pipidandan-superman/FPGA_2026_competition/report/figures/verified_fig_3_4.png

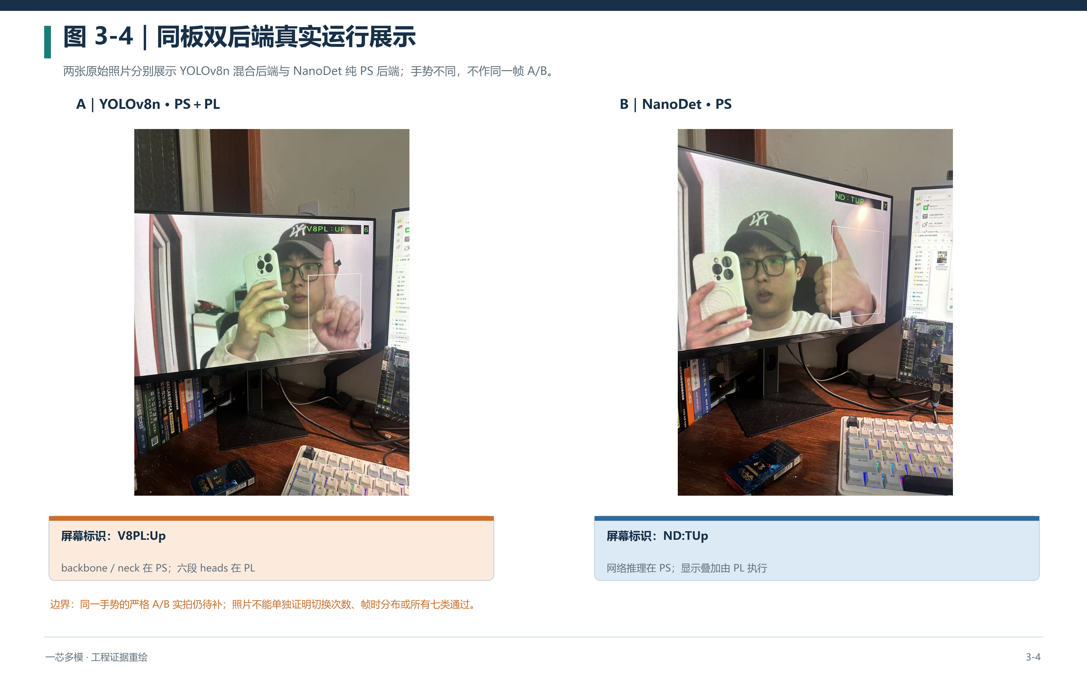
report/figures/verified_fig_3_4.png
