pipidandan-superman/FPGA_2026_competition/report/photos/photo_3_4a_dual_backend_1.jpg

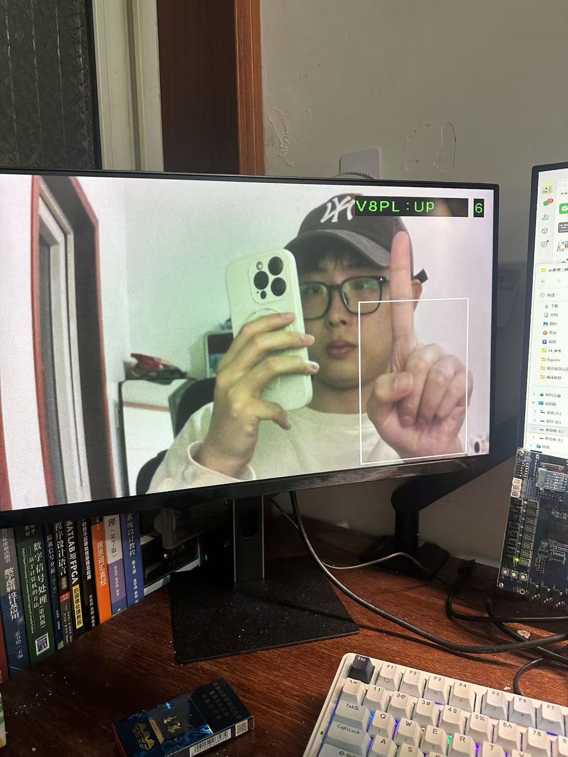
report/photos/photo_3_4a_dual_backend_1.jpg
