pipidandan-superman/FPGA_2026_competition/build/accelerator_ac1/reports/netlist_ff_fingerprint.txt

# routed-netlist fingerprint BID=INTEGRATION_AC1 PPU_ISLAND=1 IMPL_RUN=impl_ac2 (counts are design-dependent; ON baseline vs OFF comparison lives in the run README)
csr_awready_ff=2
csr_wready_ff=2
tick_cnt_ff=41
u_trace_cells=0
ring_ctx=0
ring_token=0
u_hbuf_cells=5784
u_hbuf_bram=8
wlay_dout_max=168
wlay_net_max=168
edge_node_ff=73
edge_win_ff=137
nedge_ff=6
slot_state_ff=125
slot_base_ff=296
slot_wm_ff=296
chain_rel_ff=2
s2l_ff=1
join_tab_ff=665
ppp_wp_ff=0
ppp_total_ff=0
frame_token_nets=33
ovf_ring_ff=480
ovf_tot_ff=43
knifeB_s1err_ff=65
knifeB_s1seen_ff=14
knifeB_s1node_ff=37
u_segd_cells=12
segd_commit_nets=1
commit_gate_nets=0
seg_done_pl_nets=4
cur_gen_q_ff=8
pl_mode_q_ff=2
desc_count_ff=18
u_ppu_cells=18926
u_ppu_dsp=10
u_ppu_bram=10
u_repack_cells=760
u_repack_bram=4
