pipidandan-superman/FPGA_2026_competition/skill/zynq-pynq-overlay-workflow/references/ees331.md

# EES-331 reference profile — verified scope, not universal defaults

Source workspace: E:/competition. Its workspace policy and daily-log override apply: raw evidence under 4_metrics/logs/<new-run>, engineering records under 7_logs/YYYY-MM-DD. Frozen project changes require explicit authorization.

## Board/runtime

- Zynq xc7z020clg484-1; Vivado 2025.2; PYNQ 3.0.1 / Linux 5.15.19, ARMv7.
- Existing design reference: 33.333333 MHz crystal, IO PLL multiplier 30, DDR 32-bit MT41K256M16 RE-15E. Check live values and generated configuration; do not blindly reinitialize running PS DDR/PLLs.
- Existing network: board 192.168.240.10/24, PC 192.168.240.2/24. These are configuration candidates, not discovery results. Since the 2026-10-02 lab-switch re-cable the board sits on DHCP behind the switch (observed address 192.168.240.10; the old direct-attach static path is gone) and the PC peer is REACHABLE — discover the board live (arp/SSH) instead of assuming. No credentials belong in this skill.
- Board swap 2026-09-23: a same-model replacement board runs the same SD card (static IP and /home assets migrate with it); its ARP MAC is 4a:ea:a7:ad:89:b1 (previous unit 46:2e:60:16:ac:3f). Treat the MAC as a liveness/identity probe read live from ARP, never as a fixed assumption. MAC-randomization update (2026-10-08, T12 run01): after a cold boot the replacement unit came up with a DIFFERENT, locally-administered MAC (36:10:06:56:3f:d3), so the ARP MAC is NOT a stable per-board identity across cold boots — verify the host instead by its console (FTDI COM port, getty prompt xilinx@pynq) and SSH banner (OpenSSH_8.9p1 Ubuntu-3), and treat an unexpected MAC on the expected IP as a re-randomization candidate, not proof of a foreign device. Evidence: 4_metrics/logs/2026-10-08_yolo_t12_wr_calib_run01 (reachability_diagnosis.md). P0-B baseline and B3-S1 window totals reproduced bit-identically on the replacement (4_metrics/logs/2026-09-23_yolo_p0b_newboard_run01).
- PYNQ Python: /usr/local/share/pynq-venv/bin/python3; application environment XILINX_XRT=/usr. Confirm on target.
- Original service ees331-camera runs /home/xilinx/ees331_camera/run_camera.sh and camera.py; it loads its own validated overlay and manages VDMA/CMA. Never overwrite its BIT/HWH/app for an independent test. **Regime change (2026-10-02 lab-switch re-cable, proven 2026-10-03): the camera's UDP peer 192.168.240.2 (the PC) is now REACHABLE, so the service streams PERSISTENTLY and no longer self-exits — the 2026-09-19 profile "streams then failed-terminal at ~70 s" is OBSOLETE under the new cabling (it only held while UDP was broken and camera.py timed out).** The zocl lock still auto-releases early (boot+~54 s, dmesg `unlocked, ref=0`) but the fabric VDMA keeps DMA-ing on the HP ports with no owning process (MM2S_DMACR 0x1008b, RS=1). Downloading any overlay under that live VDMA reconfigures fabric mid-AXI = the M13-proven whole-PS silent death (0-byte console, no sentinel, ARP silence; killed two S3d rounds on 2026-10-02 — the identical bitstream+driver passed once the camera was quiesced, exonerating the fabric). Quiescing canon when the service is live: `systemctl stop ees331-camera` (stop only, never disable; camera.py has a clean SIGTERM path request_stop → finally → VDMA_HALTED + BUFFER_FREED), then verify the halt at REGISTER level — resolve the axi_vdma_0 base via `Overlay(bit, download=False).ip_dict['axi_vdma_0']['phys_addr']` and read MM2S_DMACR/S2MM_DMACR (offsets 0x00/0x30, RS = bit0) through /dev/mem; require both RS bits clear AND both DMASR Halted bits (offsets 0x04/0x34, bit 0) set. Journal markers can be absent even after a clean stop — process exit and journal lines are not proof, registers are. Restore with `systemctl start ees331-camera` or the next cold boot (autostart untouched). Evidence: 4_metrics/logs/2026-10-02_yolo_p2_2_s3d_design_run01 (stop/verify/launch scripts + RUN_LOG).
- Original service restart reloads the original PL. Await streaming progress and physical HDMI, not merely active. Stop failures or DMA-not-halted reports block reconfiguration.
- Known PS console COM6 and PL USB-UART COM4 are historical assignments: enumerate current ports and verify their identity before access.

## PL clock (FCLK) register facts — probed on board 2026-09-19

- FPGA0_CLK_CTRL (SLCR 0xF8000170; FCLK1-3 at 0x180/0x190/0x1A0) layout, proven by an on-board refused-write experiment: **DIVISOR0 [13:8], DIVISOR1 [25:20], SRCSEL [5:4]** (0=IO PLL) — pynq 3.0.1 `ps.py ZYNQ_CLK_FIELDS` is the hardware truth; **bits [3:0] are reserved and write-ignored** (a write of 0x…05 read back 0x…00, and div1 was left 0 = undefined fabric clock until restored). `Overlay.download()` programs FCLK divisors from the HWH clock_dict and the write lands correctly — never "repair" it with a hand-rolled layout from memory.
- Probe-proven PLL constants (PLL_CTRL 0x100/0x104/0x108, FBDIV [18:12], ref = 33.3333 MHz crystal): IO FBDIV=30 → 1000.00 MHz, ARM 40 → 1333.33, DDR 32 → 1066.67; CPU = ARM/2 = 666.67. True FCLK = PLL / (div0 × div1).
- **pynq 3.0.1 reports every MHz 1.5× high on this board** (`_ClocksZynq.DEFAULT_SRC_CLK_MHZ = 50.0` vs the actual 33.3333 crystal): reported 150 = true 100, reported 75 = true 50. `Clocks.fclk0_mhz` can also raise ZeroDivisionError when the divisor product is 0. Gate frequency on the raw register + PLL-derived true MHz; log pynq's report as informational only. Raw /dev/mem + sudo is the standalone probe path (pynq MMIO raises "No Devices Found" with no zocl device open; bare xilinx user gets PermissionError on /dev/mem). On some boots the kernel blocks /dev/mem access to the SLCR range even as root (PermissionError on the 2026-10-03 S3d boot) while plain MMIO-region reads still work — on such a boot fall back to the HWH/PCW parameters for clock facts instead of forcing the register read.
- Reference states seen on this board: boot FPGA0 = 0x00101400 (IO÷20 = true 50 MHz); FPGA1-3 boot residual 0x00100F00 (IO÷15 = 66.67 MHz); after downloading an HWH with (div0=5, div1=4) the register is 0x00400500 = true 50 MHz; with (5, 2) it is 0x00200500 = true 100 MHz. Evidence: `4_metrics/logs/2026-09-19_yolo_gemm_freq_run25_fclk100/` (three-attempt CK_F narrative incl. the self-correction).

## Camera overlay hot-reload: proven load sequence

A camera/VDMA overlay loaded while Linux runs needs more than a successful bitstream download. v1.3 proved that BIT download plus fpga_manager `operating` can still fail first-frame recovery (`FIRST_FRAME_TIMEOUT`, both slots static, seen=[false,false]) and be misread as "cannot load online". The proven sequence (PL Reloader v1.4, 2/2 board acceptance) is:

1. Stop the original ees331-camera service safely: require an active camera.py owner, then journal evidence of VDMA_HALTED followed by BUFFER_FREED — and, as the hard gate, register-level RS=0 in both DMACRs (see the camera bullet under Board/runtime for the /dev/mem read); otherwise abort; restore only after ownership release and register halt are proved.
2. Build `Overlay(bit, download=False)`, validate the HWH hardware contract and VDMA parameters (C_NUM_FSTORES 3, C_INCLUDE_SG 0, 24-bit MM2S/S2MM, genlock 3/2) from ip_dict before downloading.
3. `download()`, then require `/sys/class/fpga_manager/fpga0/state` == `operating`.
4. Wait an explicit ~10 s sensor settle before touching VDMA: hot reload loses the bare-metal implicit SCCB/sensor settling. This is a timed diagnostic gate, not proof that SCCB/PCLK/VSYNC are healthy.
5. Configure VDMA/CMA, then gate READY on a ~30 s first-frame window with ~1 s progress reports of both buffer slots; success requires real frame transitions, never service `active`, download completion, or file-sync markers.
6. On FIRST_FRAME_TIMEOUT/FAIL/DEGRADED: stop VDMA and prove both channels Halted before freeing buffers or restoring the original service. If halt cannot be proved, retain the process and buffer, block restoration, and diagnose. Require stream progress and physical HDMI confirmation after a valid restoration; UDP reception is a separate test.

For the fixed action payload use 8_tools/EES331_PL_Reloader_v1.4 (source 3_host/pynq/pl_reloader) rather than re-deriving this sequence. Constants in payload camera.py: SENSOR_SETTLE_SECONDS 10.0, FIRST_FRAME_TIMEOUT_SECONDS 30.0, FIRST_FRAME_PROGRESS_SECONDS 1.0.

Evidence in 4_metrics/logs: 2026-09-13_pl_reloader_v13_board_failure_audit_run01 (download PASS + first frame FAIL), 2026-09-13_pl_reloader_v14_board_acceptance_run01 and run02 (A→C success, run02 after confirmed power cycle).

## PS-only overlay baseline and proven stable reload flow (7x verified 2026-09-18)

A minimal PS7-only overlay (project `2_fpga/3_yolo_zynq/proj/yolo_zynq_test`, BD `display_test`) is the verified clean PL baseline. It was hot-reloaded **seven consecutive times without power cycling** — 5 cycles via `overlay_reload_gate.py` (run02) plus 2 full skill-literal rounds with fresh artifact directories per round (run03) — every reload gated on download return + `operating` + fresh dmesg lock, followed by ping/TCP/UDP/UART function probes, all PASS. User independently confirmed UART and Ethernet host-tool loopback on the final state. Evidence: `4_metrics/logs/2026-09-18_yolo_zynq_test_ps_overlay_run01` (first load + helpers), `..._run02_reload5x`, `..._run03_skillflow`.

Proven per-reload procedure (this IS the stable flow; scripts live on the board under `~/overlay_test/` and `~/overlay_skill_round_*/`):

1. Historical preflight recorded a failed-terminal service in that September run. Discover current boot ID, service state, FPGA state and owners anew.
2. Fresh independent directory per round; upload bit + same-basename HWH pair; sha256 both sides must match byte-for-byte.
3. Ownership: the historical no-client inference was insufficient. Always inspect DMA registers for the currently loaded design; absence of process clients does not establish a halted DMA.
4. Load as **root** via `/usr/local/share/pynq-venv/bin/python3` with `XILINX_XRT=/usr`: `Overlay(bit, download=False)` → verify HWH contract (`ip_dict == ['processing_system7_0']` for the minimal design) → `.download()`.
5. Gate the reload on all three: `download()` returned, `fpga0/state == operating`, **dmesg `zocl … 'locked, ref=1'` count incremented by exactly 1** (each download logs a fresh UUID, so the count is a per-reload download proof; `operating` alone never proves a load).
6. Function probes per the design contract (PS-only: ping, TCP+UDP echo :7777, `/dev/console` marker).
7. Repeat back-to-back without power cycling; no cross-cycle degradation observed in 7 consecutive reloads.

Load mechanics proven on this image (PYNQ 3.0.1): `Overlay.download()` configures PL clocks **before** downloading the bitstream, so a failure at `Clocks.set_pl_clk` (`OSError: Root permissions required` when not root) means **nothing was loaded**. Run the load as root (sudo takes its password on stdin); `/dev/console` milestone writes also require root. PS-only HWH parses fine. A BIT load does not replay the complete PS7 initialization or safely reinitialize DDR/MIO. PYNQ applies selected HWH clock metadata separately; compare the running PS configuration and candidate HWH before loading. The historical PS configuration was: UART1 MIO 48/49, ENET0 MIO 16-27 + MDIO 52-53 + reset MIO 47, IO PLL x30 (1000 MHz, boot-matching), FCLK0 disabled is the verified-safe PS-only set; effective clocks must match the running system before loading any new PS7 config.

Loopback helpers for host-side UART/Ethernet verification live on the board at `~/overlay_test/` (`net_echo.py` TCP+UDP echo on :7777; `uart_echo.py` raw 1:1 echo on `/dev/ttyPS0`, which requires stopping `serial-getty@ttyPS0` first — that silences the COM6 console until restarted). Stop `uart_echo.py` by PID: a SIGTERM kill skips its `finally` termios restore, so prefer Ctrl-C at its console or a signal handler that restores the port; never use `pkill -f <script>.py` from a remote shell — it matches the shell's own command line and kills it mid-chain. A nohup launch chain can hang the ssh client while the service actually started; verify with a separate `pgrep`/port check instead of trusting the launch command's exit.

## Independent AXLT ABI

Project: E:/competition/2_fpga/2_axi_lite_test; BD AXI_LITE_test; CSR 0x43C00000/4KiB, read from HWH rather than hard-code in reusable drivers. IP_ID 0x41584C54, ABI 0x00010000, CAPS 1 (register-only). Command produces bitwise complement; nonzero increasing sequence, DONE held until ACK. BRAM is not implemented.

Compile mmio_ordered.c on ARM with `cc -std=c11 -O2 -Wall -Wextra -Werror -fPIC -shared mmio_ordered.c -o libmmio_ordered.so`. It uses device-MMIO volatile accesses and DSB barriers while PYNQ owns the mapping. Use the delivered hardware_contract.py before downloading.

## PC-side (Windows) automation pitfalls — all verified 2026-09-18

Driving the board from Windows PowerShell over ssh has three quoting
traps that each cost a failed round before being identified:

1. **PowerShell double-quoted remote commands evaluate `$(...)`
   locally.** `'... $(systemctl ...) ...'` must be single-quoted as a
   whole so the subexpression reaches remote bash.
2. **PowerShell -> ssh native argument passing strips embedded double
   quotes.** `sudo -S sh -c "VAR=x cmd"`, `python3 -c "..."`, and any
   remote command containing `"` break with baffling bash syntax
   errors (`unexpected EOF while looking for matching '"'`). Rules:
   single-quote the entire remote command; keep it free of ALL inner
   quotes (use `env VAR=x cmd` instead of `sh -c "VAR=x cmd"`); upload
   anything nontrivial as a FILE and execute it — never inline
   `python3 -c` one-liners through ssh from Windows.
3. **PowerShell piping a string to ssh stdin appends `\r`, so
   `'<pw>' | ssh host 'sudo -S cmd'` fails sudo authentication.** Use a subprocess byte stream with an explicit LF to supply sudo -S on stdin;
   never interpolate a password into shell command text. The SSH login uses the askpass env
   pattern (SSH_ASKPASS + SSH_ASKPASS_REQUIRE=force + DISPLAY set,
   password only in the per-call subprocess environment).
4. **Windows OpenSSH cannot exec a `.py` askpass directly (CreateProcessW
   error 193).** Point SSH_ASKPASS at a `.cmd` wrapper that invokes the
   python askpass script (`3_host\pynq\pl_reloader\ssh_askpass.cmd`).

## PYNQ 3.0.1 HWH contract keys

For a module-reference IP in `Overlay.ip_dict`:
- base address key is **`phys_addr`** (int), NOT `phys` — a `.get('phys')`
  returns None and falsely fails the contract gate (cost one round).
- aperture size key is `addr_range`; `parameters` carries
  `C_BASEADDR`/`C_HIGHADDR` (hex strings) and `PROTOCOL: AXI4LITE`.
- The interface's `FREQ_HZ` parameter reflects the actual PS7 FCLK the
  BD propagated (this project's preset: 50 MHz even with
  PCW_FCLK0_PERIPHERAL_FREQMHZ absent/dynamic in the BD Tcl) — the
  bitstream's timing closed at that frequency; do not assume 100 MHz.

## Concrete failure and proven correction

2026-09-13 run01 lost communication during the first full test. The recovered event file had a valid PREFLIGHT record plus NUL/truncated data, no result.json; the host's buffered logging lost partial stdout. Do not infer an exact failure instruction from that incomplete record.

Inspection found proc_sys_reset `C_AUX_RESET_HIGH=0` with aux_reset_in tied 0. Download-only subsequently succeeded with network alive. An official generated IP simulation simultaneously proved the faulty wiring holds reset and the corrected tie 1 releases reset and permits two CSR identity reads. Corrected BIT/HWH passed 1000 register commands and 3 reloads; after service restoration UDP yielded 60 complete changing frames with zero CRC/loss/header errors. Physical HDMI is separately recorded in the run's acceptance report.

The corrected release uses const_one for auxiliary reset and dcm_locked, const_zero for debug reset. Both external and auxiliary resets are active-low. Beware Vivado HWH constants may be hexadecimal (`0x1`); compare numeric values, not literal spelling.

Evidence in E:/competition/4_metrics/logs:

- 2026-09-13_axilt_reg_board_run01: initial failure retained.
- 2026-09-13_axilt_recovery_run01: original event fragment, download-only markers, live PS state.
- 2026-09-13_axilt_reset_sim_run01: official-IP defect reproduction and corrected CSR simulation.
- 2026-09-13_axilt_reset_fix_build_run01: corrected BD, timing, hashes, prior release backup.
- 2026-09-13_axilt_reg_board_run02: 1000 commands/3 reloads, event audit, 15 Python tests, video restoration.

These local evidence links are provenance. If unavailable in another workspace, obtain that project's own evidence rather than claiming these runs validate a different board or design.
