pipidandan-superman/FPGA_2026_competition/report/README.md

# report/：设计报告与大模型协作记录

本目录对应 AMD §3.3.5.3 和 §3.3.5.4 的设计报告与协作记录要求。文件名使用英文小写，正文保留中文。

## 文件

| 文件/目录 | 内容 |
|---|---|
| `technical_report_v8.docx` / `.pdf` | 当前正式报告：OPU 组织思想及引用、同 BIT 在线切换、五类工程、优化对比、锁布局消融、AI 协作、Skill 提炼和复现入口；41 页、18 图、16 表、14 项独立著录参考文献 |
| `technical_report_v4.docx` | 历史技术报告，保留用于版本追溯 |
| `ai_collaboration_records_summary.md` / `.docx` | 多平台大模型协作归纳，含提示词、回答、失败观察、自我纠错和证据边界 |
| `amd_ross_reflections.md` | AMD ROSS 使用心得 |
| `figures/` | 报告架构、微架构、调度、训练、性能、资源和协作机制图件 |
| `photos/` | 板卡与演示实拍；历史版本照片在正文中明确标注，不冒充当前位流验收 |

## 当前验证

- V8 正式报告含 **18 张嵌入图**，图内不重复标号，图下保留编号；开发板实物位于 2.2.1，工程二注明与图 2-6 同架构；2.6.5 含锁布局消融分组表和结果对比图。
- DOCX 完整结构验证通过；41 页 PDF 全部检查，无空白页、内容丢失、裁切或重叠；九项模板限字全部通过。
- 最终 MinerU 结果为 `MINERU_PARSE_PASS`，输入 SHA-256、Markdown 和 content JSON 在 `2026-11-04_report_v8_reference_layout_run02` 留档。
- 报告区分历史板测、本次 Vivado 工程验证、完整 BIT 重建和未执行项目；纯 PL 连续日志只覆盖六类，缺 Down；多网络不同任务切换仍属未验证方向。

## 协作记录口径

案例覆盖 Claude Code、ChatGPT/Codex、Kimi、Zcode 等平台。逐字摘录与二手归纳分别标记；包外原始会话索引仅用于作者侧溯源，不冒充完整原始会话交付。密钥、凭据和私有配置不纳入公开仓库。
