pipidandan-superman/FPGA_2026_competition/src/host/README.md

# AI PC 侧（3_host）调研启动文档

> 负责人：本队 AI PC 分工成员 ｜ 硬件已到位：MINISFORUM UM790 Pro
> 目标对齐：README 量化指标（mAP@0.5:0.95 ≥ 0.7，单样本推理 ≤ 30ms，batch=1）

## 1. 硬件档案（UM790 Pro —— 状态：**未到位**）

| 项目 | 规格 | 对本项目的意义 |
|---|---|---|
| CPU | Ryzen 9 7940HS，8C16T，Zen4 | 后处理/业务逻辑 |
| iGPU | Radeon 780M（RDNA3, gfx1103, 12CU） | 备选推理后端（DirectML/ROCm） |
| NPU | XDNA 第一代（Phoenix AIPU，约 10 TOPS） | **主推理后端**（INT8） |
| 内存 | DDR5 5600 双通道（可至 64GB） | 模型与图像缓冲 |
| 网口 | RJ45 2.5G ×1 | 与 FPGA 的 UDP 通信链路 |
| 系统 | 预装 Windows 11 | Ryzen AI Software 官方路径 |

**合规性**：7940HS 属 Ryzen AI（Phoenix）平台，符合赛题"任意 AMD Ryzen AI PC，型号不限"；属自备机，不影响中期 AI PC 借用申请（10-09，Max+395/HX370 十台名额）。

**合规红线**：评分项"AI PC 端侧 AI 能力（20 分）"要求模型**在 AI PC 本地运行**且考察**离线运行能力**。服务器/云端只能用于训练与调优，推理必须在 AI PC 本地。决赛演示须断网可跑。

### 1.1 当前无目标机：服务器先行策略

现状：只有组内服务器（CPU 型号与目标机不同），UM790 Pro 在谈。**阻塞是有明确边界的**：

| 工作项 | 服务器可做？ | 说明 |
|---|---|---|
| 数据集采集/标注/增广 | ✅ | 手机/公开数据起步，与硬件无关 |
| YOLO 训练/微调/精度调优 | ✅ | 用服务器 GPU，产出与目标机无关 |
| 导出 ONNX + 功能验证 | ✅ | ONNX Runtime CPU EP 即可等价验证 |
| INT8 量化（calibration） | ✅ | 量化校准跑 x86 CPU，不需要 NPU |
| 预处理/后处理/UDP 协议栈 | ✅ | 纯软件，mock 联调可两台服务器对跑 |
| **NPU 部署栈验证**（驱动/EP/算子支持） | ❌ | XDNA NPU 是目标硅片专属，无实用模拟器 |
| **INT8 精度在 NPU 上复现** | ❌ | 量化精度损失只能在目标机确认 |
| **延迟/FPS/功耗实测**（metrics 证据） | ❌ | 必须在 AI PC 上测，服务器数据无效 |

**结论：阻塞的只是"目标机部署验证与性能实测"这一段（约占总工作量 30%），其余 70% 立即开工。**

三条并行解法：
1. **服务器先行**：把模型选型、数据、训练、ONNX 定稿、量化、CPU EP 全链路 pipeline（含 UDP mock）在 9 月内做完，把"目标机适配"压缩成一个清单化的晚期任务
2. **落实 UM790 Pro**：明确到位 deadline=**2026-09-20**（NPU demo 里程碑）；谈不下来评估自购（迷你主机价位 ~3k）或借用
3. **官方借用兜底**：10-09 中期申请报告全力写好——评审通过发 Ryzen AI Max+ 395 / HX 370 整机；即使 UM790 到位，借用机也是性能更强的备选

风险预案：若 9-20 仍无目标机，先用 ONNX Runtime CPU EP 打通"收帧→推理→回传指令"全链路（功能正确性不受阻），NPU 量化部署顺延；同时核对 YOLOv8n 算子集在 Ryzen AI 编译器的支持清单，备好 YOLOv5n 退化方案。

## 2. 应用场景选型（建议）

**桌面级彩色几何积木分拣**（视觉识别与自动分拣的落地形态）：

- 类别：红/蓝/绿/黄 4 色积木（可选扩展形状：方块/圆柱）
- 理由：①数据集可自采自标（OV5640 现成，几百张即可起步）；②演示直观、评审友好；③与 4-DOF 舵机臂复杂度匹配；④纯色块对 YCbCr 转换/光照不敏感，检测稳定
- 工位设计：FPGA 摄像头俯拍传送带/分拣盘，AI PC 检测 → 输出目标类别 + 像素坐标 → 换算抓取策略下发

## 3. 模型选型（建议）

| 优先级 | 模型 | 理由 | 风险 |
|---|---|---|---|
| 主选 | **YOLOv8n**（Ultralytics） | COCO 预训练成熟；ONNX 导出顺畅；640 输入小模型够用；社区量化经验多 | Ryzen AI EP 对新算子支持偶有滞后 |
| 备选 | YOLOv5n | Ryzen AI 官方示例级兼容，量化链路最成熟 | 结构较老 |
| 观察 | RT-DETR / 轻量 Transformer | 组内有 Transformer 经验 | NPU INT8 支持差，当前阶段不用 |

**部署链路**：PyTorch 训练（可在学校服务器）→ 导出 ONNX → Ryzen AI 量化（INT8）→ ONNX Runtime + VitisAI EP 跑 NPU（Windows）。

**性能预期（需实测填入 metrics.csv）**：
- YOLOv8n INT8 @ NPU：单帧 ~10–20ms（batch=1）
- 后备链：DirectML 跑 780M iGPU；再后备 CPU 8 线程
- 三条后端的延迟/精度对比表本身就是"FPGA/端侧贡献"之外的加分证据

## 4. 通信（与 FPGA 侧对齐）

- 链路：UM790 Pro 2.5G RJ45 ←网线直连→ EES-331 PS 千兆口（静态 IP，点对点）
- 协议：UDP（README 定的 RTT < 5ms）
- 起步：FPGA → AI PC 传整帧（640×480 YUV422 ≈ 600KB/帧，30fps ≈ 18MB/s，千兆余量充足）
- 演进：FPGA 侧 CNN/预处理就位后改为传特征/检测框，压缩带宽与延迟
- 待 FPGA 侧确认：EES-331 网口 PHY 型号与驱动（PS GEM）

## 5. 里程碑（对齐 1_docs/timeline_milestones.md）

| 目标 | 时间 |
|---|---|
| 服务器上：YOLOv8n COCO 预训练跑通 + ONNX 导出 + CPU EP 推理验证 | 2026-09-13 |
| 服务器上：UDP 协议栈 + mock 联调（帧格式/指令格式定稿） | 2026-09-20 |
| 自采分拣数据集 v1（≥500 张）+ 微调 + INT8 量化 + 精度对比 | 2026-10-06 |
| 目标机到位（UM790 Pro 或借用机）：NPU 部署 + 三后端延迟实测 | 随机器到位，越早越好 |
| 与 FPGA 侧 UDP 链路联调（收帧 → 推理 → 回传指令） | 2026-10 月中 |

**主机到位 deadline：2026-09-20**（超出则走 CPU EP 预案，NPU 部署顺延但绝不空等）。

## 6. 开放问题

- [ ] Windows 11 还是 Ubuntu？（Windows：NPU 官方支持最稳；Ubuntu：与 PYNQ/FPGA 工具链同生态、ROCm 原生。建议先 Windows 跑通 NPU，后期按联调需要评估）
- [ ] Ryzen AI Software 版本与 7940HS NPU 驱动配套（记录版本号进 metrics 测量条件）
- [ ] 自采数据的类别定义与标注工具（建议 LabelImg/Roboflow， early 固定类别表）
- [ ] 检测坐标 → 机械臂坐标的手眼标定方案（等机械臂到位后启动）
