pipidandan-superman/FPGA_2026_competition/report/ai_collaboration_records_summary.md

# 大模型协作交互记录归纳总结（V2.0）

**作品名称：一芯多模——面向资源受限 Zynq 平台的多网络视觉推理与在线切换系统**
**协作平台：Claude Code、ChatGPT／Codex、Kimi、Zcode**
**版本：V2.0（四平台本机原始记录核对版）**
**整理日期：2026-11-03**

## 编制说明

本文件依据工作区工程日志、审计报告、仿真与板测证据，以及**四平台在本机的原始交互记录**，对项目开发过程中的大模型协作进行归纳，重点保留提示词、模型回答、失败观察、自我纠错、人工复核与分层验收之间的关系，而不是只罗列最终成功结果。

**V2.0 相对 V1.0 的修订要点**：

1. V1.0 成稿时标注了两处证据缺口（"Zcode 原始会话尚未检索到"、"Codex 部分原始会话文件已不在原记录路径"）。V2.0 已在本机完成四平台原始存储的定位与只读抽取归档，**两处缺口全部补齐**：Codex 历史会话以 zstd 压缩格式存放于 `~/.codex/sessions`（V1 检索时被遗漏），Zcode 会话存于本地 SQLite 数据库。V1.0 作为历史快照保留，正式提交以本版为准。
2. 引号内文字均为原始记录逐字摘录；标注"据工程记录概括"的提示词与回答为二手摘要，不冒充逐字对话。
3. **脱敏与安全边界**：全部抽取脚本对 API 密钥形态字符串（`sk-…`／`pk-…`／`eyJ…`）做正则替换为 `[REDACTED-KEY]`；`~/.codex/auth.json`、Zcode `config.json` 的 apiKey 与证书、Kimi 桌面端 token-store 等敏感库**绝不复制**，只以只读方式打开会话库。
4. **ChatGPT 口径**：本机可核验的 ChatGPT 家族工具为 Codex CLI／桌面端（rollout 会话记录）；网页版 ChatGPT 在本机无会话存储，不纳入本文件，也不以其他平台记录冒充。

## 一、提交要求与总体协作模式

竞赛要求提交能够体现大模型协作过程的交互记录，包括提示词、模型回答与自我纠错轨迹，并将协作经验沉淀为可复用 Skill。技能包应说明适用范围、使用方法、失效条件和已验证效果。

本项目采用"人工定义目标与边界 → 大模型生成方案或代码 → 真实工具执行 → 原始证据检查 → 模型或人工纠错 → 分层验收 → Skill 沉淀"的协作模式。大模型不是最终验收者：仿真、构建、板测和用户实机目检分别承担不同层级的验收职责。

### 1.1 四平台本机原始记录覆盖（V2.0 实测清点）

| 平台 | 本机原始存储 | 规模（实测） | 工程相关范围 | 抽取归档产物 |
|---|---|---|---|---|
| Claude Code | `~/.claude/projects/E--competition/*.jsonl` | 22 个会话，487.6 MB，1575 条用户消息 | 2026-10-11 → 11-03（另 09-30 起经 ROSS 委派参与） | `claude/sessions_index.csv` |
| ChatGPT／Codex | `~/.codex/sessions/YYYY/MM/DD/rollout-*.jsonl(.zst)` | 340 个 rollout（全机全部项目） | 157 个工程 rollout，2026-09-01 → 10-11（含早期 Desktop 工作区时期） | `codex/all_sessions_index.csv`、`codex/landmark_sessions_full.jsonl`（73 个关键日会话全文 1763 行）、`codex/thread_turns_errors.csv`（176 条失败轨迹） |
| Kimi | kimi-desktop 桌面端会话库 + `…\daimon\agents\main\memory\transcripts\days\` | 35 个会话、44 个转录日 | 18 个工程工作区会话（2026-10-26 → 11-03 密集期；10-12 起使用） | `kimi/conversations.csv`、`kimi/landmark_days_full.jsonl`（5 个关键日 5269 行） |
| Zcode | `~/.zcode/cli/db/db.sqlite` | 22 个会话 | 10 个工程会话，1147 条消息，2026-09-08 → 09-21 | `zcode/sessions.csv`、`zcode/competition_messages.jsonl`、`zcode/openings.txt` |

以上抽取产物全部位于证据目录 `4_metrics/logs/2026-11-03_ai_collab_v2_run01/`，只读抽取、密钥脱敏，不动原始存储。

### 1.2 协作时间线与项目方向演进

项目的选题方向本身经历了两次用户裁定的转向，构成最高层级的"自我纠错轨迹"；四个平台的入场与退场时间与之对应：

| 时间 | 方向／事件 | 主力平台 |
|---|---|---|
| 2026-09-01 前 | 初始选题：紫光同创 Logos-2 任意角度实时视频畸变矫正（RK3568 平台） | Codex |
| 2026-09-02 | **第一次转向**：改投 AMD 具身智能赛道（§3.2，作品名"锐眼·智行——具身智能分拣"）；GitHub 仓库恢复关联并改名 `FPGA2026_competition` | Codex（案例 X-01） |
| 2026-09-08 | GitHub 协同准则建立并于当日按用户要求简化；OV5640 寄存器配置审计；Zcode 首次入场做工程速览与以太网色差分析；Codex 发生编辑工具循环故障 | Codex、Zcode（X-02／X-03／X-05／Z-01） |
| 2026-09-09 → 09-14 | PYNQ 概念与部署计划梳理、FSBL/BSP 生成位置、工程完成比例盘点、YOLO 输入尺寸核查；SD 部署包 16 GB 损坏应急 | Zcode（Z-02／Z-03）、Codex（X-04） |
| 2026-09-19 → 09-21 | 主线 SPEC 与冲刺排期；09-21 GitHub 分支管理失控，排查并恢复队友分支（与 7_logs 事故记录互证）；当日沉淀 github-upload-policy v2（双人分支互批） | Zcode（Z-04／Z-05）、Codex |
| 2026-09-30 → 10-11 | Claude 经 ROSS 委派承担 B3-S3 方案审计与 RTL lint；Codex 平台故障频发（176 条错误轨迹），10-11 起 Claude Code 转为直接工程席位 | Claude（C-01／C-02／C-04） |
| 2026-10-12 → 10-18 | Kimi 入场：报名材料、赛题指南解析、ViT 加速器论文对照分析 | Kimi |
| 2026-10-14 | **第二次转向**：§3.2 旧口径停止执行，切换为 §3.3 自主选题·高级组"一芯多模"（README 切换声明留档） | 用户裁定 + 全平台 |
| 2026-10-26 → 10-29 | Kimi 作为"策略外脑"密集会话：硬件框图、技术报告、整图推理问题梳理（催生 3 天冲刺最终 SPEC）；Claude 主工程席 + 独立审计席双席互审 | Kimi（K-05）、Claude（C-05） |
| 2026-10-29 → 11-03 | 冲刺收官：完整 PL 推理实测 4.2671 s、三网络三任务 OSD、PS+PL 混合推理、报告 v4、§3.3.5.4 提交包打包、本归纳 V2.0 | Claude、Kimi（K-01～K-04） |

## 二、各平台协作分工概述

### 2.1 Claude Code

承担三类任务：一是对方案和已有工程进行只读审核（早期经 ROSS 委派，10-11 起直接入场）；二是通过 ROSS／Vivado MCP 执行 lint、仿真和状态检查；三是对"完成"结论进行独立复核。后期演化为"主工程席 + 独立审计席"双会话互审结构（案例 C-05）。其价值不仅是生成代码，更在于发现执行链、验收范围和证据链中的问题。

### 2.2 ChatGPT／Codex

工程前期（09-01 → 10-11）的主力席位：工程初始化、GitHub 管理、摄像头寄存器审计、SD 部署应急、Overlay／PYNQ 工作流与项目规则沉淀。典型纠错包括编辑工具误用循环、位流下载成功被误当系统功能成功，以及平台自身的基础设施故障（176 条错误轨迹，案例 X-07）——后者直接推动了 10-11 向 Claude Code 的席位迁移。

### 2.3 Kimi

三线并用：一是工程执行（三任务 OSD 修复、完整 PL 性能优化、PS+PL 混合推理，案例 K-01～K-03）；二是**策略外脑**——在关键决策点用独立会话对工程现状做只读梳理与重规划（案例 K-05），与其他席位的执行结论形成交叉检验；三是报告与表达（技术报告、创新点提炼、配图、评分预估）。

### 2.4 Zcode

轻量快答与资料定位席位（09-08 → 09-21，10 会话 1147 条消息）：工程速览、概念答疑（PYNQ／FSBL／bundle）、配置核查（YOLO 输入尺寸）、进度盘点，以及两次危机排查（以太网色差、GitHub 分支失控）。特点是从不直接改工程，先读 README／HANDOFF 与既有文档再回答，回答可回溯到仓库内具体文件。

## 三、Claude Code 代表交互与纠错轨迹

### C-01：RTL Lint 中空报告被解析器误读出两条记录（2026-10-03，ROSS 委派）

**任务提示词（原始提示词节选）**

> "Use the vivado-rtl-lint skill … Task: lint one RTL file in non-project mode … Use vivadoExecute for ALL Vivado commands … Never create .tcl files … Violation count in the markdown must exactly match Vivado's stated total; if Vivado says 0, report 0."

**模型回答与执行**

模型通过 Vivado MCP 启动 TCL 会话，以非工程方式读取 `yolo_silu_lut.v`，执行 `synth_design -lint`，再调用解析脚本生成 CSV。Vivado 原始报告给出 `Total of 0 linter message(s) generated.`，最终 lint 结果为 0 error、0 warning、0 violation。

**失败观察与自我纠错**

解析脚本在"零违规"空表上生成了两行伪 CSV 数据。模型没有直接把两行写成违规，而是核对 Vivado 原始总数，确认它们来自 `create_waiver` 帮助页脚，是解析器在空表边界上的误切片。随后重新生成真正的零行 CSV，同时保留原始错误输出 `lint_report.csv.raw-parser-output.txt`，使"CSV 行数＝Vivado 总数＝Markdown 数量＝0"。

**最终证据**

- `11_AMD_Ross_AgenticAI/evidence/2026-10-03_rtl-lint/nested_session_transcript.jsonl`
- `11_AMD_Ross_AgenticAI/evidence/2026-10-03_rtl-lint/rtl_lint_report.md`

该案例体现了"自动解析结果不能凌驾于原始报告"，也形成保留失败输出、禁止为凑结果删除证据的规则。

### C-02：B3-S3 方案从"单帧三描述符"纠正为"三帧真实桥接"（2026-09-30）

**任务提示词（据工程记录概括）**

对 B3-S3 设计书、能力盘点、L2 原始板测、驱动和 r9 RTL 进行只读工程审核，判断载体复用和门梯是否合理，不修改冻结工程。

**模型回答**

审核结论为"D1 有条件通过；原 S3a 不通过；门梯需修订后才能开工"。复用 r9 作为唯一位流载体合理，但把 L2 三段写成单帧内三个 descriptor，无法插入真实的 PS gather、buf patch 和 repack 操作，不能证明生产者输出被消费者真实使用。

**纠错轨迹**

原方案以"单帧三 descriptor 连续执行"作为 L2 级联门。审核后改为：

`frame A conv0 → 完成并闭帧 → PS gather／HWC＋buf patch → frame B mp5 → 完成并闭帧 → PS repack＋mirror patch → frame C conv1`

同时保留 walker-only 多描述符协议测试，但其结果只能命名 `WALKER_MULTI_DESC_PASS`，不能升级为 `L2_CHAIN_PASS`。

**最终证据**

- `4_metrics/logs/2026-09-30_b3s3_claude_audit_run01/AUDIT.md`

沉淀规则："协议测试不能替代真实数据链测试""预载数据不能证明生产者—消费者闭合"。

### C-03：M9"全线收官"结论被独立审计降级（2026-10-09）

**任务提示词（据工程记录概括）**

严格审计 M9 的板测、XSim、RTL、Vivado 实现记录和验收范围，核对"M9 全线收官／M9_INTRA_PASS"是否有充分证据。

**模型回答与纠错**

审计确认代表性 Conv 数据通路在板上可运行，但否定"层内流水已在板上闭合"和"完整 M9 收官"：板上只覆盖 5 个代表 Conv 而非完整 63 Conv；XSim 的 overlap 结果不能替代板上 overlap 证据；连续第二帧计数翻倍说明计数器清零与代际语义未闭合；最终 BIT 哈希、板端时钟和完整 post-route 报告没有形成统一制品链；"5.55 fps 整网代表层"被纠正为"5 Conv 代表 walk 首帧约 180 ms"。最终结论限制为条件化的 `BOARD_REPRESENTATIVE_CONV_PASS`。

**最终证据**

- `4_metrics/logs/2026-10-09_yolo_m9_claude_audit_run01/REPORT.md`

该案例说明模型已经写出的"PASS"也必须接受另一轮证据审计，不能由提交说明或单次首帧结果扩大验收范围。

### C-04：ROSS 仿真从重复命令错误转向结构化三段式流程（2026-10-11）

**任务提示词（原始提示词节选，本机会话记录）**

> "Use connected vivado-mcp only. Inspect M9.1 Face B stale run … If stale, rerun through Vivado"
> "Use only the connected vivado-mcp structured tools vivado_list_sessions, vivado_connect, vivado_start, vivado_execute, vivado_status, and vivado_log_messages. D…"

**初始回答与失败**

初期出现重复的无效 `set_property` 语法／选项错误，随后 `launch_simulation` 在 XSim 编译子进程阶段出现 `ERROR: [Common 17-180] Spawn failed`。上游 Claude 服务还出现 HTTP 429 限流。

**纠错轨迹**

1. 停止重复相同错误，不将"会话已连接"当成仿真通过。
2. 检查 MCP 子进程环境，确认仅配置 `VIVADO_PATH` 不足以保证 XSim 子进程可执行。
3. 修复 Vivado `bin` 与 `bin\unwrapped\win64.o` 的 PATH 配置。
4. Claude 不可用时按授权改用结构化 Vivado MCP 三段式 `xvlog → xelab → xsim`，最终获得 `TB_M91_LADDER_B_PASS` 与 M9.2 trace／engine PASS。

**最终证据**

- `7_logs/2026-10-11/03_validation_summary.md`
- `4_metrics/logs/2026-10-11_m9_faceb_xsim3step_run01/`
- `6_skill/vivado-ai-workflow/SKILL.md`、`6_skill/claude-ross-delegation/SKILL.md`

### C-05：主工程席＋独立审计席的双席互审机制（2026-10 下旬常态化）

**任务提示词（原始提示词节选，取自两个不同会话的开场）**

> "你是此工程对应的审计工程师，先找到主对话"
> "1.你是一个独立的审计工程师，2.先找到对应的主对话，3.独立严格的审计为什么目前的r12做了八个回合，到底是什么问题"

**机制说明与纠错价值**

冲刺期 Claude 会话分为两类：主工程席（最大会话 101 MB／397 条用户消息、95 MB／101 条"开始按照最新的spec执行，能并行的全部并行"、86 MB／360 条）负责执行；独立审计席（68 MB／168 条、24.9 MB／184 条等）只读主对话与证据目录，对关键结论、回合数异常、门禁链做二次审计。审计席多次将执行席的阶段性表述降级或要求补证据（与 C-03 同型），是本项目最核心的"模型回答也必须被另一个模型会话复核"的机制化落地。全部 22 个会话的规模、开场提示词与消息数清点见 `claude/sessions_index.csv`。

## 四、ChatGPT／Codex 代表交互与纠错轨迹

> 本节 X-01～X-04、X-07 的提示词与回答均为 `~/.codex/sessions` rollout 原始记录逐字摘录（脱敏后），抽取自证据目录 `codex/landmark_sessions_full.jsonl` 与 `codex/case*.jsonl`。

### X-01：GitHub 关联丢失恢复与第一次赛道转向（2026-09-02）

**任务提示词（原始）**

> "目前工程没有关联github吗，我记得关联过啊"
> "1.修改github端工程名称，直接叫做FPGA2026_competition 2.执行上述操作"
> "但是本地的文件和github不一致"
> "我已经删除了，目前以本地项目为标准。并且目前的赛题修正为amd的具身智能赛道，修正顶层的readme文件后，上传至github"

**模型回答与执行轨迹**

模型核对后发现当时工程目录确无 `.git`，判断为历史关联被删或在临时目录操作后拷贝。随后依次执行：`git init` → `remote add` → `fetch` → `pull --allow-unrelated-histories` → 推送 50 个文件恢复同步。仓库改名因无 API 令牌改为引导用户网页手动操作；HTTPS 推送连续 3 次超时后，改用 SSH（`git@github.com:…`）绕过阻断推送成功（提交 `3f3bca5`），并说明"远程地址已永久切换为 SSH，后续不会再遇到 HTTPS 连接问题"——该传输方式后来被 github-upload-policy 固化为 `ssh.github.com:443`。

**纠错要点与沉淀**

该会话同时完成了项目历史上第一次方向纠偏：同一天会话快照显示，工程从"紫光同创 Logos-2 畸变矫正（RK3568）"整体切换为 AMD 赛道，README 重写并推送。模型在方向突变时先保留旧目录结构证据（`2_log` 清理、文档迁移均留提交记录），不销毁历史。

### X-02：GitHub 交付准则从复杂 PR 流按用户裁定简化（2026-09-08）

**任务提示词（原始）**

> "你知道目前github准则要求吗"
> "更新github交付准则，不要这么复杂，不再设置软硬件负责人和共同区域，两人直接一人一个分支操作，对方批准才能进行main分支提交"

**模型回答**

先核对仓库现状再回答：找到未提交的 `1_docs/GitHub协同上传准则_草案.md`（`DRAFT_FOR_REVIEW`/`v1.0-draft`），逐条复述 8 条核心要求（main 可运行可回退、禁直推 main、PR 单主域、分支命名、无 4_metrics 证据不得写 PASS、冻结产物保哈希、协作前 `pull --ff-only`、PR 拒收条件），并指出当时工作区状态与草案的冲突风险（本地落后远端 4 个提交、大量未跟踪运行产物），明确"现在不适合直接提交或推送，应先分类"。随后按用户裁定改写为简化版。

**纠错要点与沉淀**

这是本项目协作规则"由繁入简"的一次显式纠偏：草案版的软硬件双域 PR 体系被用户判定过重，简化为"一人一分支、对方批准后才进 main"。该裁定先于 09-21 危机（Z-04）落地，最终演化为现行的 `github-upload-policy` v2（个人分支日常开发、里程碑直推 main、远端仅两分支）。今天的提交包打包（`E:\competition\github_version`）仍沿用该技能的凭据与边界约束。

### X-03：OV5640 寄存器配置审计以数据手册为唯一语义依据（2026-09-08）

**任务提示词（原始）**

> "查阅主工程的ov5640寄存器配置，看看当前的ov5640是工作在什么模式下"
> "查阅E:\competition\1_docs\ov5640\OV5640_datasheet.pdf，对照E:\competition\2_fpga\0_diaplay_test\rtl\ov5640_cfg内的配置代码，详细梳理出当前的配置，使用mineru解析pdf"
> "输出详细的ov5640配置报告至E:\competition\1_docs"

**模型回答（执行计划摘要，原文）**

> "以官方数据手册及 MinerU 解析结果为寄存器语义唯一依据；源码只用于提取实际写入值和顺序，忽略全部源码注释。报告的核心结论预计为：当前配置是 DVP 并行输出、640×480 VGA、RGB565、AEC/AGC 自动、水平 binning 开启、带横纵抽样、JPEG 未启用。这是静态配置审计，不宣称构建、上板或图像功能 PASS；实际 DVP PCLK 和帧率在证据不足时明确标为无法确认。"

计划还明确补齐并解析全部 251 个 case 项（含参数化的 `0x3809=0x80`、`0x380B=0xE0`），按官方寄存器表分组说明复位、SCCB 流程、PLL 分频与 DVP 时序。

**纠错要点与沉淀**

"源码注释不算证据、数据手册才是语义正典、静态审计不得宣称板级 PASS"三条边界全部写入了后续的 mineru-doc-reader 技能与工程审计口径。该审计结论同一周即被 Zcode 的色差分析会话（Z-01）复用为参照基线。

### X-04：SD 部署包 16 GB 损坏应急与"在线重加载"复现（2026-09-13）

**任务提示词（原始）**

> "E:\competition\9_pynq\sd\02_integrated_camera_hdmi_udp 我队友下板部署此sd包，提示需要root密码"
> "目的：工程复现（axi下发模型识别结果在pl的led的版本）其实我一直都有一个困惑，针对于zynq配置没有任何配置修改的工程，确实可以在线加载PL，并且不用重写sd卡，具体的加载步骤是什么。……2.我复现完毕成功后（我明确告知你），你再做一个应用程序，我可以在上电后直接使用此应用，直接在线加载必要的文件进去即可实现pl的重加载"
> "你能不能把我的sd卡部署包拷贝一份"
> "貌似损坏了，因为我的sd卡是一张16g的卡"

**模型回答与执行轨迹**

先按工作区规范只读核对"SD 部署包"的准确源路径与可复制目标、确认不碰冻结的 `2_fpga/`；再对 16 GB 卡做**只读 CHKDSK**（FAT 卷、卷标 PYNQ、2022 年创建），确认物理介质而非镜像问题后放弃整卡克隆，转向"镜像内资产保护 + 免重写 SD 的 PL 在线重加载"路线——这正是后来 `pl_reloader`／`sd_boot_builder` 工具链和 zynq-pynq-overlay-workflow 技能的起点。

**纠错要点与沉淀**

本次应急后，"SD 镜像等大二进制永不入 Git 普通对象、原地保护、只记 SHA-256"写入 github-upload-policy（当前技能第 11/13 条的雏形）；"在线重加载而非重写 SD"成为本项目后来"多网络在线切换"作品形态的早期技术直觉来源之一。

### X-05：文件编辑工具选择陷入循环（2026-09-08，V1 案例保留）

**任务提示词（据工程记录概括）**

更新 GitHub 协同上传准则并修正文档版本。用户通过截图指出模型反复声称更换编辑方式，实际仍调用同一种错误批量补丁。

**模型回答与自我纠错原文（工程日志保留）**

> "Patch tool can't batch delete/add same path. Use replace_file."
> "Oops again same. Why? The tool listed ... replace_file but I called apply_patch_batch."
> "I'm in a loop."
> "I repeatedly selected wrong tool due interface perhaps."

**失败观察与纠正**

模型多次选择批量 delete＋add 或冗余 `raw_patch`，被校验器拒绝。后续重新检查真实工具注册表，确认当前环境只有一个 freeform `apply_patch`。项目随即将编辑纪律写入 `AGENTS.md`：单文件原地修改、禁止同路径 delete＋add 模拟替换、禁止 JSON／operations 包装、补丁被拒绝后先读取文件再修正一次，不进入重试循环。

**证据边界**

`7_logs/2026-09-08/03_validation_summary.md` 保留纠错原文与根因；早期 `4_metrics` 证据目录已失联，本案例不声称保有完整原始会话。

### X-06：Overlay 下载成功与系统功能成功分离（V1 案例保留）

早期流程容易把 BIT 下载、FPGA Manager 显示 `operating` 或 PYNQ Overlay 无异常当成部署成功。板级问题表明下载成功不能证明 AXI 可访问、摄像头已恢复、VDMA 已停止或旧任务能恢复。纠错后拆分为：元数据解析、下载、存活、身份读取、功能命令独立检查点；替换位流前停止真实所有者并读 VDMA MM2S／S2MM 的 RS 位；重启后首次下载设硬门；下载后加摄像头稳定等待与首帧超时门。沉淀为 `6_skill/zynq-pynq-overlay-workflow/SKILL.md`。

### X-07：176 条平台故障轨迹——基础设施层的"失败也是记录"（09 月～10 月）

对 `~/.codex` 线程错误账本的清点得到 **176 条失败回合**，抽样分类（原始摘录见 `codex/errors_sample.txt`）：

| 故障类别 | 典型原始报错（节选） | 处置 |
|---|---|---|
| 上游接入被封 | "Access blocked by Cloudflare … (status 403 Forbidden), url: https://cooper-api.com/v1/responses" | 多次重试无效，换通道 |
| 代理参数不兼容 | "CC Switch local proxy failed … Provider: Zhipu GLM; model: glm-5.3; upstream_status: HTTP 400; cause: messages.content.type 参数非法" | 属通道侧与上游协议不匹配，非工程错误 |
| 本地代理崩溃 | "unexpected status 502 Bad Gateway … url: http://127.0.0.1:57321/v1/responses"（最长单回合 666678 ms） | 等待恢复或中断 |
| 流式超时 | "stream disconnected before completion: idle timeout waiting for SSE"（最长 3993125 ms） | 拆分回合重发 |

这些记录说明协作中断本身被平台留痕。持续的通道不稳定（叠加 10-11 的 Claude ROSS 委派链成熟）促成了工程主力席位在 10-11 从 Codex 迁移到 Claude Code；迁移后 Codex 仍偶有使用，但不再是主执行席位。

## 五、Zcode 代表交互与纠错轨迹

> 本节提示词与回答摘自 `~/.zcode/cli/db/db.sqlite` 会话库（只读打开副本），逐字摘录见 `zcode/openings.txt` 与 `zcode/competition_messages.jsonl`（1147 条消息）。

### Z-01：以太网显示色差与摄像头寄存器协同校正（2026-09-08）

**任务提示词（原始）**

> "目前以太网显示颜色出现偏差，hdmi看起来会好一些，我认为将以太网端显示的色差纠正后也会使得后端的hdmi显示更佳。色差如图所示，号数一致说明是同一颜色，清晰的照片为苹果相机拍照。情分析图片色差原因，对照开始所整理的摄像头寄存器配置协同处理。"

**模型回答（开场推理，原文）**

> "我先看一下工作区的项目策略和目录结构，找到之前整理的 OV5640 寄存器配置和以太网显示链路代码，再对照图片分析色差。"
> "策略已确认：`2_fpga` 是冻结基线，改动需要谨慎。先并行探索项目结构，找到寄存器配置文档、以太网链路代码和 HDMI 字节序修复的记录。"

**纠错要点**

模型没有直接给"调寄存器"的泛泛建议，而是把问题锚定到三份既有工程资产：OV5640 审计报告（X-03 产物）、以太网链路代码、HDMI 字节序修复记录，并显式声明冻结基线边界后才提校正方案。这是"新问题先挂接到已有证据链"的典型协作形态。

### Z-02：PYNQ 概念、赛题要求与部署计划定位（2026-09-09/10）

**任务提示词（原始）**

> "pynq是什么，赛题要求这样做"
> "pynq部署计划有吗"

**模型回答（原文）**

> "我先直接回答 PYNQ 是什么，同时在仓库里找一下赛题文件，确认赛题对 PYNQ 的具体要求。"
> "找到了，有一份《EES-331_PYNQ从零部署计划》。我读一下内容和当前进度。"

**价值**

新人视角的概念问题被转化为对仓库内正式文档的定位与复述，避免口头解释与项目实际流程脱节。同期会话还包括 "XSA 的 FSBL BSP是什么东西，需要在哪里生产"（09-11），回答同样先盘点工程内已有 Vitis 平台工程与 BSP/FSBL 目录再讲解。

### Z-03：工程完成比例盘点与 YOLO 输入尺寸核查（2026-09-13/14）

**任务提示词（原始）**

> "此工程我的完成比例是多少"
> "目前的yolo模型入口尺寸是什么，查阅host路径下相关文件"

**模型回答（尺寸问题结论，原文节选）**

> "查完了，结论如下：当前 YOLO 模型的入口（输入）尺寸是 640×640（`imgsz=640`，NCHW 形状 `[1, 3, 640, 640]`，float32，数值域 0~1）。host 路径下的依据：MODEL.md（3_host/model/，手势识别 YOLOv8n gesture_v1）：第 31 行：ONNX …"

**价值**

"完成比例"这类模糊问题被映射到 HANDOFF.md／README.md 的进度记录；尺寸问题给出了带文件与行号的证据。轻量快答不轻率，是 Zcode 席位的定位。

### Z-04：GitHub 管理失控排查与队友分支恢复（2026-09-21）

**任务提示词（原始）**

> "我的github管理现在失控了，请你查询现状，然后恢复我队友的分支"

**模型回答（开场推理，原文）**

> "我先查询当前 git/GitHub 的现状（本地分支、远程分支、以及最近那次'分支清理'到底删了什么），再决定怎么恢复队友的分支。"
> "本地只剩 `main` 和 `codex/full/pipidandan-superman`，远程也是。最近三个提交正好是'分支整合/远程分支清理'的记录。我先看这些记录里到底删了哪些分支，再查远程实际状态。"

**纠错要点与互证**

该会话与 `7_logs/2026-09-21` 的事故记录（分支清理误删队友远程分支）互为印证：先取证（本地／远端分支快照、清理提交内容）再恢复，不凭记忆操作。当日另一会话（Z-05）与 github-upload-policy v2 的出台同日，构成"事故→术语澄清→规则升级"完整链条。

### Z-05：bundle／stash 术语澄清（2026-09-21）

**任务提示词（原始）**

> "bundle 完整备份 stash 是什么意思"

**模型回答（原文）**

> "我先看一下这个说法是不是来自仓库里的某份文档，再解释含义。今天的文档 `1_docs/yolo_ppu_followup_replan_20260921.md` 里提到了 bundle，我看一下具体上下文。"

**纠错要点**

回答前先回溯术语在工程文档中的出处，避免脱离项目语境的通用解释。同日发生的 `git stash -a` 吞掉本地 SD 资产事故（4 GiB 截断）使 stash／bundle 边界成为正式禁令（github-upload-policy 第 11/13 条），本会话是用户侧理解该禁令的过程记录。

## 六、Kimi 代表交互与纠错轨迹

### K-01：三任务 OSD 乱码经历四层根因修正（2026-11-02/03）

**任务提示词（据工程记录概括）**

完成 NanoDet COCO、YOLOv8n 七手势和 YOLO11n-pose 三任务的 PL OSD 显示，修复 COCO 标签、分数和 pose 文字乱码，并通过板上 HDMI 目检。

**模型回答与多轮纠错**

第一轮修复奇数字形行位段错误；随后发现仅修改被引用 `.v` 或 `$readmemh` 数据并不会自动更新 Vivado module reference 的 OOC DCP，顶层重建可能仍用旧网表。继续排查又发现字体表从 ASCII `0x20` 起排槽而 RTL 按原始 ASCII 直索引；最后定位 pose 标签 2 倍缩放后字符格应为 16 像素，原 `>>3` 应按 `>>4`。

**测试平台的自我纠错**

早期测试平台与 DUT 使用同一错位字体表或回读 DUT 内部选择寄存器生成期望，形成"同源自洽假证"。后续增加硬编码 `GLYPH_IDENTITY` 字模门，几何期望改由原始 `h_cnt／v_cnt` 与规格公式独立推导，并加入保留旧错误的负向对照。v3 正向像素检查通过，负向旧 RTL 在首个错误像素处失败，证明测试门确实能抓住缺陷。

**最终结果与证据**

用户 HDMI 目检确认 COCO 小写标签与两位分数、pose 的 `P`＋数字、手势出框均正常。证据：`7_logs/2026-11-03/03_validation_summary.md`、`13_final/MULTITASK_OSD_THREE_TASK/README.md`、`4_metrics/logs/2026-11-02_multitask_fix_run01/`。沉淀"仿真 PASS 不等于功能正确""期望值不得与 DUT 同源""module_ref 改动必须显式重置对应 OOC"三条规则。

### K-02：完整 PL 性能优化中的负结果停止与稳定版恢复（2026-10-30→11-01）

**任务提示词（据工程记录概括）**

在保持完整 PL 推理 21／21、RC＝0、摄像头并发无故障和真实数据闭环的前提下降低时延，不以单元仿真或理论带宽代替板上收益。

**模型回答与执行**

依次尝试 Scatter 描述符队列、X 输出气泡优化、权重驻留、RC-pair、两段多段链、75 MHz 和运行时 80 MHz 等候选。

**失败观察与自我纠错**

1. Scatter 单元双块测试通过，但接入 DB1 后板上返回 `err=0x07`，立即停止候选并恢复稳定版，不把单元 PASS 写成整网流水 PASS。
2. X 输出与权重驻留候选过功能门但整网 ticks 无正向收益，不晋升。
3. 多段 `nseg=3` 出现头部错误，专项证明两组 X 复用在三段排队下不成立，完整恢复原路径而非叠加局部补丁。
4. 仅改 BIT／XSA 的 75 MHz 方案没降墙钟，核对 BD 后确认 shim 用 PS7 FCLK0；转而通过 SLCR 运行时读回验证 80 MHz，才形成真实的 4.2671 s 结果，测试后恢复 50 MHz 稳态。

**最终证据**：`7_logs/2026-11-01/03_validation_summary.md`。体现"负结果也是有效协作记录"。

### K-03：PS＋PL 七手势链的错误恢复、语义和显示修正（2026-11-01→03）

**任务提示词（据工程记录概括）**

实现 YOLOv8n 的 PS backbone／neck＋PL 六段 heads＋PS decode 混合链，完成七手势实机识别和 NanoDet／YOLOv8n 双后端切换。

**失败观察与多轮纠错**

候选链早期出现门铃 `err=0x28／0x24`、部署后服务冲突、空背景 Stop 误检、左右方向语义相反、手势离开后显示框保持过久。纠错：PL heads 改进程内驻留运行时并加慢复位、FSM 重载和单帧重试；显示门与动作判定门分离，按空背景与真实手势分数分布定阈值；依据数据集演员视角与板上逐项实测增加 `LR_CLASS_REMAP={1:2,2:1}` 统一显示、判定和 top1；显示保持从 5 s 调整为 0.8 s 并区分"显示保持参数"与"真实推理延迟"；部署改为先停链再上传并校验固定 SHA。

**最终结果与证据**

七手势经用户逐项实机验证，双后端画面能区分 `ND` 与 `V8PL`；性能按中位约 2.50 s／帧表述，不宣称实时达标。证据：`13_final/PSPL_YOLOV8N_RESIDENT/README.md`、`4_metrics/logs/2026-11-03_pspl_v8n_gesture7_boardprep_run01/`。

### K-04：技术报告生成中的内容边界和格式纠错（2026-10-27→11-01）

**任务提示词（原始，2026-10-27 会话）**

> "E:\competition\13_final\report\官方报告以及视频模版 首先按照技术文档要求，先编写技术报告"

**模型回答与纠错**

MinerU 包装器起初未识别 Office 输出目录，后续仅补输出路径识别，没有更换解析引擎。DOCX 新增段落 ID、表格底纹和打包关系问题经校验修复。内容审核主动删除或禁止"完美复现""PL 三网已经完成""双网已验证"等超出证据的表述，历史性能数字保留版本限定。最终 V3 通过 DOCX 结构校验、原生目录更新和 MinerU 内容复核；视觉渲染工具不可用被单独披露，没有以结构校验冒充视觉检查。

### K-05：策略外脑——关键决策点的独立只读梳理（2026-10-26→11-03）

除执行席位外，用户在决策点用 Kimi 做独立"只读外审"，其提示词本身就是协作方法的一部分（原始记录逐字）：

**2026-10-29 整图硬件推理问题梳理（催生 3 天冲刺最终 SPEC）：**

> "目前为什么迟迟不能够上板，为什么迟迟无法做到整图的完整硬件推理，到底问题在哪里，目前的最新spec是否合理，仅做只读，参考即可（我认为这是导致claude反复错误执行的源头，所以你仅做参考）。然后仅对工程现状和最终目标为根本，先做问题分析梳理，然后重新做一份最终的spec，做完给我审核（优先提交问题分析梳理，在此基础上完成对应的spec）。注意：目前整个工程被claude做的很乱，而且各项要求也不一致（但是我的最终目标是清楚的：单网的完整pl推理-多网络的切换），工作流程也在被claude反复修改（他没有按照原来的成功流程来做，反复地在错误的的流程下阻塞任务整体进度），所以你这些点都应该注意到"

**2026-11-01 三网络三任务的快速部署洞察：**

> "基于工程现状，目前其实三个网络完全是可以实现三种不同的任务啊，是否可以快速部署"

**2026-11-03 评分预估与收官总结：**

> "按照目前的工程现状，参考AMD高级组的评分标准，预计得分是多少"
> "目前我已经做完了1.三网络纯ps推理：nanodet（coco）yolov8n（七种手势识别）yolo11n（人体姿态检测）的上板验证（在线拨码切换），并且解决了所有的乱码问题……2.nanodet的ps推理（七种手势）yov8n的ps+pl推理（七种手势）实现上板后的拨码在线切换……请对目前所有完成的工程做总结"

**纠错要点**

10-29 会话直接指出当时执行席"没按原成功流程、反复修改工作流程阻塞进度"，随后产出的问题梳理与重写 SPEC 被用户审核后立为唯一执行正典（`1_docs/final_spec/SPEC_FINAL_3DAY_PL_v1.md`，10-29 裁定）——外脑会话的批评被证实并转化为新的执行纪律：**复用已验证流程优先，禁止自写替代**。11-01 会话的"三网络即三任务"洞察则在两天内落地为三任务 OSD 作品形态（K-01）。

## 七、跨平台自我纠错机制归纳

| 纠错类型 | 典型失败 | 纠正方式 | 形成的可复用规则 |
|---|---|---|---|
| 方向纠错 | 选题两次转向（紫光同创→§3.2→§3.3） | 保留旧口径原文仅作历史证据（README 切换声明） | 方向切换留痕，不销毁历史 |
| 工具接口纠错 | 反复调用不存在的批量编辑工具（X-05） | 检查真实工具注册表，限制补丁形状与重试次数 | 先确认工具合同；失败后读现状，不重复同形调用 |
| 流程与环境纠错 | Vivado 会话在而 XSim 子进程无法启动（C-04） | 修子进程 PATH，改结构化三段式 XSim | 连接成功、流程成功、功能成功分别验收 |
| 解析与测试自证纠错 | 空表解析出伪记录（C-01）；TB 与 DUT 同源生成期望（K-01） | 回到原始报告；硬编码字模门、独立几何期望与负控 | 自动脚本、测试平台与 DUT 保持证据独立性 |
| 验收范围纠错 | 代表 Conv 写成整网收官（C-03）；单元 PASS 写成整网 PASS（K-02） | 独立审计、降级结论、列未覆盖项 | 结果标签绑定输入范围、配置与制品哈希 |
| 数据语义纠错 | 左右手势标签与观察者视角相反（K-03） | 追数据集 GT 约定并逐类板测 | 数据语义以原始数据集和实机终审为准 |
| 部署运行纠错 | 端口被孤儿服务占用、运行中文件被覆盖（K-03） | 停链、核对端口归属、完整部署、SHA 校验 | 部署是状态迁移，不是文件复制 |
| 性能路线纠错 | 单元收益无法转化为整网收益（K-02） | 负结果停止、稳定版恢复、真实墙钟复核 | 不以理论收益或局部仿真替代整网实测 |
| 协作规则纠错 | 复杂 PR 流拖慢协作（X-02）；分支清理误删队友分支（Z-04） | 用户裁定简化＋事故后规则升级 | 双人分支互批；事故先取证再恢复 |
| 执行纪律纠错 | 执行席偏离已验证流程、反复自造流程（K-05） | 外脑只读梳理＋重立唯一执行 SPEC | 复用已验证流程优先，禁自写替代 |
| 平台迁移纠错 | 通道 403/502/SSE 超时等 176 条故障（X-07） | 故障留痕，席位迁移至 Claude Code | 协作中断也是记录；不与不稳定通道硬耗 |

## 八、协作经验到 Skill 的映射

| Skill | 适用范围 | 使用方法概述 | 失效或停止条件 | 主要来源案例 |
|---|---|---|---|---|
| `zynq-pynq-overlay-workflow` | 既有 Linux SD 镜像上的 Zynq／PYNQ Overlay 替换、PS－PL 集成和恢复 | 兼容性审计→停止所有者→DMA 停止门→下载与首帧→分层恢复 | 不用于任意 SD 镜像重建或裸机流程；DMA 所有权不清时停止 | X-04／X-06 及多次板端恢复 |
| `vivado-ai-workflow` | Vivado 工程、仿真、IP、构建、时序和文档检索 | 通过 ROSS／Vivado MCP 管理会话并执行结构化命令 | MCP 不可用或工具未覆盖时不得假装执行 | C-01、C-04 |
| `claude-ross-delegation` | 有界 Claude 委派、ROSS 调用和独立复核 | 明确输入、权限、禁止路径、终止标志和证据目录 | 未授权、会话冲突、工具缺失或超范围写入时停止 | C-01、C-04、C-05 |
| `github-upload-policy` | 个人分支日常开发、里程碑合入 main、凭据与二进制边界 | 会话预取证→显式列名暂存→声明式提交→ssh.github.com:443 推送 | 永不强推、永不 `git add .`、密钥永不离机 | X-01、X-02、Z-04、Z-05 |
| `eng-pitfall-ledger` | 构建、仿真、板测和工具链异常 | 先检索同型条目，解决后回填症状、根因、修复和检测门 | 3–5 轮无法收敛时停止升级 | 全部纠错案例 |
| `mineru-doc-reader` | PDF、扫描图片和 Office 文档的内容级解析 | SHA 建档→pipeline 解析→检查 marker、Markdown、内容 JSON 与质量 | 不用临时文本提取冒充 MinerU；失败时披露边界 | X-03、K-04 |
| `daily-engineering-log` | 工程计划、执行、验证和交接 | 当日四件套记录，原始证据进独立 run 目录 | 不用摘要替代原始证据，不写入退役日志根 | 全项目协作记录 |

正式提交时，`zynq-pynq-overlay-workflow` 作为通用 PYNQ Skill 主件；板卡地址、工程路径与模型名称保留在独立 profile 或示例中，避免通用流程与本队题目强绑定。

## 九、项目协作过程的阶段总结

1. **规则与方向形成（09-01→09-08）**：赛道第一次转向、GitHub 仓库与协同准则建立并简化、OV5640 配置审计立"数据手册为正典"的口径；编辑工具循环故障沉淀 AGENTS.md 纪律。
2. **板级流程规范（09-09→09-14）**：PYNQ 部署计划定位、SD 16 GB 损坏应急确立"在线重加载＋大资产原地保护"，色差分析挂接寄存器审计。
3. **危机与规则升级（09-19→09-21）**：分支失控事故取证恢复，同日 github-upload-policy v2 出台。
4. **独立审核与席位迁移（09-30→10-11）**：Claude 经 ROSS 完成 B3-S3／M9 审计与 RTL lint，XSim 三段式跑通；Codex 通道故障累积，主力席位迁移。
5. **方向二次定位（10-12→10-18）**：Kimi 报名材料与赛题解析；10-14 切换 §3.3"一芯多模"。
6. **外脑重整与冲刺排期（10-26→10-29）**：Kimi 只读梳理指出执行席流程漂移，重立唯一执行 SPEC；双席互审常态化。
7. **工程冲刺（10-29→11-03）**：完整 PL 推理 4.2671 s 实测、三任务 OSD 修复、PS+PL 混合推理上板，负结果候选全部留痕。
8. **交付与沉淀（11-03）**：报告 v4、§3.3.5.4 七目录提交包、四平台原始记录抽取与本归纳 V2.0。

## 十、证据索引与提交边界

### 10.1 本机原始记录存储（只读，永不移动）

| 平台 | 原始路径 | 说明 |
|---|---|---|
| Claude Code | `C:\Users\Administrator\.claude\projects\E--competition\*.jsonl` | 22 会话全量 |
| ChatGPT／Codex | `C:\Users\Administrator\.codex\sessions\YYYY\MM\DD\rollout-*.jsonl(.zst)` | 340 rollout，历史为 zstd 压缩 |
| Kimi | `%APPDATA%\kimi-desktop\…\transcripts\days\` 与会话 SQLite 库 | 44 转录日 |
| Zcode | `C:\Users\Administrator\.zcode\cli\db\db.sqlite`（含 WAL 三件套） | 打开前先复制库文件 |

### 10.2 抽取与归纳证据目录

- 四平台抽取运行：`4_metrics/logs/2026-11-03_ai_collab_v2_run01/`（含全部脚本、索引 CSV、关键日全文 JSONL、176 条错误轨迹、案例摘录）
- V1.0 归纳运行：`4_metrics/logs/2026-11-03_ai_collaboration_records_run01/`（赛题要求截图 MinerU 解析 + V1 文档构建）
- 各案例的工程证据（AUDIT／REPORT／日志）路径已在案例内标注。

### 10.3 脱敏与安全声明

抽取脚本将 `sk-…`／`pk-…`／`eyJ…` 形态字符串替换为 `[REDACTED-KEY]`；`auth.json`、Zcode `config.json` 的 apiKey 与证书、Kimi token-store、Claude 凭据等敏感文件**从未复制、从未进入任何提交包**；提交包内板卡口令一律走 `$BOARD_PW` 环境变量通道，严禁落盘。

### 10.4 诚实边界

1. 网页版 ChatGPT 在本机无会话存储，本文件不包含也不冒充其记录；"ChatGPT／Codex"按本机 Codex CLI／桌面端归类。
2. `~/.codex/sessions` 中 2026-06～08 的会话属于另一论文项目工作区（D:\VitA 等），**不计入**本工程协作历史。
3. Kimi 桌面端会话索引提供每个会话的用户首问逐字；完整多轮正文以本机 days 转录与工程日志为准。部分早期 Codex 会话正文为压缩格式，摘录以关键日全文抽取为准。
4. Claude 会话中部分配置模型名与客户端名不一致，按客户端归类（V1 已注，V2 沿用）。
5. V1.0（2026-11-03 上午版）保留为历史快照；其"Zcode 未检索到、Codex 部分缺失"的结论已被本版推翻。
6. 如需按各平台账号后台证明"全部会话"，须另行导出并与本文件案例编号关联；本文件覆盖的是本机可核验记录。

## 十一、总结

本项目的大模型协作不是一次性提示词生成，而是四平台、两阶段席位演进、由真实证据驱动的工程迭代：Codex 完成工程奠基与规则初创（09 月），Zcode 提供轻量快答与两次危机排查，Claude Code 承担独立审计并接棒主工程席位（10-11 起），Kimi 兼任工程执行、策略外脑与报告表达。选题方向两次转向、176 条通道故障、负结果候选、审计降级与流程重整全部留痕——失败与纠错轨迹证明大模型协作真实发生，Skill 与证据目录则证明这些经验可被其他队伍复用。
