pipidandan-superman/FPGA_2026_competition/report/technical_report_v4.docx

一芯多模

——面向 Zynq-7020 资源受限平台的

多模型在线换载编译与视觉推理系统

技 术 报 告

2026 年 11 月

# 摘 要

本作品在 EES-331 的 Zynq-7020 上实现摄像头采集、HDMI 叠加显示和多种视觉推理路径。形态一的三网络切换由 PS ncnn 执行；形态二在 PL 执行网络计算，PS 仍承担输入归一化、量化及结果解码/NMS；形态三由 PS 执行主干与颈部、PL 执行检测头六段。提交包形态三位流为 72b358ff…2f7a58，最终日志为 488 帧、中位 2496.7375 ms、均值 2554.553 ms，记录 23 次恢复并检出七类手势；这不等于严格七项自动验收流程全部走完。形态二打包日志有 83 帧，中位 11023.045 ms，仅覆盖六类，缺 Down。本报告把历史性能试验、当前包内证据与待完成事项分开；多网络 PL 换载尚在研。开发与复现指定 Vivado 2025.2，模型、源代码和构建/板测结果分别保留可核验身份。

关键词：Zynq-7020；多模型切换；神经网络加速器；PS+PL 协同；手势识别；智能体工作流

# 第一部分 作品概述

## 1.1 功能与特性

系统包含五项已实现功能：摄像头采集与 HDMI 显示；PL letterbox 预处理候选与软件参考对照；PS ncnn 多网络/多任务切换；PL 整网计算和 PS+PL 检测头卸载两条硬件推理路径；训练、量化、任务程序及证据管理工具。七类检出结论对应最终混合日志，纯 PL 当前包内日志只覆盖六类。机械臂历史闭环与现役视觉链的集成状态分别列出。不同形态的预处理位置、位流及软件配置须按其部署目录核对。

## 1.2 应用领域

适用方向包括需要轮换识别任务的边缘视觉展示、低成本软硬件协同教学，以及同一器件上不同计算划分的实验研究。PS 模型切换已经展示，通用 PL 多网络换载尚待验证；不能据此宣称检测、手势、姿态三网络已经由同一 PL 加速器执行。应用领域属于设计目标，尚无行业现场部署结论。

## 1.3 主要技术特点

主要技术特点为：明确采集、预处理、推理和后处理的分工；以任务程序和量化数据驱动自研矩阵乘阵列及图算子；在同一器件上比较 PS、PS+PL 与 PL 网络计算三条路径；以固定输入比对、动态采集和独立负控区分验收层级。多网络 PL 通用性是扩展目标，目前板测结论限定于实际程序和位流。

## 1.4 主要性能指标

指标 | 数值 | 条件
三网络单配置热切换 | 3 网在线切换（板证 6 连） | 拨码触发
帧时（三任务） | 0.78–3.9 秒/帧 | 处理器 ncnn 单线程
纯 FPGA 整网 | 计算 4.27 秒（80MHz）/整机约 11 秒 | 83 帧连续记录覆盖六类；固定输入另计
混合后端 | 中位数 2.497 秒/帧 | 488 帧；七类检出，自动序列边界见正文
端到端加速 | 62.27 倍 | 第一代历史 7.77 秒版本 vs 483.81 秒整数参考
时序 | 包内各版本报告分别核对 | 不替代本次重新构建

## 1.5 主要创新点

创新性主要体现在自研计算与任务调度的组合、检测头卸载的软硬件切分实验、板上错误回流到模型和运行时修正，以及包含失败案例的复现工作流。PS 三模型切换与 PL 多模型换载是不同能力，后者不列为已完成创新成果。混合形态的实际时延仍高于所列 PS ncnn 参考值，当前价值在于验证计算分工与恢复机制。

## 1.6 设计流程

工程历时两个月（2026-09-01 至 11-03），按十二阶段推进：视频链路点亮→板卡工程化→量化门体系建立→计算核心时序收敛→处理器/ FPGA 切分→赛道转型→第一代整网方案（弃用）→第二代加速器合同→三线并进→整网收官冻结→多模演示与混合驻留→报告固化。全程执行"验证门预申报判据、错误即停、无板证不算通过"纪律。

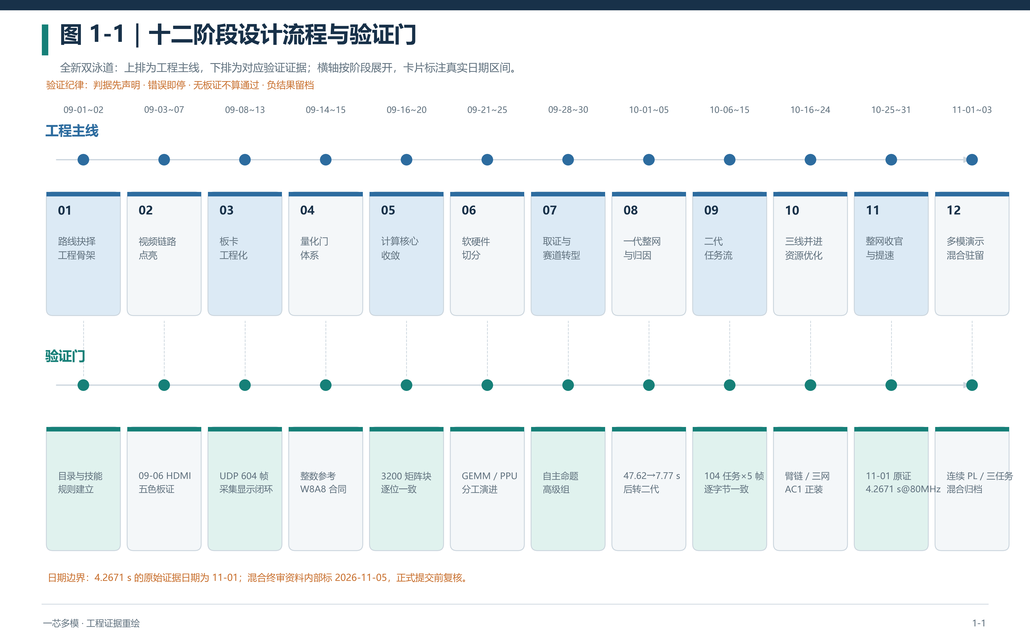
[picture p19: figure]

图 1-1 十二阶段双泳道流程

# 第二部分 系统组成及功能说明

## 2.1 整体介绍

系统的设计哲学是"一个底座、一个加速器、四种形态"：

● 视频通路：各形态保留摄像头采集和 HDMI 叠加显示。320×320 输入的缩放、归一化、量化位置随形态变化，不能把某一形态的 PL 预处理推广为所有形态的完整输入变换。

● 自研加速器：矩阵乘阵列、图算子和任务程序构成硬件计算路径。当前实证绑定 YOLOv8n 相关程序；YOLO11n、NanoDet 与 COCO 三任务演示不能直接证明对应网络的 PL 整网执行。

● 四种推理形态（同一板卡上演进，详见 3.2 与 2.5）：

形态 | 处理器职责 | FPGA 职责 | 帧时 | LUT 占用
一·纯处理器推理 | 全部网络推理（ncnn） | 采集/预处理/显示/拨码（分工细目见 3.2） | 0.78–3.9 秒 | 21%–28%
二·纯 FPGA 整网 | 归一化/量化、装载控制、解码/NMS、以太网桥 | 采集+预处理+整网推理+显示 | 约 11 秒 | 81.77%
三·PS+PL 驻留 | 主干/颈部（ncnn）与结果解码 | 检测头六段计算+采集/预处理/显示 | 约 2.50 秒 | 59.24%
四·多网换载（在研） | 同形态三 | 同形态三（换载 YOLOv8n↔YOLO11n） | — | 目标复用形态三

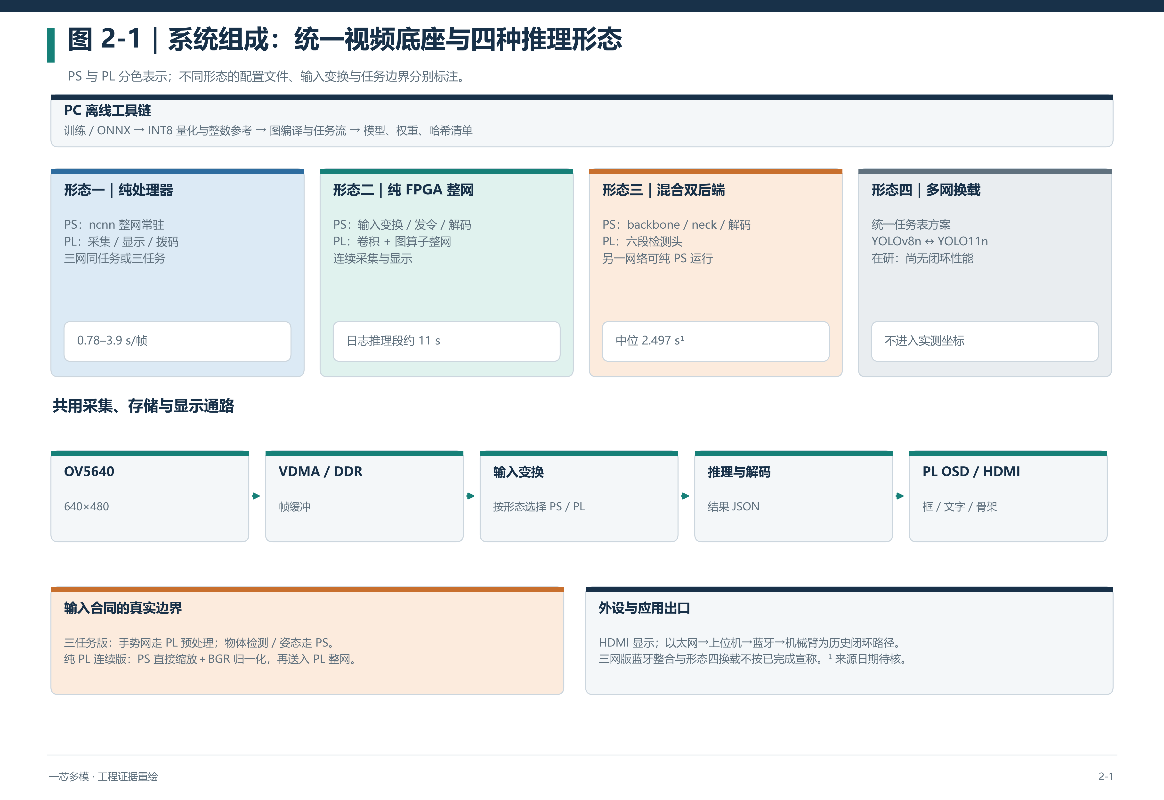
[picture p20: figure]

图 2-1 系统组成与四形态（历史设计全景；本包形态三只交付驻留路径，双后端及形态四不计入验收）

## 2.2 硬件系统介绍

### 2.2.1 硬件整体与开发平台

开发平台为 EES-331（xc7z020clg484-1）、DDR3、OV5640 摄像头、ADV7511 HDMI 发送和外部机械臂。工具版本为 Vivado 2025.2，板端 PYNQ 3.0.1。AXI-Lite 用于控制，AXI 数据端口连接 DDR。厂商基础 IP（PS7、VDMA、时钟、互连等）与自研 RTL 分别保留来源。其他同器件板卡仍须适配管脚、DDR、参考时钟、MIO 和启动镜像，不能直接下载本板位流。

### 2.2.2 机械设计

自研扩展基座将摄像头、蓝牙模块、供电统一连接到开发板（实拍见 3.2）；机械臂为成品执行端，通过蓝牙接收指令。

### 2.2.3 自研数字电路（逐模块）

（1）视频底座：OV5640 配置、帧捕获、视频 DMA、时序控制器、HDMI 发送；屏幕叠加单元（检测框绘制+文字条带，字符从只读存储器字库取形）。

（2）保长宽比缩放预处理：640×480→320×320 灰边填充缩放，输出与 OpenCV 参考实现逐位一致（零误差），约 21 毫秒/帧。

（3）矩阵乘阵列：8×8 个双路物理 PE，共 64 PE，每 PE 两路 INT8 乘积对应 8×16 逻辑输出；共享量化与激活处理。计算核心历史验证与整网/视频集成的资源、时钟和验收对象不同，不能混用。

（4）图算子单元：加法、拼接、最大池化、上采样、检测头等非卷积算子整体入硬件，摆脱处理器逐算子参与。

（5）任务调度与装载：程序描述地址、形状和操作，并通过控制寄存器驱动加载与计算。104 项任务等统计属于对应历史程序；检测头驻留程序和纯 PL 连续程序须按各自 prog 目录解释。

（6）五项资源优化后的加速器正装：LUT −25.0%、触发器 −50.8%、触发器控制集 −46.2%、DSP 持平、时序裕量 +0.111 纳秒，优化前后功能逐位一致。

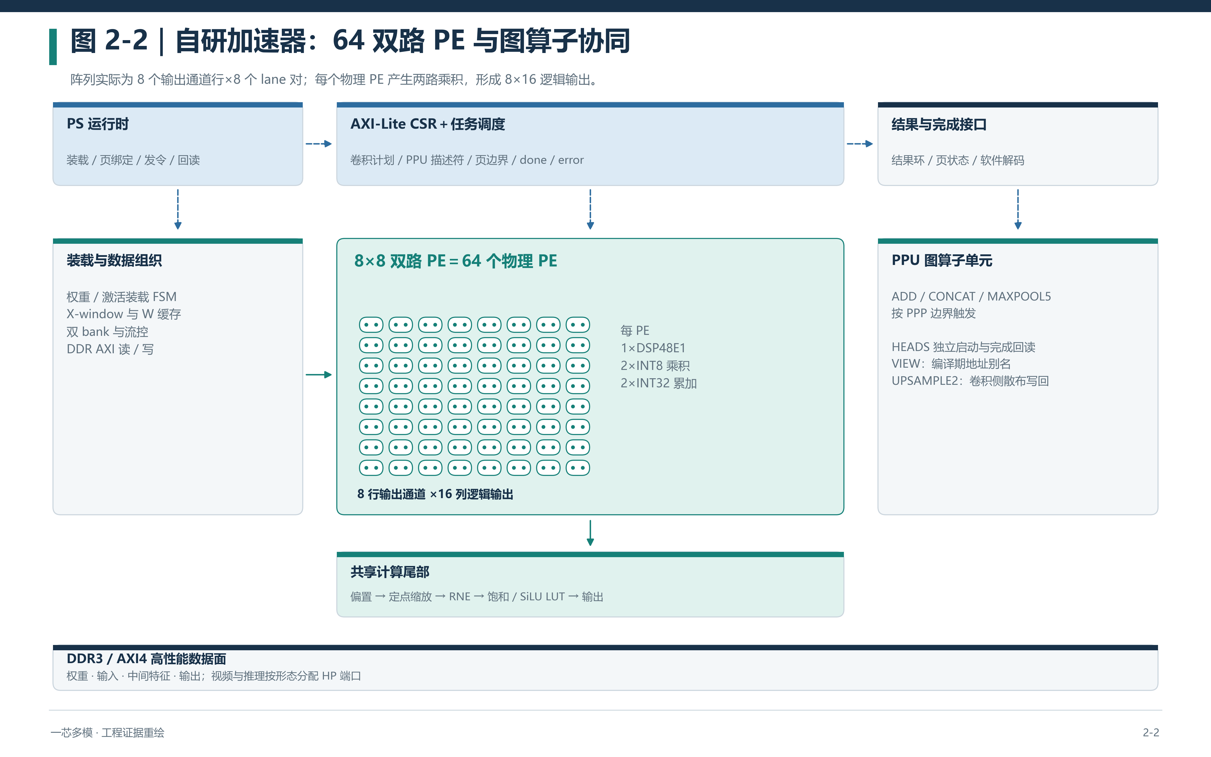
[picture p21: figure]

图 2-2 加速器微架构

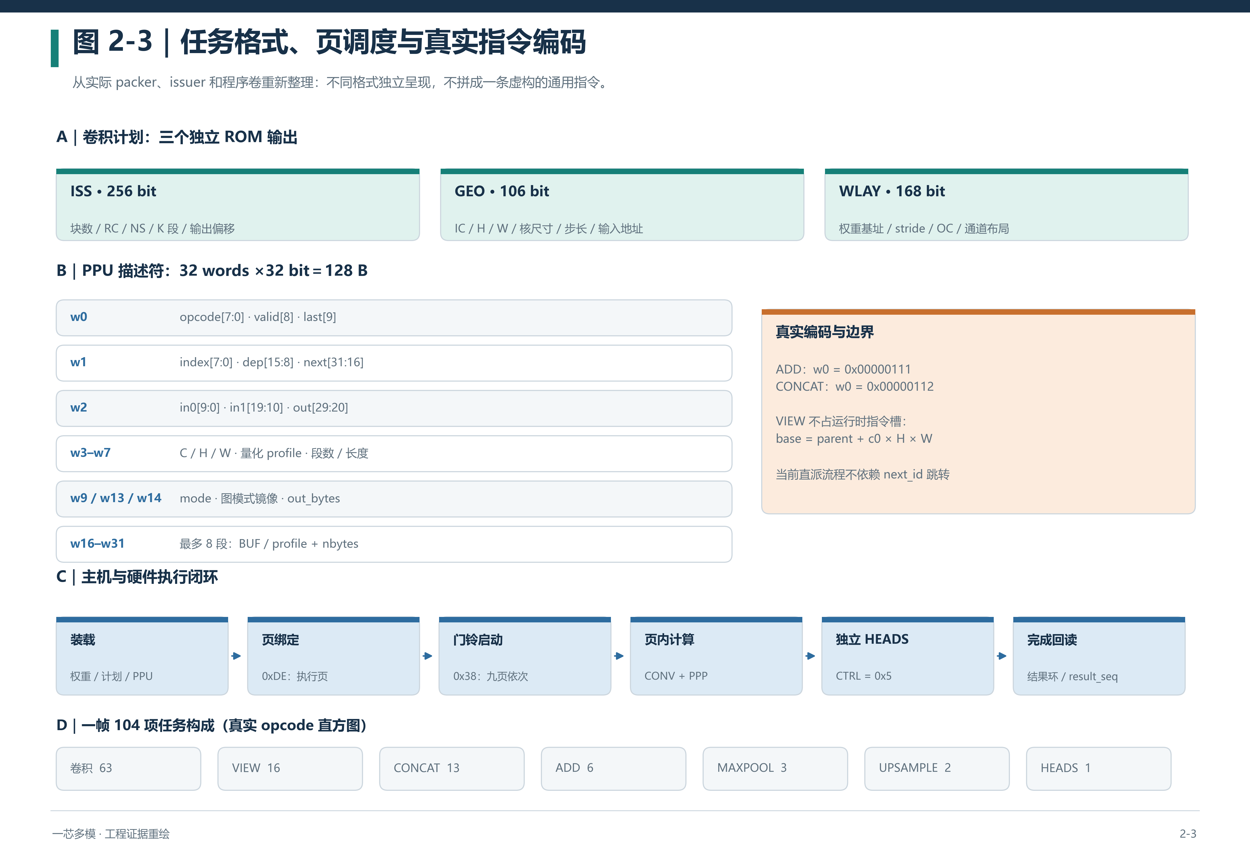
[picture p22: figure]

图 2-3 任务格式与页调度

### 2.2.4 各形态时序与资源总表（xc7z020，%为占总量比，形态一B资源取自布局后报告，其余按对应报告阶段）

形态 | 冻结日期 | 时序裕量（纳秒） | LUT | 触发器 | BRAM | DSP
一 A·三网同任务 | 10-21 | +8.164 | ~21%（10931） | — | 17.9% | 5.9%（13）
一 B·三网三任务 | 11-03 | +0.878（最差路径） | 28.08%（14938） | 22.02% | 48.21% | 7.73%（17）
二·纯 FPGA 整网 | 11-01 | +0.099 | 81.77%（43504） | 36.37% | 90.71% | 47.73%（105）
三·PS+PL 驻留 | 包内 72b358ff 版 | +0.255 | 59.24%（31515） | 25.91% | 68.93% | 41.36%（91）
（参考）加速器正装 | 10-24 | +0.111 | 52.73%（28050） | 24.64% | 49.64% | 39.55%
四·多网换载 | 在研 | 尚无配置文件 | 目标复用形态三底座

DSP 梯度 13→17→91→105 即"同一器件按形态重分配计算资源"的直接证据。

## 2.3 软件系统介绍

### 2.3.1 软件整体：三层

PC 离线层：训练与定向重训→导出 ONNX→量化校准（8 位）→图编译器（模型→硬件任务流）→整数参考实现（与硬件同一套量化规则的软件网络，作为加速比分母与对拍基准）。板端层：PYNQ Linux 上常驻三模型推理服务器（ncnn）、硬件驱动（三代演进：逐算子下发→批处理→常驻内存运行时）、结果解码与显示叠加、任务切换服务。证据层：模型/配置文件/驱动全哈希登记，部署脚本逐文件校验。

### 2.3.2 训练任务总账（两个月 7 项）

# | 模型 | 任务 | 结果

1 | YOLOv8n v1 | 七手势 | mAP50=0.730（队友完成并入）
2 | YOLOv8n v2 | 七手势 | 测试集 0.972、留出集 0.983（正典）
3 | YOLOv8n v4（学习率修复重训） | 七手势 | 难点类置信度提至 0.839
4 | YOLO11n v4 | 17 个关键点姿态 | 板上"person"检出 0.89–0.93
5 | NanoDet v6→v65 | 七手势（主力轻量） | 最难类误报水平 0.446→0.058；合并数据集（左右标签经数据集约定核对后统一）
6 | YOLOv8n COCO 80 类 | 物体检测 | 加速器验证线用；量化校准在此完成
7 | NanoDet COCO 预训练 | 80 类（三任务演示） | 未针对本摄像头重训练（跨域局限已注明）

训练资产完整留档（源码/日志/检查点/曲线）；数据侧累计手势标注 1765 张+公开手势集 13.4GB+合并版训练集。

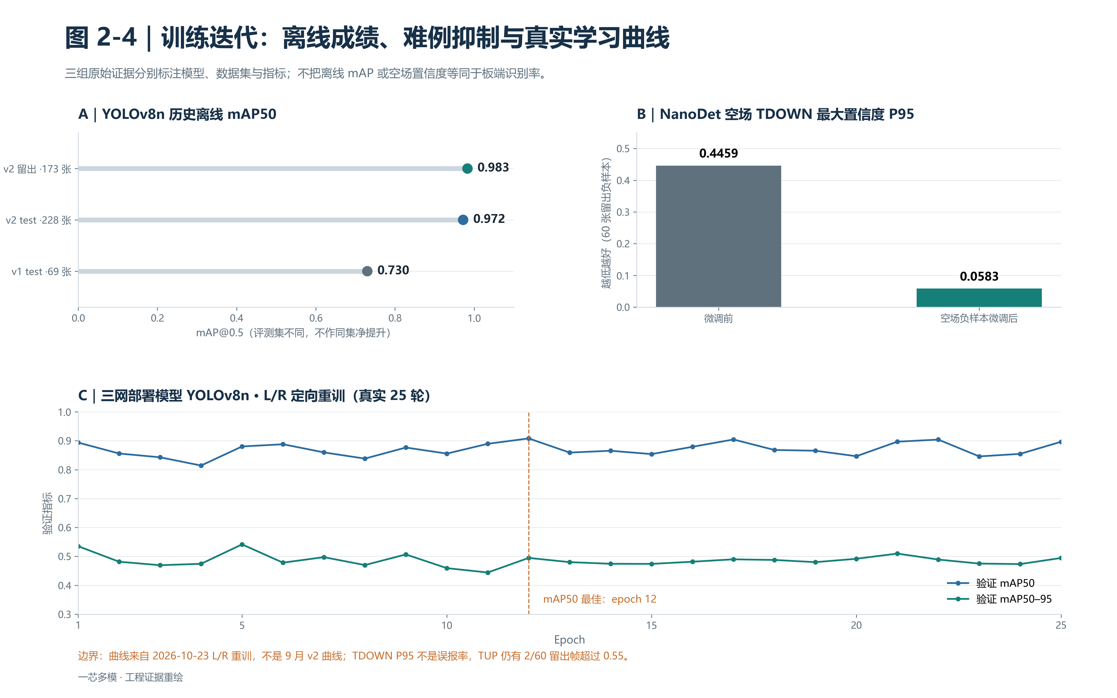
[picture p23: figure]

图 2-4 训练迭代与真实曲线

### 2.3.3 处理器推理优化（ncnn，按网络分述）

三级台阶（同板 A9 实测）：Python 数值库整网 45.34 秒（自检用）→OpenCV dnn 2.47 秒→ncnn 0.814–0.970 秒（提速 约 2.13–3.17 倍（2.47 秒 / 所列帧时））→常驻服务 0.78 秒。通用优化：ARM NEON 指令卷积核、三模型注册表常驻服务器（切换零重载）、与 FPGA 预处理衔接（省软件缩放）、转换链全哈希。分网络：NanoDet-v65 0.78 秒（另建 INT8 量化工具链，用作混合链逐帧基线）；YOLOv8n 1.05 秒（三尺度检测头约占计算量四成——卸载 FPGA 的设计依据）；YOLO11n 1.16 秒（验证一套栈覆盖检测/姿态）。以上为单线程实测口径（与采集/显示/服务进程稳定共存）。

### 2.3.4 部署运行时

四步标准部署：停旧链（显式停视频 DMA/杀旧服务）→上传→逐文件哈希校验→按正典顺序启动（服务器就绪门→主链→独立验证）。一次"运行中直接覆盖文件"造成三连崩后立为铁律：先停链、后上传、校验后才启动；端口归属检查纳入部署门。

## 2.4 软硬件划分依据与接口设计

划分依据是计算结构、DDR 传输、器件资源与可重复测量。混合形态让 PS 执行主干和颈部、PL 执行检测头六段；最终 488 帧的总帧时中位为 2.497 秒。PS 阶段、PL 驱动和硬件执行各有计时范围，不能将不同统计口径的典型值相加当作精确分解。纯 PL 连续路径中位约 11.023 秒，仍慢于所列 PS ncnn 参考值。PS 多任务演示、PL 整网计算和 PS+PL 卸载是三条已有实验路径，多网络 PL 换载为在研方向。

接口契约：AXI-Lite 控制面（任务启动/状态/结果环寄存器）；AXI4 数据面（四个高性能端口，视频与推理分端口带宽重划）；任务描述字合同（字段布局在加速器三代演进与三种网络间保持兼容，未破坏）；统一 43 槽任务表（在研形态四的设计，把三个网络的硬件任务并入一张表在线换载）。

## 2.5 优化过程与前后对比

### 2.5.0 怎么读本节数字：三条基线

基线 | 数值 | 是什么
基线一·软件公平基线 | 483.81 秒/帧 | 同板处理器纯软件实现与硬件完全相同的 8 位量化规则整网（故意不优化，作公平分母；320 组输出全对）
基线二·工业框架参照 | 0.78/1.05/1.16 秒 | 同板 ncnn 三网络（单线程）
基线三·各线自身起点 | 见各小节 | 线内前后比

每个数字=数值＋测量条件＋验证方式；三种口径（纯计算/整机/人感时延）永不混排。

### 2.5.1 纯处理器软件推理的优化

45.34 秒（Python 自检）→483.81 秒（量化基线，另一切用途）→2.47 秒（OpenCV dnn）→0.814–0.970 秒（ncnn，约 2.13–3.17 倍（2.47 秒 / 所列帧时））→0.78/1.05/1.16 秒（三网络常驻服务现役）。要点：软件加速来自"ARM 优化框架+模型常驻"，与硬件加速是独立维度；FPGA 预处理 21 毫秒/帧不计入。

### 2.5.2 纯 FPGA 整网推理的优化（重点）

定位声明：研究固定数据通路与任务程序的协同，保留实际网络结构、量化和输入条件。换网络仍需验证算子覆盖、编译结果、资源与板级执行；形态四尚在研，不作已完成承诺。

外部方案比较暂不列入本次交付的性能结论：原稿引文与网络/数据集/输入条件未在本包形成可独立核验的对照。性能分析以下述同一项目的真实记录为准。

本报告不进行跨网络、跨输入尺寸或跨设备的速度排名。历史研究背景不能替代本包位流和软件的复现证据。

计算核心先站住：首次综合时序 −31.140 纳秒不可实现、DSP 需求 238 超过总量 220；按 Xilinx DSP 使用规范改造后 DSP 降到 68、时序裕量 +1.392 纳秒@100 兆赫兹；板上 3200 块随机矩阵全部与 PC 逐位一致（3.9 秒，零错误零停顿）。

第一代整网方案与中途放弃：处理器逐算子下发的架构 10 月 3 日整网首测 47.62 秒/帧；归因：66.7% 处理器整理数据+27.4% 打包，硬件计算仅占 1.4%（0.65 秒）。次日仅优化处理器侧数据整理（硬件不动）降到 7.77 秒（相对基线一=62.27 倍）——证明硬件计算真实，但每帧仍需处理器深度参与、距交互水平仍远，中途放弃该路线，转向第二代。

第二代方案（新计划）四件事：①硬件任务调度（任务描述字+启动寄存器+结果环，一帧 104 项任务处理器只发令不搬数）；②配套编译器（模型→任务流；104 任务×5 帧逐字节一致，连续 89 分 30 秒零返工）；③层内流水——实测单层 92.4% 时间在数据装载、仅 7.6% 在计算，装载与计算重叠后代表层 53.05→49.43 毫秒（−6.82%，收益受装载主导限制，此测量直接指明后续方向）；④层间流水——相邻层任务链接交叠（最长链 16384 项全窗口与仿真逐字节一致），相关图算子入硬件，最终解码/NMS仍在PS。

资源与时序天花板：提频 100 兆赫兹四轮布局失败（逻辑占用 93.35%）→锁 50 兆赫兹（裕量 +3.397 纳秒）；布局锁定实验两轮无收益（负结果如实记录）；路由危机后五项资源优化（LUT −25.0%/触发器 −50.8%/控制集 −46.2%/时序 +0.111 纳秒，功能逐位一致）。

量化校准：夜间弱光校准集致量化后精度降 0.032 超门（判定不合格、如实留档）→换 300 张 COCO 重校准降 0.008 门内通过。

上板实机验证（七手势）——纯计算口径（每轮 21 组输入逐字节一致才计入）：

版本 | 日期 | 计算时间 | 手段（通俗）
基线 | 10-28 | 19.15 秒 | 整网跑通（同日整机约 25 秒）
二 | 10-29 | 14.204 秒 | 任务下发顺序重排，权重搬运 18.6MB→0.2MB
三 | 10-29 | 12.89 秒 | 双缓冲预取
四 | 10-30 | 10.22 秒 | 深度预取+批量任务单
五 | 10-30 | 6.59 秒 | 相邻任务成对调度
六 | 10-30 | 6.24 秒 | 两段并发（三段出错完整回退）
七 | 10-31 | 4.27 秒 | 运行时 50→80 兆赫兹（测毕恢复复测）

固定输入计算优化与连续摄像头帧时是不同口径。形态二连续日志共 83 帧，中位 11.023045 秒，返回码均为 0；六类记录中最高置信分别为 Left 0.665、Right 0.758、Stop 0.675、Thumbs Down 0.634、Thumbs up 0.634、Up 0.591。该日志缺 Down，不能写成七类全部验收通过；约 11 秒与固定输入 4.27 秒不可直接作同口径加速比。

### 2.5.3 折返：处理器+FPGA 混合推理

混合路径把主干与颈部放在 PS，把检测头六段放在 PL。最终 session_124133_final_lrfix 日志 488 帧，中位 2496.7375 ms、均值 2554.553 ms、恢复记录 23 次；七类均有检出，严格七项自动序列的未完成边界保留。早期 session_123205_display_gate 为 196 帧、中位 2492.965 ms、恢复 12 次，不能与最终会话合并。混合路径仍慢于所列 PS ncnn 参考值；各阶段时间与总帧时须采用同一测量定义。

硬件资源使用与时序（现役配置文件，布线后报告实测）：

项 | 数量 | 占片上总量
查找表 LUT | 31515 | 59.24%
触发器 | 27570 | 25.91%
存储块 BRAM | 96.5 / 140 | 68.93%
数字信号处理单元 DSP | 91 / 220 | 41.36%
时序裕量（建立/保持） | +0.255/+0.020 纳秒（72b358ff 版） | 全满足、零违例

形态三资源来自当前 72b358ff 位流对应报告，LUT 占用 59.24%。与形态二的资源差异可描述硬件组成，不能据此证明本包实现了另一版本的双后端拨码切换。

### 2.5.4 后续优化方向（进行中）

①加大层间流水力度：连续卷积中间结果驻留片上存储（不再经内存往返）；②多矩阵乘核并行（五项资源优化腾出空间后以空间换时间）；③装载/显示开销拆账（约 4.8 秒差距分离）。

### 2.5.5 前后对比总表

线 | 起点 | 终态 | 收益
纯处理器 | 2.47 秒（OpenCV） | 0.78–1.16 秒（ncnn） | 约 2.13–3.17 倍（2.47 秒 / 所列帧时）
纯 FPGA·一代 | 47.62 秒 | 7.77 秒后弃用 | 62.27 倍（vs 基线一）
纯 FPGA·二代 | 计算 19.15 秒/整机约 25 秒 | 4.27 秒/约 11 秒 | 3.07/4.49 倍；整机约 2.3 倍
混合 | 3.47 秒 | 2.497 秒 | 约 −28.0%（以 3.47 秒为分母）
资源时序 | −31.140 纳秒/DSP 238/路由危机 | 全满足/DSP 68→91/LUT −25% 等 | 不可实现→各形态按对应报告核验

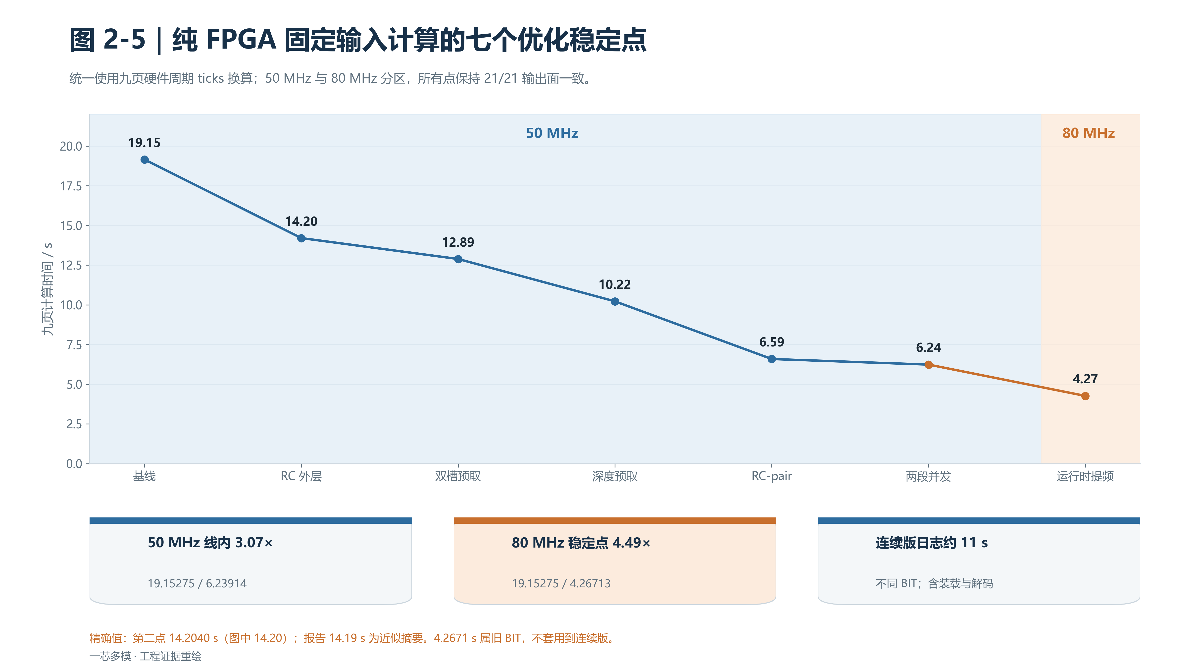
[picture p24: figure]

图 2-5 七轮计算优化

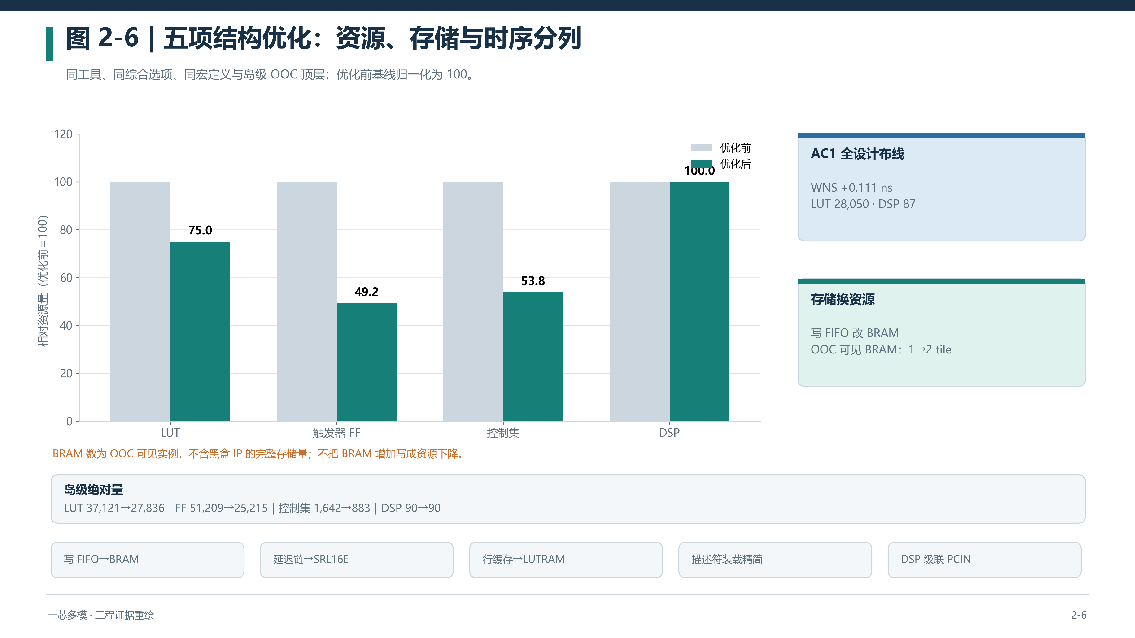
[picture p25: figure]

图 2-6 资源优化对比

负结果与红线（诚实清单）：三段并发出错完整回退；旧装载通道与计算重叠会挂起（永久停用）；仅改配置提频 75 兆赫兹墙钟不降（该板卡时钟设置值与实际频率为 2/3 关系，实测发现，一切以硬件周期计数实测为准）；布局锁定无收益；若干微调无实质收益即停。禁用对比：跨模型相除、把纯计算核 747 倍写成整机、理论空间当已实现、三口径混排。

# 第三部分 完成情况及性能参数

## 3.1 整体介绍

状态按证据划分：已有历史板测包括 PS 多网络/多任务展示、PL 计算及混合驻留路径；本包纯 PL 连续日志缺 Down 类覆盖，混合日志七类检出但自动序列验收有边界。蓝牙整合候选和多网络 PL 换载分别属于待板测与在研。本次修复的 Vivado 重建结果以独立构建门为准。

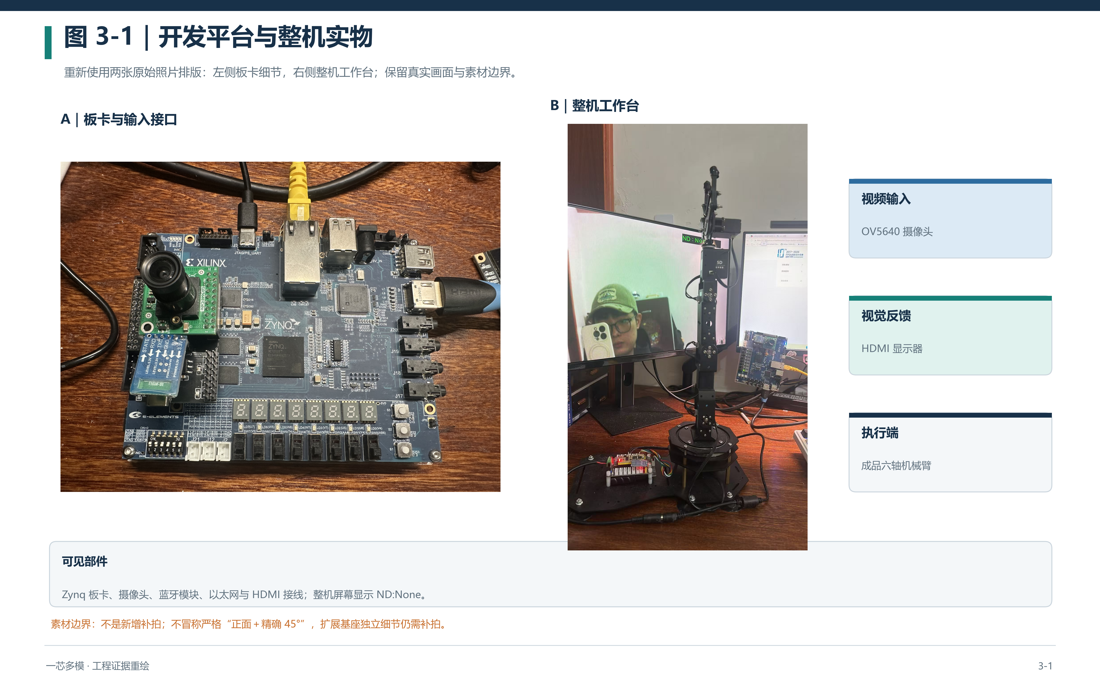
[picture p26: figure]

图 3-1 开发板与整机实物（已有实拍；指定第二角度与基座细节仍待补）

## 3.2 工程成果（按四形态）

形态一 A 的网络推理由 PS ncnn 执行，PL 提供采集、letterbox 和显示；形态一 B 展示物体检测、手势和姿态三任务。检测与姿态可采用 PS 侧输入处理。姿态画面中的 P92 表示 person 置信度 92%，不能解释为人数。字体/标签 OSD 的正向和故障注入日志单列在 sim/form1b_multitask_osd。

形态二的网络计算由 PL 执行；PS 承担输入归一化、量化、装载控制以及解码/NMS和显示协调。包内 83 帧中位 11.023045 秒，仅六类记录，Down 待补。历史机械臂链的验证与该连续推理会话不是同一项集成验收。

形态三交付 PS+PL 驻留七手势路径，BIT SHA-256 为 72b358ff75a8d1c1bda519da248bd94fb4bdc236dd16fcca36eb4fc1262f7a58。报告不把另一个标签固化/双后端版本的 +0.328/+0.023 ns 时序或切换展示计入此包。实际匹配报告为 +0.255/+0.020 ns。

资源与时序（包内 72b358ff 版，历史板卡日期不作为主机日期）：

项 | 数量 | 占片上总量
查找表 LUT | 31515 | 59.24%
触发器 | 27570 | 25.91%
存储块 BRAM | 96.5 / 140 | 68.93%
数字信号处理单元 DSP | 91 / 220 | 41.36%
时序裕量（建立/保持） | +0.255/+0.020 纳秒（72b358ff 版） | 时序全满足、零违例

资源/时序取自 build/form3_pspl_resident，动态记录取自 board/form3_pspl_resident/logs/live_gesture7_v2。板卡历史时钟停留在 2022 年，文件名中的日期也不自动等于主机实际测试日期；本次新增实测以 boot ID、单调时间和输入哈希确定身份。

机械臂闭环口径（三态分清）：历史已验=单模型链 13 次触发 13 完成 0 失败+79 秒空场景零误触发、20/20/0 臂链；现状=三网版蓝牙整合构建过、板测未验，现役演示链禁用臂动作；如实分写。

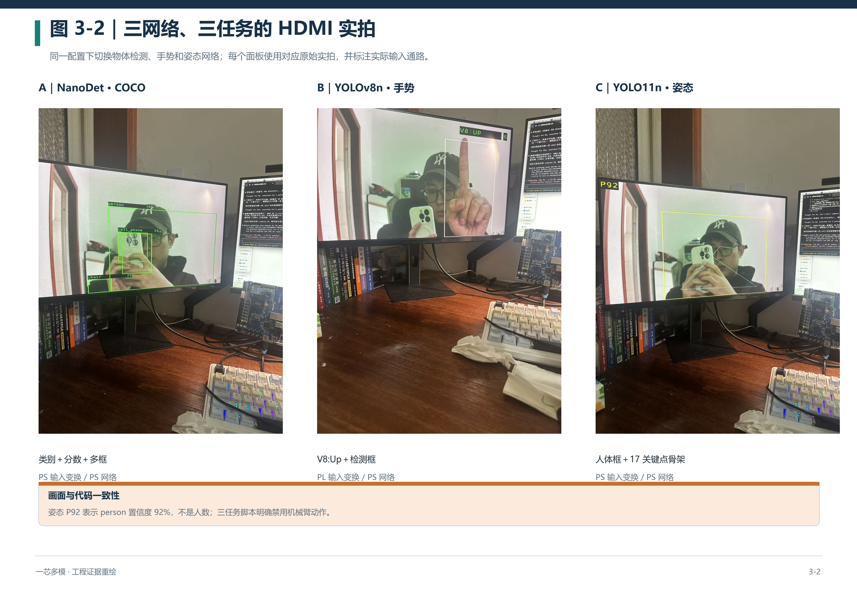
[picture p27: figure]

图 3-2 三任务HDMI实拍

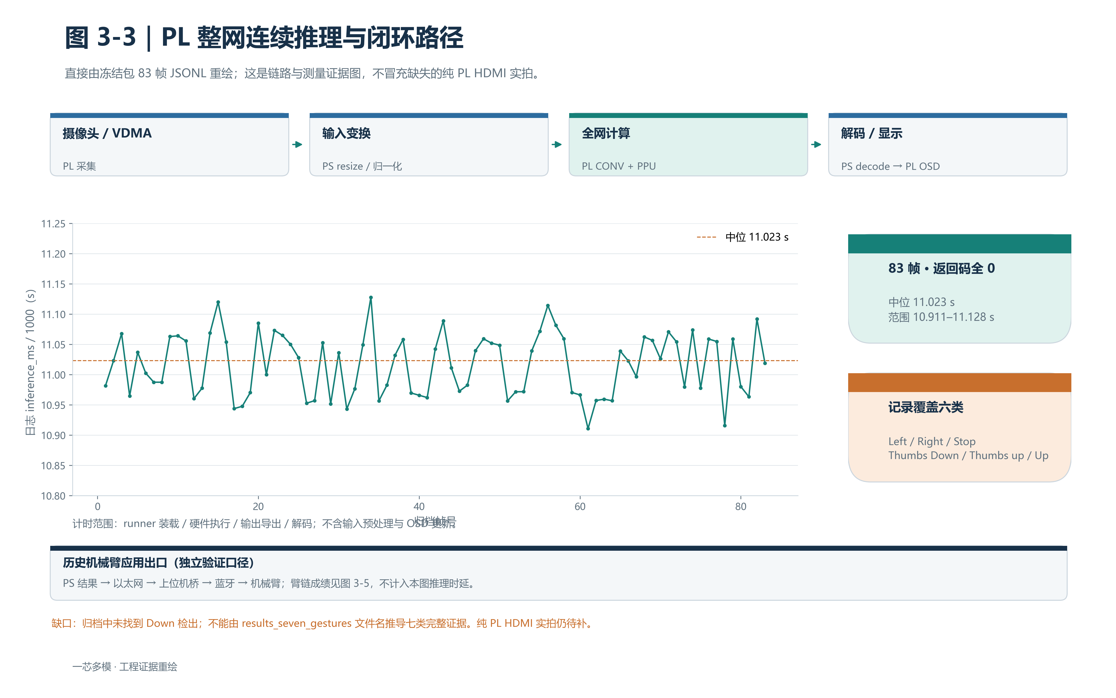
[picture p28: figure]

图 3-3 连续推理测量与闭环（83 帧、六类，Down 与纯 PL 实拍待补）


图 3-4 双后端真实展示（历史另一版本；不作为本包驻留版的双后端验收）

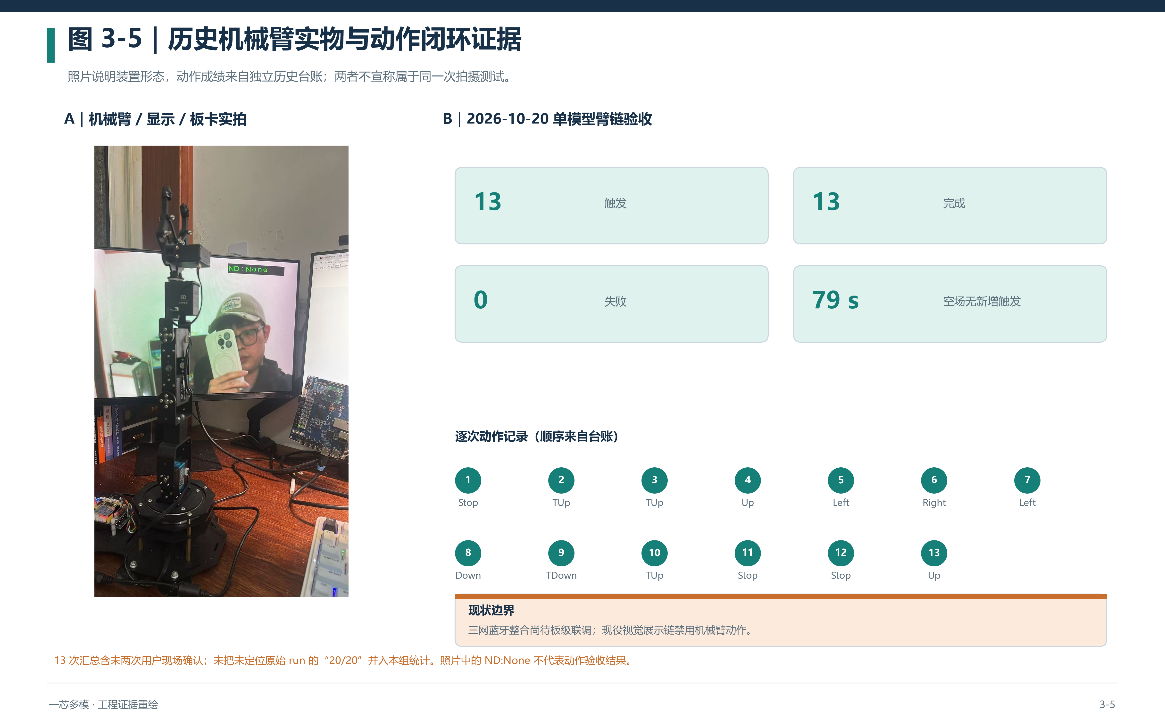
[picture p29: figure]

图 3-5 机械臂实物与闭环台账

## 3.3 特性成果与量化指标（分表禁混口径）

模型离线精度与板端识别率分开解释。当前可直接重算的帧时为：混合最终 488 帧中位 2496.7375 ms，纯 PL 连续 83 帧中位 11023.045 ms。混合记录七类检出、23 次恢复；纯 PL 记录六类、缺 Down。历史 62.27 倍属于第一代 7.77 秒方案相对 483.81 秒软件参考，不能作为当前混合或约 11 秒连续版的加速比。机械臂历史台账与现役视觉链分开验收。

## 3.4 大模型协作与技能包

### 3.4.1 协作机制与制度演化

多平台大模型分工：实现方（RTL/工程实现）×审计记录方（日志/交叉核对/否决性审计）×人类裁决（验收判定/里程碑放行）。制度随真实事件演化：一次蓝牙归因不清引发信任危机→BLE 从头重建并立板门→否决性审计日（单元通过被写成"整网收官"降级、验证器缺陷、量化质量不合格三案同日纠出）→工具链制度化（下述 ROSS）→全权接管夜（六批板链 6/6+应力 10/10 后人类裁定放行）。

### 3.4.2 AMD ROSS 使用心得（官方智能体工作流，本工程 10 月 3 日部署）

①Vivado 全流程效率显著提升。 按官方标准步骤，通过官方 MCP 工具一键调起 Vivado 全家桶（打开工程/综合/实现/仿真/位流/文档检索），不再为每步手写临时脚本，工程操作从"脚本拼装"变为"标准流程调用"。

②自带仿真器打通（此前长期痛点）。 智能体直接调用 XSim 历来易报错（环境/库路径/会话状态连环失败）；而对 Xilinx 原生 IP，必须使用自带仿真器与预编译库才准确便捷。引入 ROSS 后仿真可快速调起——本质上仍是①的收益，但落在最痛的点上。团队并沉淀出"连接成功/流程成功/功能成功"三段式验收：会话活着≠仿真跑对，三层分开判定（来自一次真实失败复盘）。

③IP 使用更规范。 官方文档检索工具+团队自定义技能双重约束：自定义技能中立有"IP 排障铁律——第一动作即翻官方手册逐引脚核对使能/复位/极性"；团队使用规则进一步要求 IP 例化一律取 Vivado 生成的 .veo 实例化模板、参数以官方手册为准、禁止凭记忆臆写端口。官方能力管"调得起来"，自定义纪律管"不许臆想"。

④（补充）官方技能与自建纪律分层互补。 ROSS/MCP 负责工具调用与执行；自建技能负责工程边界——证据必须落指定目录、冻结区禁写、失败不得假装执行、超范围即停。两者配合后单日完成 113 项验证任务（工程全程峰值）。

⑤（补充）原始会话留档使智能体工作可审计。 一次"空报告被解析出两条记录"的纠错正因原始会话 JSONL 完整留档才可复盘——大模型工程的可信度来自证据链而非信任本身。

### 3.4.3 十个代表案例与七类纠错

跨平台十个代表案例（每例含指令→执行→失败观察→纠错→验收→规则沉淀），覆盖：解析器误读空报告、方案语义纠正、验收范围降级、仿真流程结构化、编辑工具循环、下载成功≠功能成功、屏幕乱码四层根因、性能负结果停止、错误恢复与语义修正、文档边界纠错。归纳为七类可复用纠错机制：工具接口（先确认工具合同）、流程环境（三段式验收）、测试自证（脚本/测试/被测物证据独立）、验收范围（结论绑定输入+配置+制品哈希）、数据语义（以原始数据集与实机终审为准）、部署运行（部署=状态迁移非文件复制）、性能路线（不以理论收益替代整网实测）。

### 3.4.4 技能包提炼

三层技能体系：复用层（版本库管理，14 项）→活动层（项目覆盖）→会话层（含 ROSS 官方技能装配）；踩坑台账 318 条（症状→根因→修复→检测门四段式，三副本哈希齐一），"同型检索→修复→回填检测门"闭环使同类坑复发率持续下降。核心可移交技能六件（覆盖部署/硬件工作流/有界委派/坑账/文档解析/日志），其中 PYNQ Overlay 硬件工作流技能以"换板卡、换题目仍可用"为通用性标准沉淀，正对赛题设立的通用 PYNQ 技能加分方向。诚实边界：个别平台原始逐字会话缺失，以日志摘录为界、不冒充完整导出。

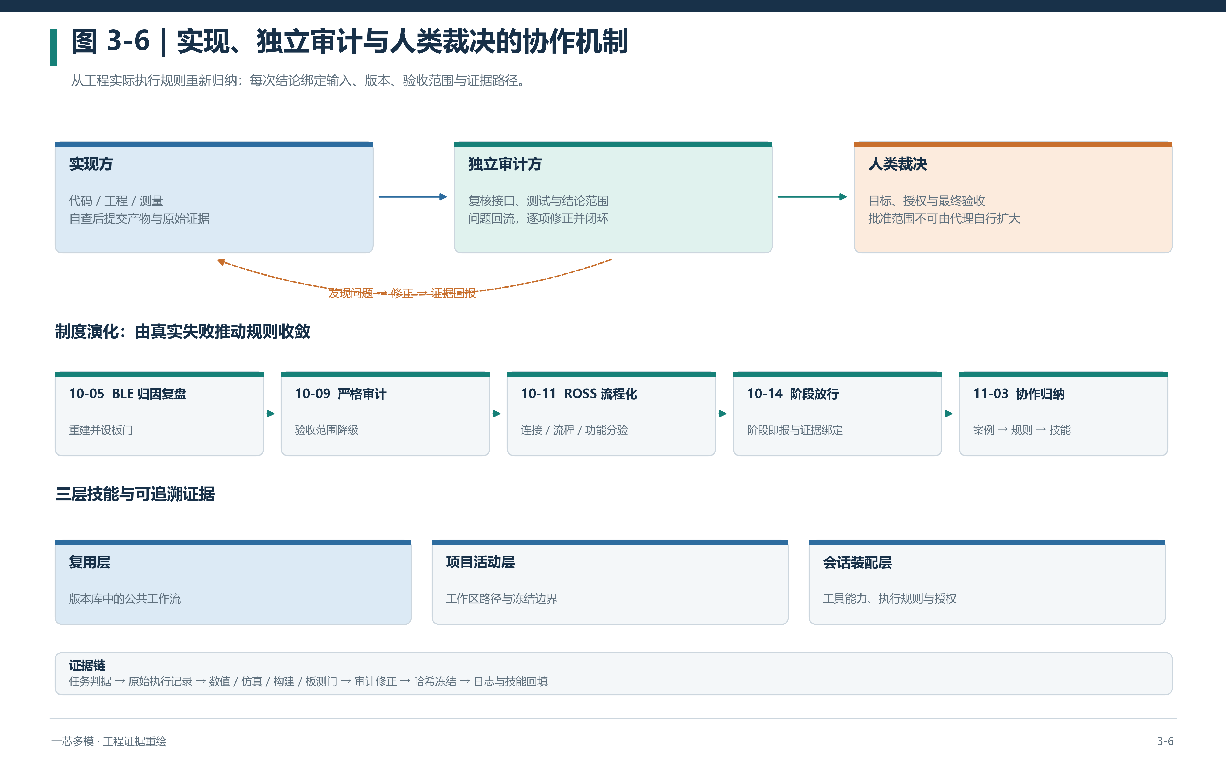
[picture p30: figure]

图 3-6 协作机制与技能沉淀

## 3.5 可复现性与验证体系

验证分为静态依赖、仿真、Vivado 构建、板级功能和恢复五层。截至 2026-11-04，六个源工程均完成包内预检；形态一A两版、形态二和 AC1 已在 Vivado 2025.2 中通过 PACKAGE_PROJECT_VALIDATION_PASS，形态一B和形态三已从包内源码完成 BIT/XSA 重建。OSD 四项回归通过，三种部署树均已离线生成。形态二新增 21/21 固定输入比对入口并完成语法与部署树核验，但尚未在板上执行；形态一A、形态二和 AC1 的完整 BIT 重建以及各形态当前部署板测不得据此宣称完成。历史实测、本次重建和未执行项目分别记录。

# 第四部分 总结

## 4.1 可扩展之处

①多网络硬件换载终态（YOLOv8n↔YOLO11n 统一 43 槽任务表，方案已定、板级联调待做）；②混合提速三向：层间流水加深、连续卷积中间结果驻留片上、多矩阵乘核并行——目标低于纯处理器 1.05 秒；③识别率系统量化与针对本摄像头域的重训练（现有 COCO 演示网未重训练）；④多帧批处理与更多网络族；⑤三网版蓝牙整合板测（构建已过）；⑥视觉-语言-动作大模型上板前瞻（当前仅 PC 侧验证：显存 6.79GiB、冷启动 31.2 秒/热 0.197 秒，如实为界）。

## 4.2 心得体会

①合同一致性是协同的地基：输入合同（预处理逐位一致）、量化合同（整数参考=公平分母）、接口合同（任务描述字三代兼容）三份合同贯穿两个月，任何"对不上"最终都追溯到合同漂移。②描述符长期主义：任务单格式从第一代到统一 43 槽方案未破坏兼容，是"硬件不动换任务"的根。③单轮好结果不可外推：时序过一次不等于有余量（曾以 0.053 纳秒裕量险胜后失败）；板卡时钟设置值与实际频率成 2/3 关系（实测发现），一切以硬件周期计数实测为准。④可复现交付观：1352 个验证目录、哈希绑定、负结果留档——失败路径的完整记录与成功同样值钱（三段并发回退、75 兆赫兹无效、布局锁无收益都成了后续决策依据）。⑤两条工程律：逻辑资源超九成后禁再加流水（先省后加）；大模型协作必须"能力（官方工具）+纪律（自定义边界技能）+证据（原始会话留档）"三件套，缺一则不可信。

# 第五部分 参考文献

[1] Zynq-7000 SoC 数据手册（DS190）

[2] 7 系列 DSP48E1 用户指南（UG479）

[3] AXI 参考指南（UG761）

[4] Vivado 实现/时序/仿真/告警用户指南（UG904/905/906/912）

[5] UltraFast 设计方法学（UG949）

[6] ONNX 开放神经网络交换规范

[7] ncnn 移动端前向推理框架

[8] PYNQ 框架（Python Productivity for Zynq）

[9] YOLOv8／YOLO11／NanoDet-Plus 论文

[10] OV5640 图像传感器数据手册

[11] ADV7511 HDMI 发送芯片数据手册

[12] AMD ROSS 智能体助手（ross-ai-assistant）文档

# 附录 A 复现说明

环境：Vivado 2025.2；EES-331 与现有 PYNQ 3.0.1 镜像；主机 Python 3.10+、OpenSSH。所有输出目录必须位于提交包之外。从包根执行：python build/prepare_build.py --form form3_pspl_resident --output <新构建目录> --stage bitstream；随后用 Vivado 2025.2 batch 运行该目录的 run.tcl，并同时核对综合/实现进度、黑盒、时序、DRC 和最终标记。其他形态可将 --stage 改为 validate；形态名见 --help。OSD 复跑：python build/verify_osd.py --vivado-home <Vivado安装目录> --output <新仿真目录>，要求四项全部通过。部署树生成：python build/stage_submission.py --form <形态> --output <新部署目录> --remote-root /home/xilinx/amd_submission/<新版本>；加 --upload 才上传及逐文件校验，上传不启动硬件。形态二固定输入板测：python build/board_transport.py --script build/verify_form2.py --script-arg <板端部署目录> --output <新证据目录> --sudo --timeout 420；形态三对应脚本为 verify_form3.py，手势序列加 --script-arg=--gestures 并提高超时。板测会暂停摄像头服务，须先取得现场授权，并由 overlay skill 核对所有权、DMA 停止和恢复门；恢复原服务必须看到新帧且现场确认 HDMI。最新验证状态见 build/validation_status.md。

# 附录 B 本次可复现性修复与技能实测

复现工具固定为 Vivado 2025.2。形态三已从包内源码完成综合、实现、BIT 与 XSA 导出，重建 WNS/WHS 为 +0.030/+0.017 ns；形态一B重建为 +0.153/+0.010 ns。它们均不能混同历史交付位流的报告。形态一A两版、形态二和 AC1 另完成真实工程打开、模块引用、BD 校验与 IP 状态检查；AC1 的模块引用 XCI 已按当前 BD 补回。上述 validate 结果不等于这些形态的完整 BIT 重建通过。形态三重建仍有 TIMING-6/7/51 时钟关系告警，10 个输入、25 个输出没有 delay 约束；正裕量仅表示已定义约束满足。

Overlay skill 使用当前摄像头基线的独立副本实测：按配对 HWH 确定 VDMA 基址，停止原服务后验证两路 RS=0 且 Halted=1；加载、等待传感器稳定后 8.0276 秒获得 41 帧，读写槽变化 240/239。退出后 DMA 停止、缓冲释放；原服务恢复帧数 11→21，同一 boot ID，用户确认 HDMI 连续正常。该结论仅覆盖基线热加载及恢复，不覆盖竞赛 BIT 或手势准确率。证据摘要见 board/skill_validation。

MinerU skill 已修复 Office 输出目录识别问题，原技术报告与协作记录重新解析均为 MINERU_PARSE_PASS，中文质量 pass。文档中参考历史事件的时间与板卡系统日期保留区别，不用旧日期字符串推断新的完成时间。

本次新增七手势严格序列验收：包内 72b358ff 位流与修复后软件共运行 69 帧，69 个输入哈希不同；Down、Left、Right、Stop、Thumbs Down、Thumbs up、Up 均达到连续两帧置信度不低于 0.55。逐项原始图像与结果哈希一致，用户确认 HDMI 标签/检测框及恢复后连续画面正常。该轮中位帧时 2490.974 ms，2 帧记录 PL 自动恢复；它证明本次七类展示流程，不代替统计数据集准确率，也不作为新重建位流的板证。

形态一B和形态三的 BIT/XSA 重建标记分别为 PACKAGE_BITSTREAM_BUILD_COMPLETE 与 VITA_VIVADO_RESULT PASS。OSD 入口已在当前提交包上重新通过 XSim 无 IP 冒烟、COCO/姿态正向测试及历史字体缺陷负控，总标记为 OSD_REGRESSION_PASS。三种部署树的文件数分别为 53、109、120（形态二包含新增固定输入入口），均只在本地生成，未上传。形态二固定输入入口会检查 21/21 个黄金平面并恢复原摄像头服务，但该入口尚未实际板测。

恢复失败与修复：赛题位流的早期冒烟退出后，原摄像头程序因热加载只等待 1 秒、首帧窗口仅 5 秒而超时。该失败保留；随后在独立目录使用等待 10 秒、首帧窗口 30 秒的基线副本恢复，用户确认画面正常。仅本次开机有效的服务配置指向该副本，原 BIT/HWH 与程序保留。七手势验收结束后也成功恢复。

原创代码和原创文档采用 MIT，第三方组件、模型与数据继续保留各自许可；详见 license.txt、third_party_notices.md 和 licenses/。目标公开仓库为 https://github.com/pipidandan-superman/FPGA_2026_competition，实际上传状态以该仓库为准。尚未闭合的技术事项包括形态一A、形态二和 AC1 的完整 BIT 重建，形态二新增固定输入入口及当前部署的板端复验，纯 PL Down 类证据和指定实物补拍；未执行项目不写成通过。最新状态见 build/validation_status.md。

“一芯多模”技术报告
