pipidandan-superman/FPGA_2026_competition/report/figures/alt_v3_cnn_accelerator_architecture.png

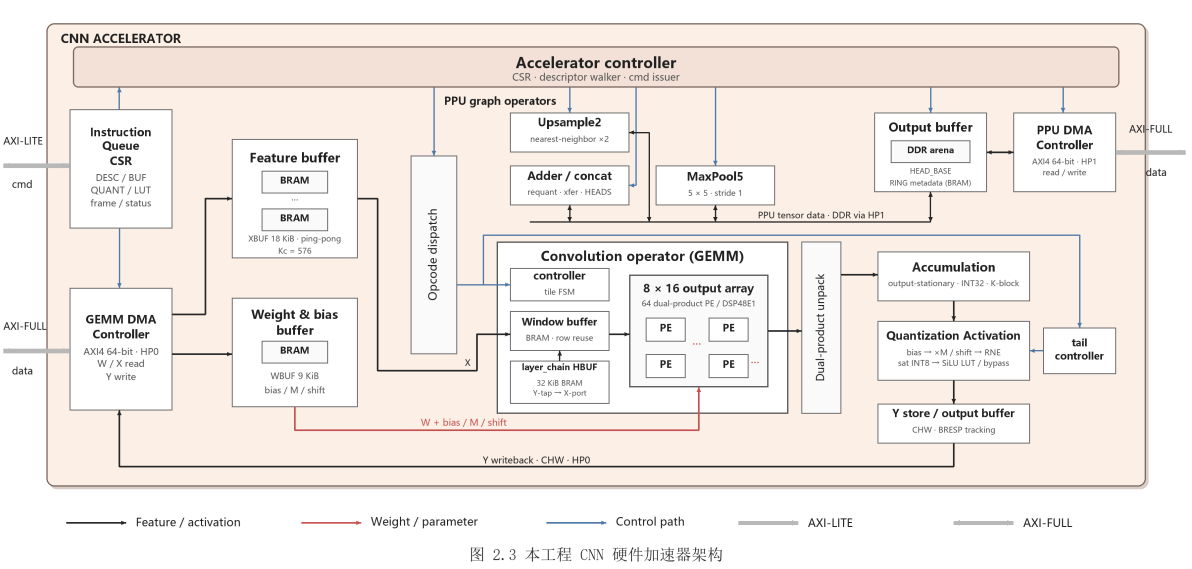
report/figures/alt_v3_cnn_accelerator_architecture.png
