pipidandan-superman/FPGA_2026_competition/report/figures/fig_1_1_twelve_phase_timeline.png

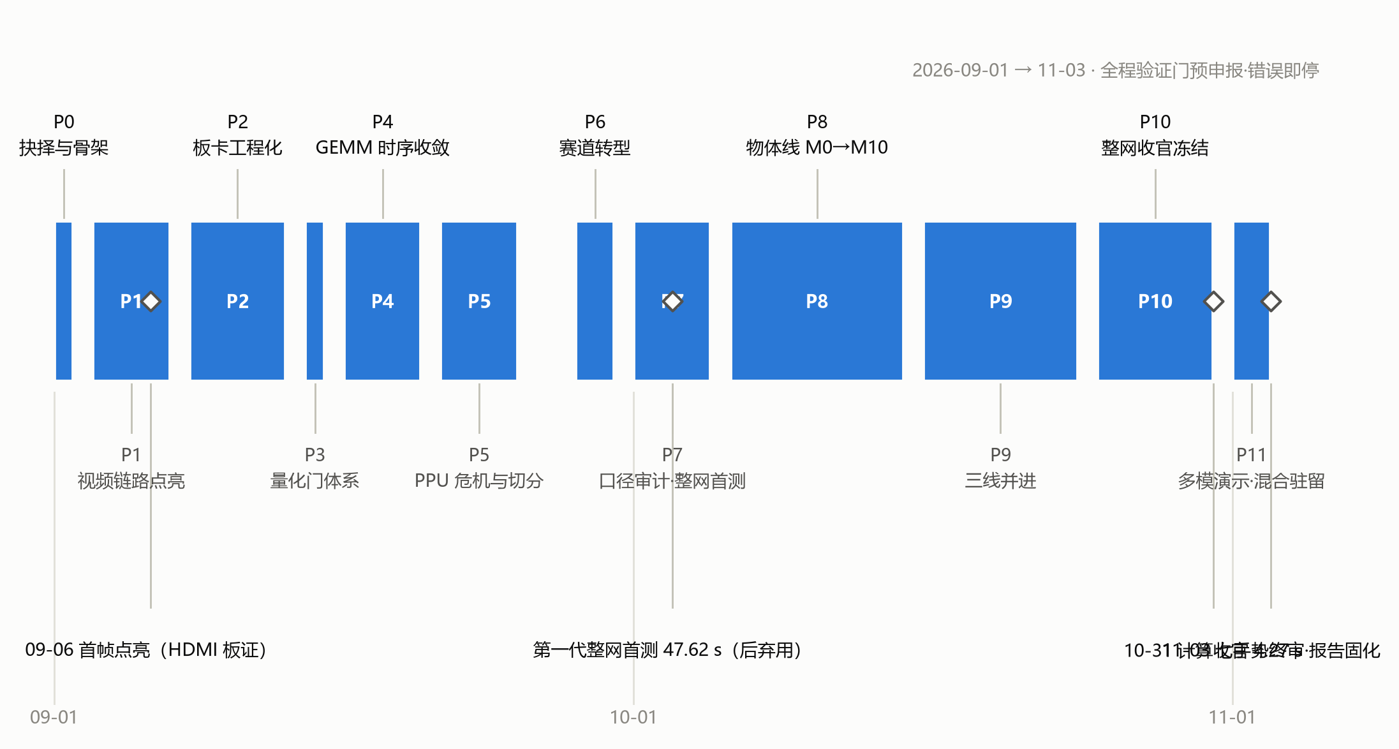
report/figures/fig_1_1_twelve_phase_timeline.png
