pipidandan-superman/FPGA_2026_competition/report/figures/fig_2_1_system_architecture.png

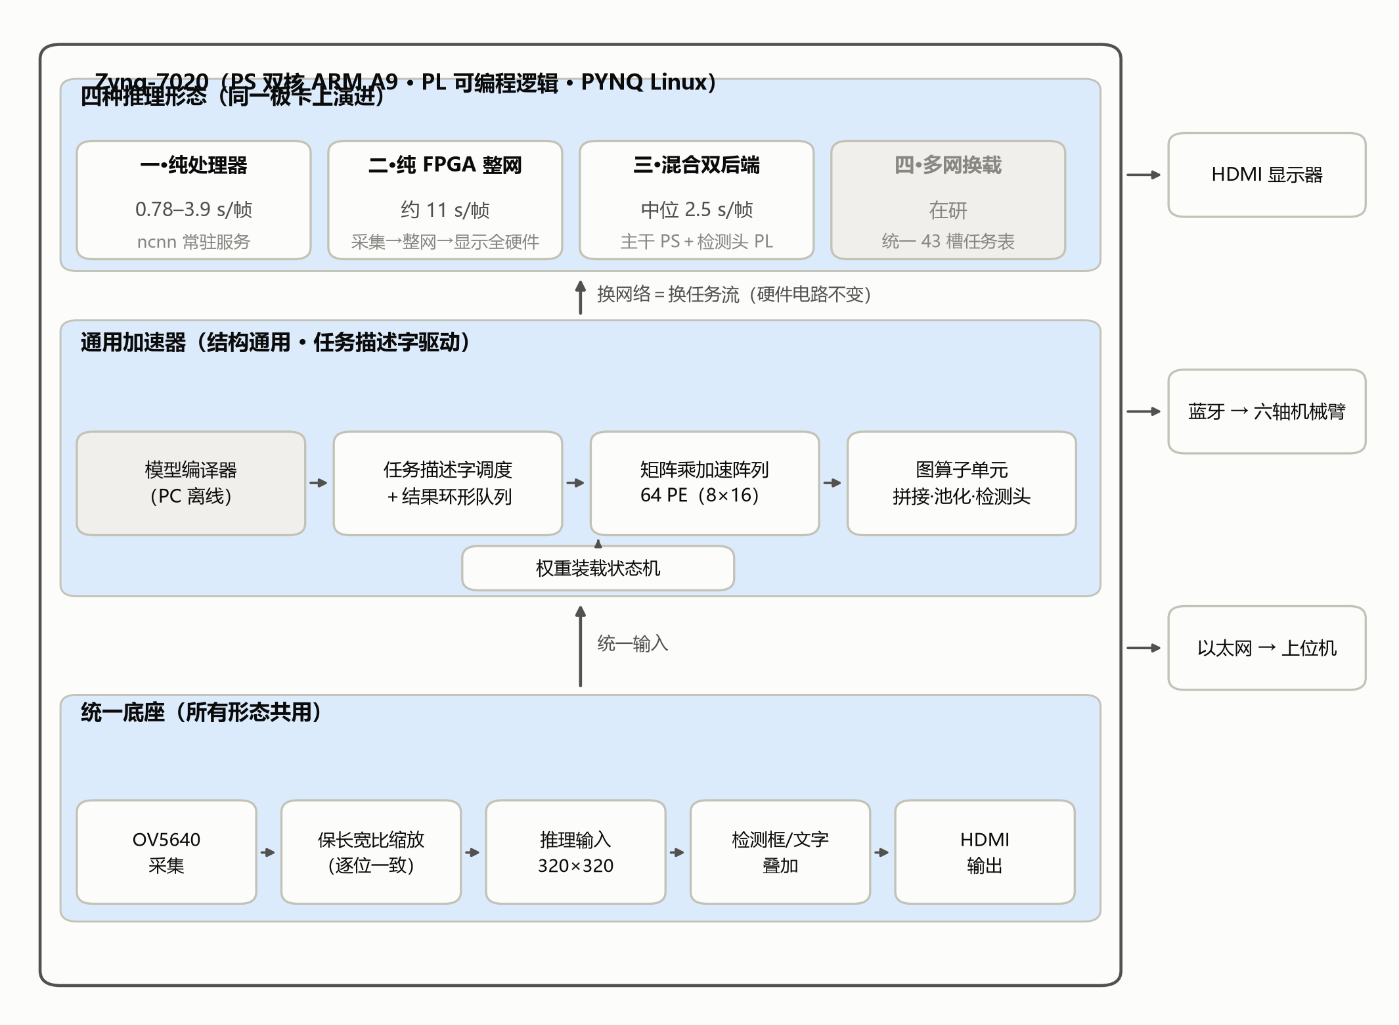
report/figures/fig_2_1_system_architecture.png
