pipidandan-superman/FPGA_2026_competition/report/figures/fig_2_2_accelerator_microarchitecture.png

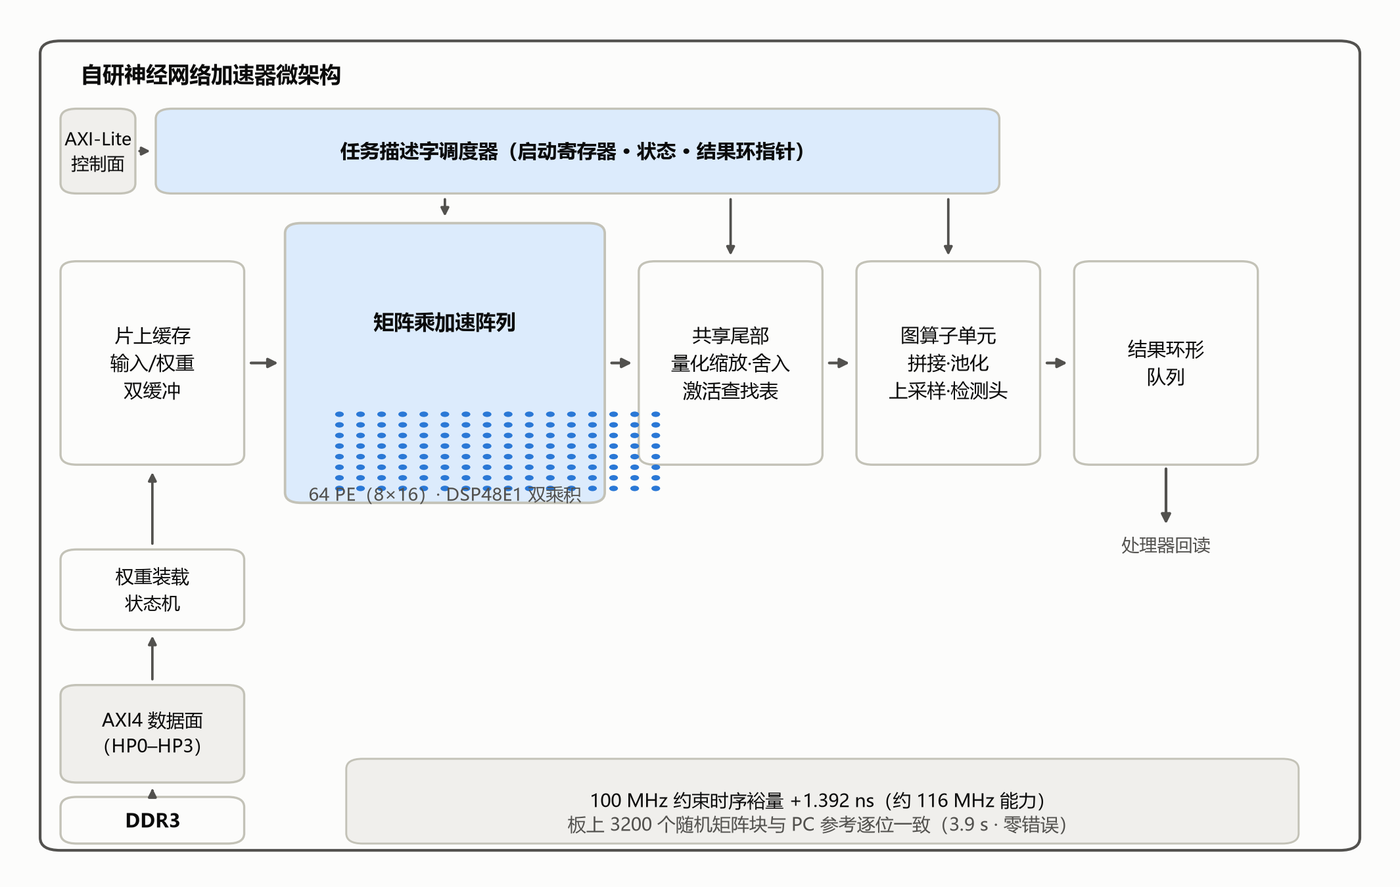
report/figures/fig_2_2_accelerator_microarchitecture.png
