pipidandan-superman/FPGA_2026_competition/report/figures/fig_2_3_task_descriptor_and_scheduling.png

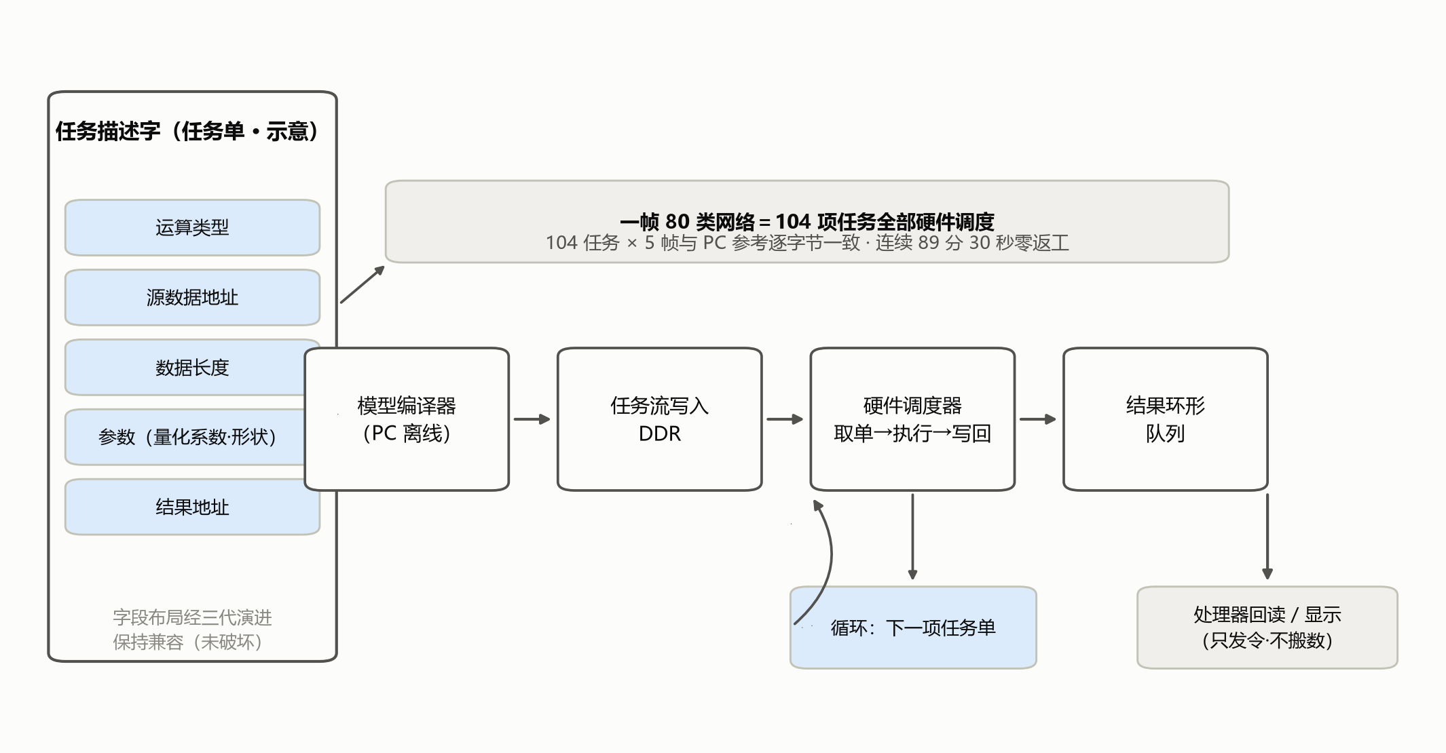
report/figures/fig_2_3_task_descriptor_and_scheduling.png
