pipidandan-superman/FPGA_2026_competition/report/figures/fig_2_4_training_iteration_comparison.png

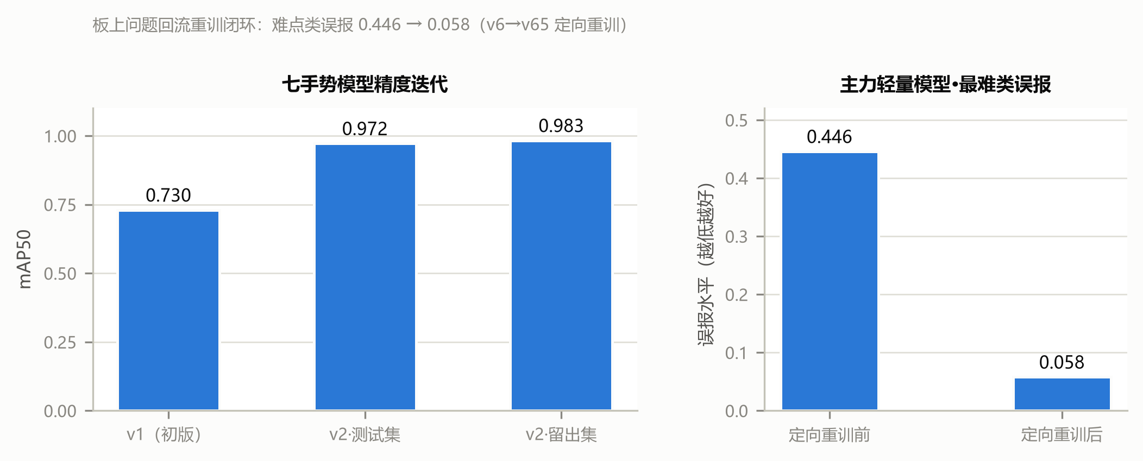
report/figures/fig_2_4_training_iteration_comparison.png
