pipidandan-superman/FPGA_2026_competition/report/figures/fig_2_5_seven_round_speedup.png

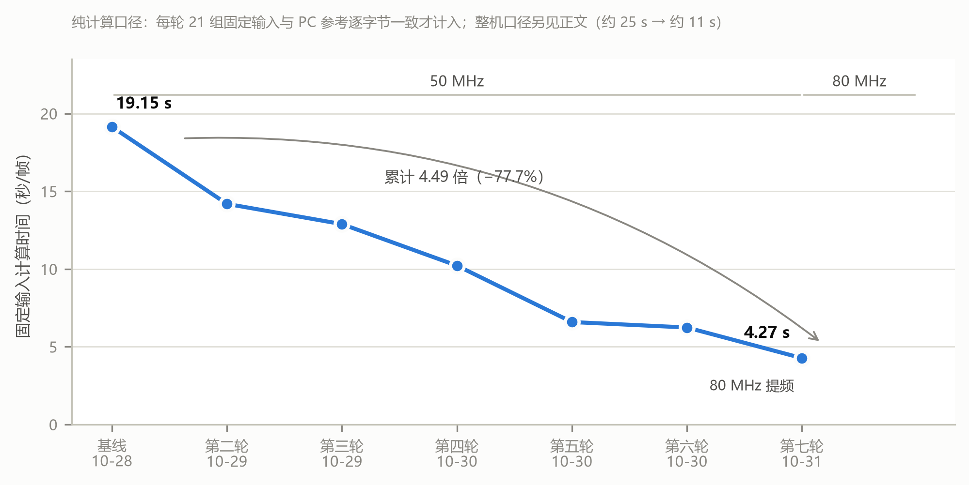
report/figures/fig_2_5_seven_round_speedup.png
