pipidandan-superman/FPGA_2026_competition/report/figures/fig_2_6_resource_optimization.png

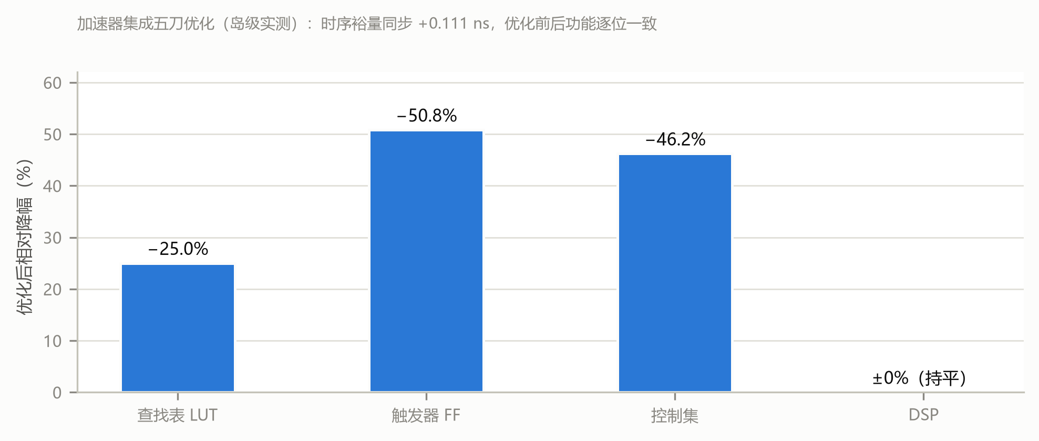
report/figures/fig_2_6_resource_optimization.png
