pipidandan-superman/FPGA_2026_competition/report/figures/fig_2_7_backend_latency_lut_scatter.png

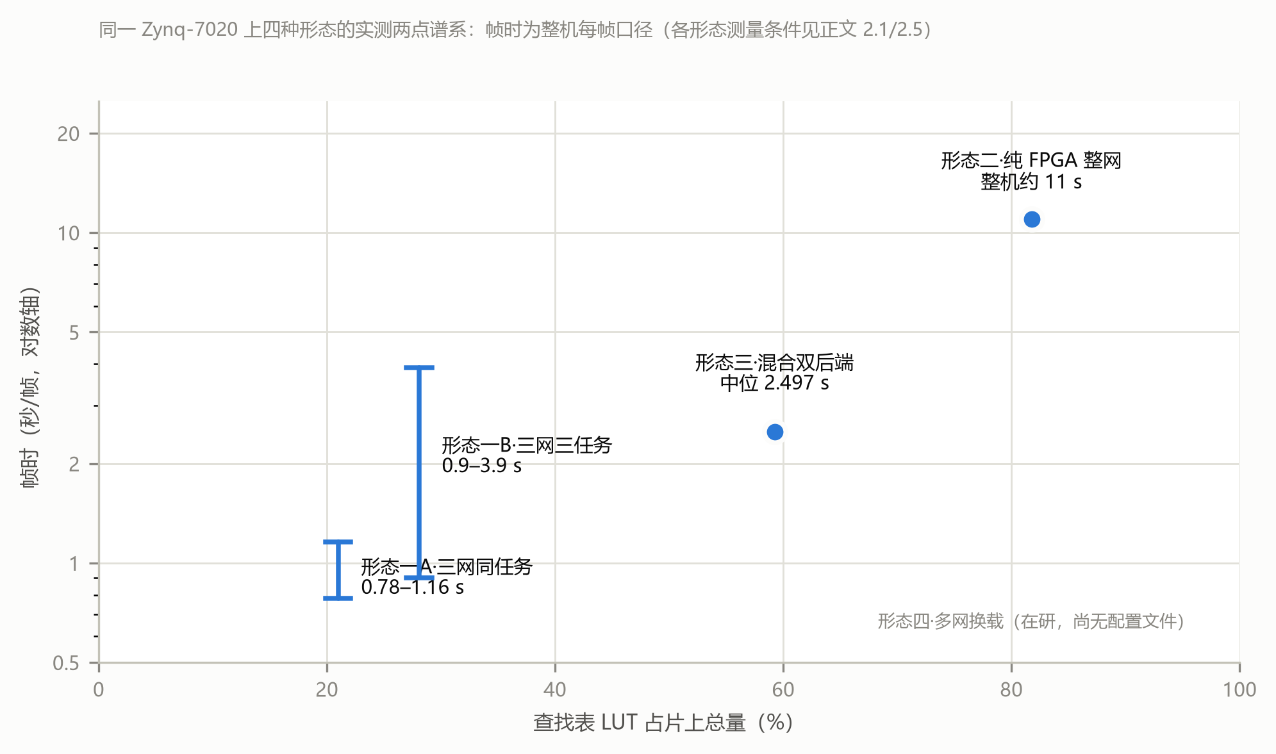
report/figures/fig_2_7_backend_latency_lut_scatter.png
