pipidandan-superman/FPGA_2026_competition/report/figures/fig_3_6_llm_collaboration_mechanism.png

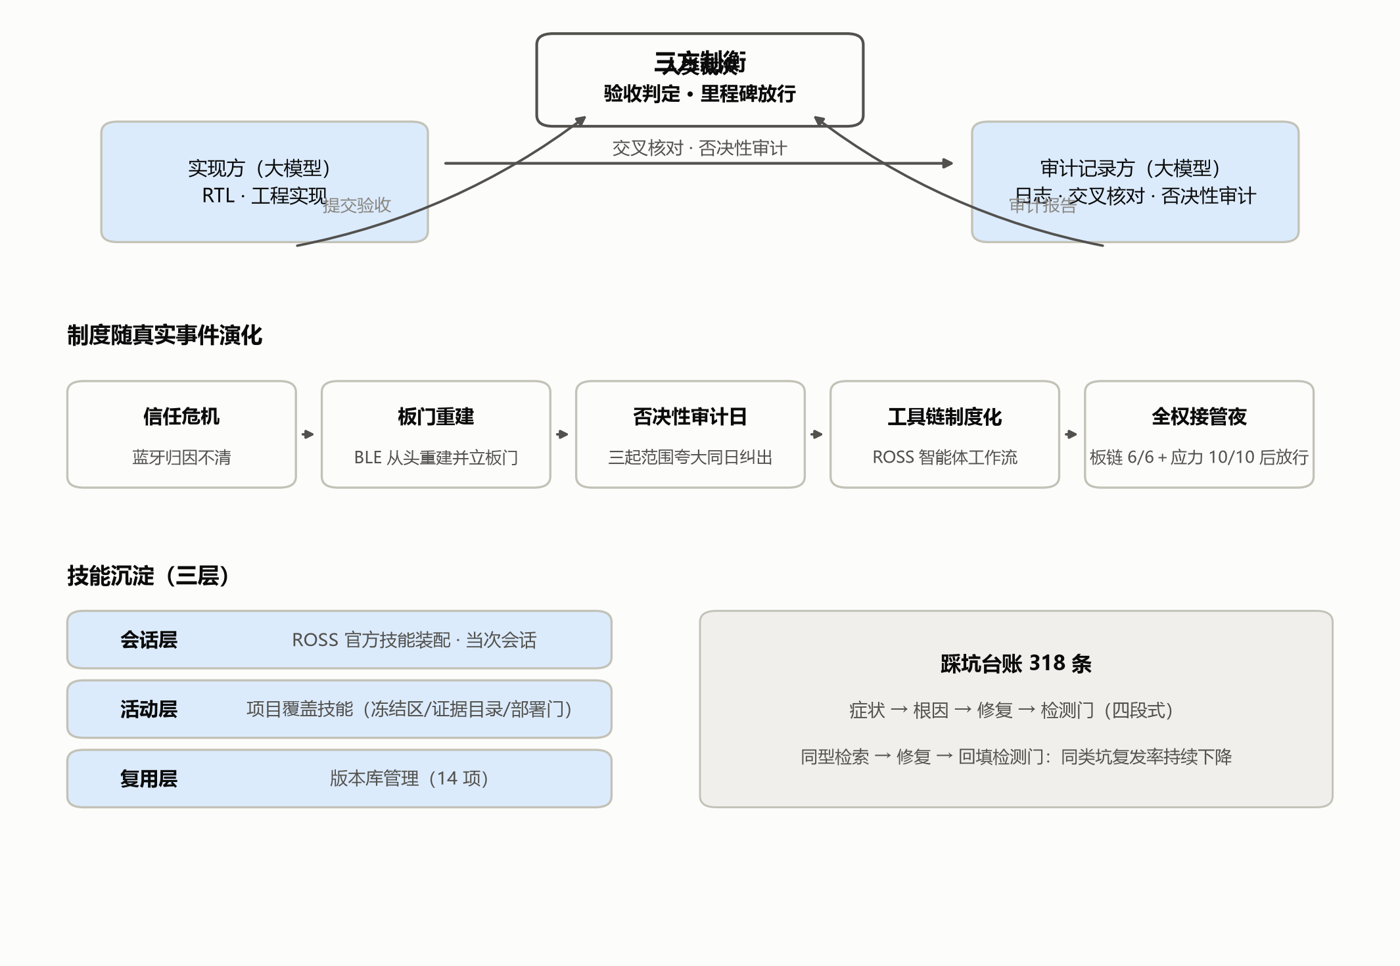
report/figures/fig_3_6_llm_collaboration_mechanism.png
