pipidandan-superman/FPGA_2026_competition/report/photos/photo_3_2a_multitask_detection.jpg

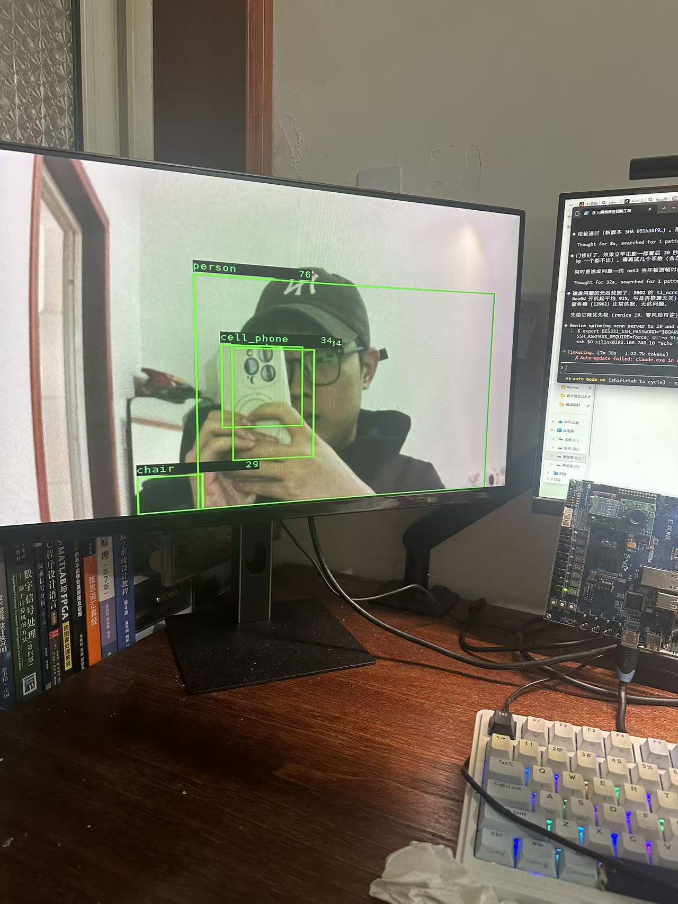
report/photos/photo_3_2a_multitask_detection.jpg
