pipidandan-superman/FPGA_2026_competition/report/photos/photo_3_2b_multitask_gesture.jpg

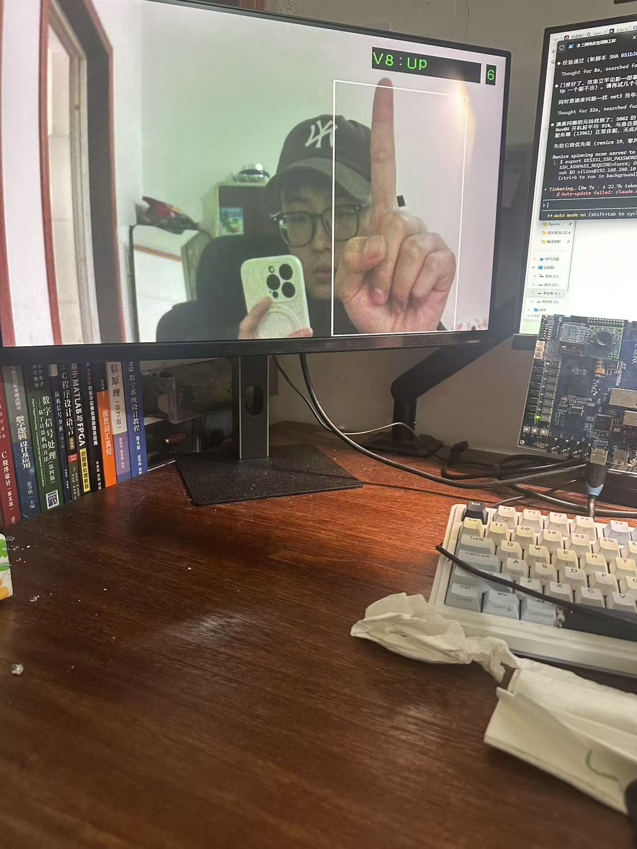
report/photos/photo_3_2b_multitask_gesture.jpg
