pipidandan-superman/FPGA_2026_competition/report/photos/photo_3_2c_multitask_pose.jpg

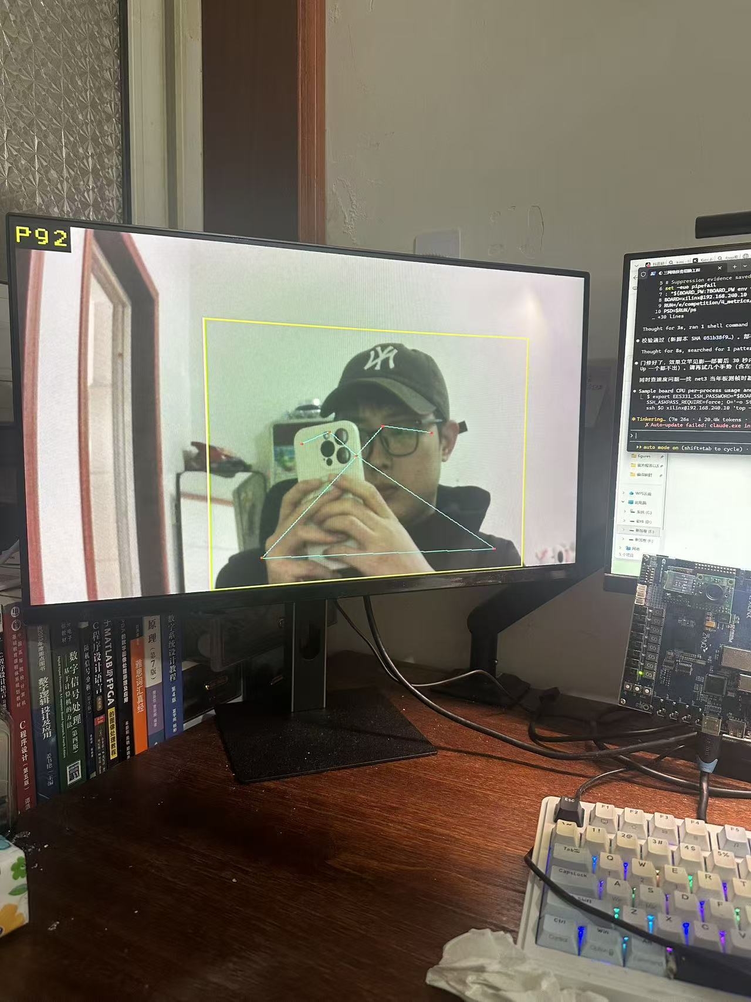
report/photos/photo_3_2c_multitask_pose.jpg
