pipidandan-superman/FPGA_2026_competition/report/photos/photo_3_3a_board_demo_20261101.jpg

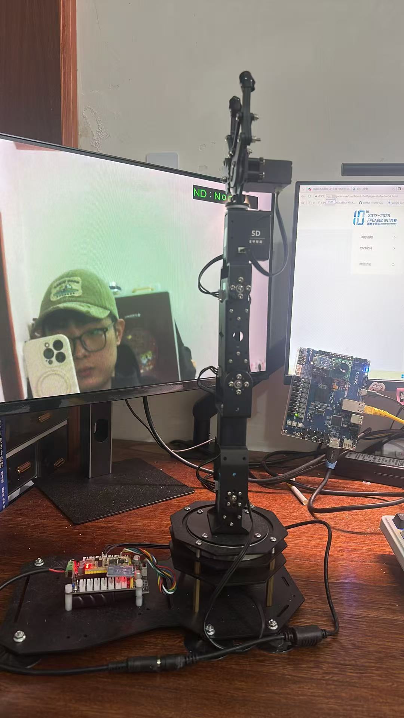
report/photos/photo_3_3a_board_demo_20261101.jpg
