pipidandan-superman/FPGA_2026_competition/report/photos/photo_3_3c_board_demo_20261101.jpg

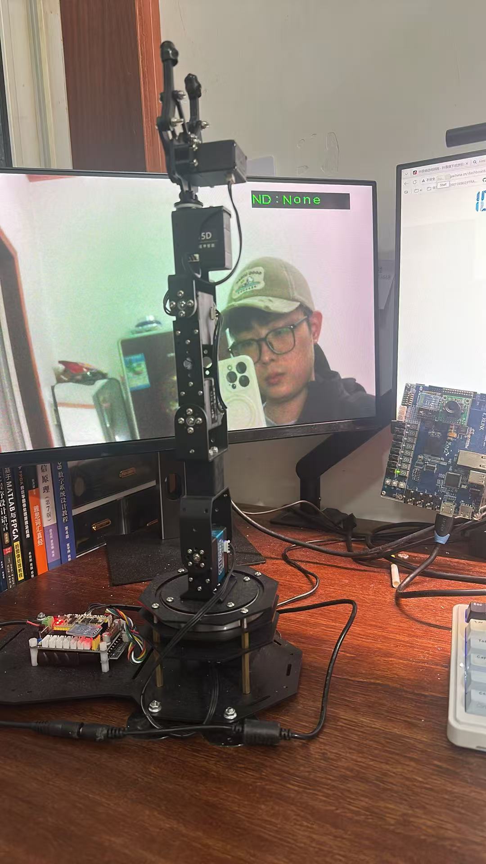
report/photos/photo_3_3c_board_demo_20261101.jpg
