pipidandan-superman/FPGA_2026_competition/report/photos/photo_3_4b_dual_backend_2.jpg

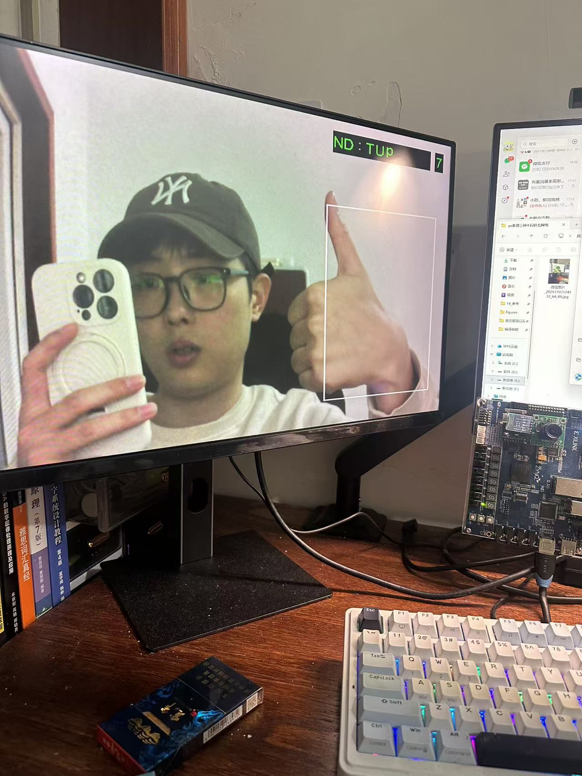
report/photos/photo_3_4b_dual_backend_2.jpg
