pipidandan-superman/FPGA_2026_competition/build/accelerator_ac1/provenance/material_sha256.txt

b99c2c3d47de3d202989fc6d47b70031a8f39a1c4a71b4d672985710c882a87f  E:/competition/4_metrics/logs/2026-10-18_yolo_m11_r11_build_run01/rtl_shadow_r11/src/rtl/m9_v25_bd_shim_v3.v
40d9db929f5f39d84048dabf0ec9ed1284ee07855f89a17647a2b3aeb13b63b6  E:/competition/4_metrics/logs/2026-10-18_yolo_m11_r11_build_run01/rtl_shadow_r11/src/rtl/m9_v25_top_v3.v
d98c577953677f9d360116ae6cddbe1c15f40a3bfd992103fc789ec933b76ea4  E:/competition/4_metrics/logs/2026-10-18_yolo_m11_r11_build_run01/rtl_shadow_r11/src/rtl/m9_intra_axi_top_v3.v
af41bfc77e7d7dbc20c02c2b86bc064c5454b0f9bd7aa976183546ac67ad2451  E:/competition/4_metrics/logs/2026-10-18_yolo_m11_r11_build_run01/rtl_shadow_r11/src/rtl/m9_intra_top_v3.v
d7d376c25e32755c955d7bcd3ecfc1b6bdb70d76b1b0e40f37bbef3271f8647c  E:/competition/4_metrics/logs/2026-10-18_yolo_m11_r11_build_run01/rtl_shadow_r11/src/rtl/m9_cmd_issuer.v
30a05f51e5a327ab97fb2ea0531f40dbbc465402b72c158f523e603f692fdad6  E:/competition/4_metrics/logs/2026-10-18_yolo_m11_r11_build_run01/rtl_shadow_r11/src/rtl/m9_x_window_v3.v
d545001a93723d49fcb220378294656c402deb39df14c0a835882cd2b8cf1869  E:/competition/4_metrics/logs/2026-10-18_yolo_m11_r11_build_run01/rtl_shadow_r11/src/rtl/m9_plan_roms.v
eb01e52b54d24ae725cbcc893561858d4f571e6049934094cb0871af52abcbc7  E:/competition/4_metrics/logs/2026-10-18_yolo_m11_r11_build_run01/rtl_shadow_r11/src/rtl/m9_abi_v2_csr.v
73cfd7e26974992445d414aea0df6cf30c80e9964bb6c00074badc7221be4f08  E:/competition/4_metrics/logs/2026-10-18_yolo_m11_r11_build_run01/rtl_shadow_r11/src/rtl/m9_hbuf_ctrl.v
22b81ce53202db2ef5ef0c597d7804998481f106524169ef79cd27c31928cb61  E:/competition/4_metrics/logs/2026-10-18_yolo_m11_r11_build_run01/rtl_shadow_r11/src/rtl/m9_axi_wr.v
d11643197abb6883f5520a1ffdca4b9026084bf2ea900e8f412697d49e5b1c0d  E:/competition/4_metrics/logs/2026-10-18_yolo_m11_r11_build_run01/rtl_shadow_r11/src/rtl/m9_y_scatter.v
65e8b2af0c59d05db9d807c231f850652216b160f645267463dd774ece92ff2a  E:/competition/4_metrics/logs/2026-10-18_yolo_m11_r11_build_run01/rtl_shadow_r11/src/rtl/m9_trace_v2b.v
9cc201be945970a613c86428881a8a5a63c3c87d70a7aaff3489c704c3b708ab  E:/competition/4_metrics/logs/2026-10-18_yolo_m11_r11_build_run01/rtl_shadow_r11/src/rtl/m9_scatter_chw_repack.v
9f7f04fdf4c6d13af4c5f4db695257c06eb68de66f6e2618726f721f22c8c06b  E:/competition/4_metrics/logs/2026-10-18_yolo_m11_r11_build_run01/rtl_shadow_r11/src/rtl/m9_repack_glue.v
eaace68847df2e7bc6c21eeac93ed0c0991ff43657238eb8d744a7cea6fa3614  E:/competition/4_metrics/logs/2026-10-24_integration_build_ac_run01/vivado_v25/yolo_v25_board/yolo_v25_board.srcs/sources_1/ip/m9_bm_hbuf/m9_bm_hbuf.xci
62888c88964cbeada1815ad68dd3bf83e7a5be5615ec3e22d310470df39af336  E:/competition/4_metrics/logs/2026-10-24_integration_build_ac_run01/vivado_v25/yolo_v25_board/yolo_v25_board.srcs/sources_1/ip/m9_bm_wlay/m9_bm_wlay.xci
6def3f82ae521329076fc2304323124ad27c2d1869e58121a040c367ad55eb52  E:/competition/4_metrics/logs/2026-10-18_yolo_m10_r10_rom_rebake_run01/coe/R10/pctl.coe
b8d97b4bf34130b35bd5e2c4d7a09d89ecd5c9924c079182e489118995df0e3e  E:/competition/4_metrics/logs/2026-10-18_yolo_m10_r10_rom_rebake_run01/coe/R10/strip.coe
6e67b47abd533d2bc11491331f1694aa95f605f9de437cc633ace585554d1883  E:/competition/4_metrics/logs/2026-10-18_yolo_m10_r10_rom_rebake_run01/coe/R10/lut.coe
02f854f976907e866f3d6b3c059dfa34e9fa6fdde3593580aba66a830a10ba89  E:/competition/4_metrics/logs/2026-10-18_yolo_m10_r10_rom_rebake_run01/coe/R10/iss.coe
d4c0d0de04791d44ae0470e17c8970386e01754181bc00d1ca1bb3cf4d9a15d2  E:/competition/4_metrics/logs/2026-10-18_yolo_m10_r10_rom_rebake_run01/coe/R10/geo.coe
9299ee2edc6af036a1b6c9501f3e7bf1786e840ed938d559ed3c0b1d99f624dd  E:/competition/4_metrics/logs/2026-10-18_yolo_m10_r10_rom_rebake_run01/coe/R10/wlay.coe
f2a308b5a4f25a176324da784189662c32b098fc115e4965433f44ab4a04196d  E:/competition/4_metrics/logs/2026-10-24_integration_build_ac_run01/vivado_v25/yolo_v25_board/yolo_v25_board.srcs/sources_1/ip/yolo_buf_bram/yolo_buf_bram.xci
1cb8037a28cfd902f32fdcb1814c306c0da4d68511ece6f3990948eda6c948c3  E:/competition/12_yolo_accel/yolo_dma_csr/rtl/ps_axi_pl/ip/yolo_buf_bram/yolo_buf_bram.xci
d99bfbd0c3b5186a1cc0f423d5d274cd859d0a948be5ea626af58a4073993474  E:/competition/4_metrics/logs/2026-10-24_integration_build_ac_run01/vivado_v25/yolo_v25_board/yolo_v25_board.srcs/sources_1/ip/yolo_desc_bram/yolo_desc_bram.xci
a7ddba934cdcd948400dd96b8100410a476209f8e462bac121f9eaac5df37c2d  E:/competition/12_yolo_accel/yolo_dma_csr/rtl/ps_axi_pl/ip/yolo_desc_bram/yolo_desc_bram.xci
d3839e1f346b7164a8af93c787154bc2f6aca4d93362180ffc38e5bf11ae8260  E:/competition/4_metrics/logs/2026-10-24_integration_build_ac_run01/vivado_v25/yolo_v25_board/yolo_v25_board.srcs/sources_1/ip/yolo_lut_bram/yolo_lut_bram.xci
ac07c4cb37d4e9bd525b437cc3808fb2d4314dd30b976f053a0d9784b0ee0707  E:/competition/12_yolo_accel/yolo_dma_csr/rtl/ps_axi_pl/ip/yolo_lut_bram/yolo_lut_bram.xci
a8b4131549d5022a55bd7707dcee7db03ded6f72d46fff3a267fced8b09ad692  E:/competition/4_metrics/logs/2026-10-24_integration_build_ac_run01/vivado_v25/yolo_v25_board/yolo_v25_board.srcs/sources_1/ip/yolo_quant_bram/yolo_quant_bram.xci
13d310901cb0036a47db889b65feb6fdc3117e0af09288ae3ac8022cd4642c98  E:/competition/12_yolo_accel/yolo_dma_csr/rtl/ps_axi_pl/ip/yolo_quant_bram/yolo_quant_bram.xci
bb8a9aee5c0ef69445585b8b158b36ebbef80fe8c1e97e1d3dab670f4531cb79  E:/competition/4_metrics/logs/2026-10-24_integration_build_ac_run01/vivado_v25/yolo_v25_board/yolo_v25_board.srcs/sources_1/ip/yolo_ring_bram/yolo_ring_bram.xci
71cb1c61d6df0c3ae280c7fcd6228e0c99aafa0327fde3c336ac77ea26847c5e  E:/competition/12_yolo_accel/yolo_dma_csr/rtl/ps_axi_pl/ip/yolo_ring_bram/yolo_ring_bram.xci
