pipidandan-superman/FPGA_2026_competition/src/accelerator/isa_tables/view_alias_fields.xlsx

Sheet: 总览
VIEW 地址别名格式总览
项目 | 格式/值 | 说明
是否有运行时指令 | 没有 | 当前 VIEW 不进入 PPU DESC，也不占用 CONV ROM
逻辑 opcode | 0x10 | 只作为统一逻辑算子编号，不表示会启动 VIEW 引擎
硬件位域 | 无 | 不能给 VIEW 虚构指令位宽；表中只记录编译期元数据
地址公式 | view_base = parent_base + c0×H×W | CHW 连续布局下的通道别名
运行时行为 | 零搬移 | 后续 CONV/PPU 直接使用别名地址读取父张量

Sheet: VIEW字段
字段 | 记录形式 | 位宽/性质 | split0 值 | split1 值 | 含义
逻辑ID | desc_id | 编译期元数据，非硬件位域 | 3 | 4 | 整网逻辑描述符编号
节点 | node | 字符串 | model.2.split0 | model.2.split1 | 视图名称
逻辑 opcode | 0x10 | 8 bit 逻辑编号，不运行时派发 | 0x10 | 0x10 | 仅统一逻辑分类
父 BUF | parent_buf | 索引，非独立运行时指令字段 | 3 | 3 | 被切分的父张量
输出 BUF | out_buf | 索引，非独立运行时指令字段 | 4 | 5 | 别名视图编号
起始通道 | c0 | 编译期整数 | 0 | 16 | 包含该通道
结束通道 | c1 | 编译期整数 | 16 | 32 | 不包含该通道
通道数 | c1-c0 | 编译期计算 | 16 | 16 | 视图通道数
高度 | H | 编译期整数 | 80 | 80 | 与父张量一致
宽度 | W | 编译期整数 | 80 | 80 | 与父张量一致
视图字节数 | (c1-c0)×H×W | 编译期计算 | 102400 | 102400 | 16×80×80
别名偏移 | c0×H×W | 编译期计算 | 0 | 102400 | 相对父 BUF 基址
地址公式 | parent_base+c0×H×W | 无运行时位域 | parent_base+0 | parent_base+102400 | 后续指令直接使用

Sheet: 真实示例
节点 | 父BUF | 输出BUF | c0 | c1 | H | W | 别名偏移 | 别名地址
model.2.split0 | 3 | 4 | 0 | 16 | 80 | 80 | 0 | parent_base+0
model.2.split1 | 3 | 5 | 16 | 32 | 80 | 80 | 102400 | parent_base+102400

Sheet: Sources
Source Name | Source URL
descriptor_table.json | E:\competition\13_final\PL_YOLOV8N_CONTINUOUS\descriptor_table.json
layout.json | E:\competition\13_final\PL_YOLOV8N_CONTINUOUS\prog\layout.json
