pipidandan-superman/FPGA_2026_competition/board/form3_pspl_resident/prog/tb_setup_six_branches.txt

# D0 derived from B12/v20 volume; only EE/DE/S-v1 fields changed.
# Source SHA-256=c7aa1e72d170eac996cc09a2b4d90da1dd9e7722a392e7018fe60f77ec5b34ca
# T2-4 plfront G5 stage-2 装载/段程序（tb_setup.txt，R35 三段定案，302400->149100）
# W=CSR 面 P=岛面 S=段界 M/T=cv/plan 镜像 R=回滚 H=heads 段界
# PAGE_CTRL: {auto_adv@19, npages_raw@18:16}（m9_abi_v2_csr L469-473）
#   S1 raw2=3 页 0x000A0000 / S2 raw0=legacy 0x00080000 / S3 raw4=5 页 0x000C0000
# S2 = legacy 单页（cv 行 0..4 镜像 P2 五 conv + plan 段同步镜像；
#   镜像只搬首槽，双槽第二槽硬件不读）
# 0xDE：S1=0 / S2=0x11（model.9.cv2/12.cv2 位图物化）/ S3=0。
# heads：6 源面 reg0..2+cls0..2，out_bytes=149100（reg 134400+cls 14700）。
W 04 10000000
W 08 10000000
W 0C 10000000
W E9 00000000
W EA 00000000
W EA 00000000
W EA 00000000
W EA 00000000
W EA 00000000
W EA 00000000
W EA 00000000
W EA 00000000
W E9 00000008
W EA 00000000
W EA 00000000
W EA 00000000
W EA 00000000
W EA 00000000
W EA 00000000
W EA 00000000
W EA 00000000
W E9 00000010
W EA 00000000
W EA 00000000
W EA 00000000
W EA 00000000
W EA 00000000
W EA 00000000
W EA 00000000
W EA 00000000
W E9 00000018
W EA 00000000
W EA 00000000
W EA 00000000
W EA 00000000
W EA 00000000
W EA 00000000
W EA 00000000
W EA 00000000
W E9 00000020
W EA 00000000
W EA 00000000
W EA 00000000
W EA 00000000
W EA 00000000
W EA 00000000
W EA 00000000
W EA 00000000
W E9 00000028
W EA 00000000
W EA 00000000
W EA 00000000
W EA 00000000
W EA 00000000
W EA 00000000
W EA 00000000
W EA 00000000
W E9 00000030
W EA 00000000
W EA 00000000
W EA 00000000
W EA 00000000
W EA 00000000
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
W 38 0000005a
S 3 19200 0
W EE 00040000
W DE 00060000
W 10 03124058
W 38 0000005a
S 4 39100 0
W EE 00040000
W DE 00090000
W 10 03124058
W 38 0000005a
S 5 307200 0
W EE 00040000
W DE 000c0000
W 10 03124058
W 38 0000005a
S 6 625600 0
W EE 00040000
W DE 000f0000
W 10 03124058
W 38 0000005a
