pipidandan-superman/FPGA_2026_competition/board/form2_pl_continuous/prog/tb_setup_d0_s_v1_db4_up2x_meta_quant.txt

# D0 derived from B12/v20 volume; only EE/DE/S-v1 fields changed.
# Source SHA-256=c7aa1e72d170eac996cc09a2b4d90da1dd9e7722a392e7018fe60f77ec5b34ca
# T2-4 plfront G5 stage-2 装载/段程序（tb_setup.txt，R35 三段定案，302400->149100）
# W=CSR 面 P=岛面 S=段界 M/T=cv/plan 镜像 R=回滚 H=heads 段界
# PAGE_CTRL: {auto_adv@19, npages_raw@18:16}（m9_abi_v2_csr L469-473）
#   S1 raw2=3 页 0x000A0000 / S2 raw0=legacy 0x00080000 / S3 raw4=5 页 0x000C0000
# S2 = legacy 单页（cv 行 0..4 镜像 P2 五 conv + plan 段同步镜像；
#   镜像只搬首槽，双槽第二槽硬件不读）
# 0xDE：S1=0 / S2=0x11（model.9.cv2/12.cv2 位图物化）/ S3=0。
# heads：6 源面 reg0..2+cls0..2，out_bytes=149100（reg 134400+cls 14700）。
W 04 10000000
W 08 10000000
W 0C 10000000
W 10 02124058
W 14 001400c0
W 18 11110014
W 1C 00800000
W 20 000038c0
W 24 00000080
W 28 00000000
W 2C 00000000
W 30 00000600
W 34 000000c0
W EB 00000000
# --- PPU 岛表（BUF/QUANT/DESC/A_DESC_COUNT/A_HEAD_BASE，heads 除外） ---
P 3000 1012c000
P 3004 00000000
P 3008 00019000
P 300c 00001900
P 3010 00500010
P 3014 01000050
P 3018 000000ff
P 301c 00000000
P 3020 100fa000
P 3024 00000000
P 3028 00019000
P 302c 00001900
P 3030 00500010
P 3034 01000050
P 3038 000000ff
P 303c 00000000
P 3040 10145000
P 3044 00000000
P 3048 00019000
P 304c 00001900
P 3050 00500010
P 3054 01000050
P 3058 000000ff
P 305c 00000000
P 3060 100e1000
P 3064 00000000
P 3068 00019000
P 306c 00001900
P 3070 00500010
P 3074 01000050
P 3078 000000ff
P 307c 00000000
P 3080 1015e000
P 3084 00000000
P 3088 0004b000
P 308c 00001900
P 3090 00500030
P 3094 01000050
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
P 104c 00006400
P 1050 0000003b
P 1054 00001900
P 1058 0000003c
P 105c 00002bc0
P 1060 0000003d
P 1064 00000af0
P 1068 0000003e
P 106c 000002bc
P 1070 00000000
P 1074 00000000
P 1078 00000000
P 107c 00000000
P 104 00000000
P 108 00000001
P 110 00000001
P 114 00000002
P 010 00000005
