pipidandan-superman/FPGA_2026_competition/build/validation_status.md

# 当前验证状态

更新日期：2026-11-04（Asia/Shanghai）。本表区分历史结果、本次静态检查、Vivado 工程验证、完整 BIT 重建和板级验证。历史板卡时钟为 2022 年，不能用它推断实际测试日期。

## 本次复验结果

| 对象 | 当前结果 | 证据与限制 |
|---|---|---|
| 包内文件与命名 | 静态检查通过 | 六个 XPR 的非生成引用均在包内且存在；文件名小写规范检查无违规；Python AST 无语法错误 |
| 形态一A预处理工程 | Vivado 工程验证通过 | `2026-11-04_amd_form1a_pl_preprocess_validate_run01`；`PACKAGE_PROJECT_VALIDATION_PASS`；未执行完整 BIT 重建 |
| 形态一A BLE J5 工程 | Vivado 工程验证通过 | `2026-11-04_amd_form1a_ble_bridge_j5_validate_run01`；候选工程，不能当作现役集成验收；未执行完整 BIT 重建 |
| AC1 工程 | Vivado 工程验证通过 | `2026-11-04_amd_ac1_validate_run02`；补回两个模块引用 XCI 后通过；未执行完整 BIT 重建，历史实现报告仍保留 |
| 形态一B完整构建 | BIT/XSA 重建通过 | `2026-11-03_amd_form1b_build_run01`；WNS +0.153 ns、WHS +0.010 ns；新制品未据此自动获得板证 |
| 形态二工程 | Vivado 工程验证通过 | `2026-11-04_amd_form2_validate_run01`；BD 校验通过；最近一次完整构建 `2026-11-03_amd_form2_build_run03` 在子 IP 综合阶段失败，不能标记完整重建通过 |
| 形态三完整构建 | BIT/XSA 重建通过 | `2026-11-03_amd_form3_build_run03`；WNS +0.030 ns、WHS +0.017 ns；DRC 0 Error；新制品未据此自动获得板证 |
| 重建时序覆盖 | 仍有告警 | 形态三 TIMING-6/7/51 各 1 条，10 个输入、25 个输出无 delay 约束；不能宣称所有接口/CDC 已闭合 |
| OSD 正向/负控仿真 | 四项全部通过 | `2026-11-04_amd_osd_regression_run02`：XSim 冒烟、COCO、姿态、历史字体负控；总标记 `OSD_REGRESSION_PASS` |
| 三种部署树 | 离线生成通过 | 一B 53 文件；形态二含固定输入入口共 109 文件；形态三 120 文件；均未上传、未改变硬件状态 |
| 形态二固定输入入口 | 已交付，未板测 | `verify_form2.py` + `fixed_input_check.py`；要求 21/21 黄金平面及原服务恢复；仅完成语法、路径和部署树核验 |
| 技术报告 | 文档门与渲染通过 | V8 标准排版修订版含 18 张实图、16 表、14 项独立著录参考文献；完整 DOCX 验证通过；41 页全部检查，无空白页、内容丢失、裁切或重叠；最终 MinerU=`MINERU_PARSE_PASS`；V4 历史报告保留 |
| 许可与第三方声明 | 已补齐 | 原创作品 MIT；`third_party_notices.md` 与 `licenses/` 区分 AGPL-3.0、Apache-2.0、BSD 及数据条款 |

## 历史板测与证据边界

- 形态三历史交付 BIT 为 `72b358ff75a8d1c1bda519da248bd94fb4bdc236dd16fcca36eb4fc1262f7a58`，对应 WNS/WHS +0.255/+0.020 ns。最终 488 帧记录中位 2496.7375 ms、均值 2554.553 ms、23 次恢复、七类检出；严格序列另以对应板测记录为准。
- 形态三新增严格七手势展示记录为 69 帧、69 个不同输入哈希，七类均达到连续两帧阈值；该结果只覆盖历史 BIT 和当时软件，不是新重建 BIT 的板证，也不是统计数据集准确率。
- 形态二历史连续日志共 83 帧，中位 11023.045 ms，仅覆盖六类，缺 Down；不得写成七类全部通过。新增固定输入入口尚未执行，不改变这一边界。
- Overlay skill 的基线热加载、变化帧、释放和恢复已有实测；该结论不覆盖竞赛 BIT、UDP 接收或手势准确率。
- 早期原服务恢复失败予以保留；后续采用 10 秒稳定等待和 30 秒首帧窗口的独立副本恢复成功。临时服务配置不等同永久修改。
- C-leg 历史 PASS 只表示与旧基线等价，包含既存故障，不等于全图正确性 PASS。

## 尚未执行或不能宣称完成的事项

1. 形态一A两版、形态二和 AC1 的完整 BIT/XSA 重建；形态二最近一次完整构建失败已保留。
2. 形态二新增固定输入入口的板端 21/21 比对和恢复验证；一B/二当前部署的完整启动与恢复板测。
3. 纯 PL 连续链 Down 类实测补证；没有新证据前维持“六类、缺 Down”。
4. 指定第二角度、基座细节和同手势 A/B 等实物补拍。
5. 公开仓库的实际提交/推送状态以目标 GitHub 页面为准；文档中的目标地址本身不代表已经发布。

完整本机证据在工作区 `4_metrics/logs/<run-name>/`，选入提交包的证据见 `board/`、`sim/` 和 `board/skill_validation/`。原始失败日志保留，不用新结果覆盖。完整文件身份由根目录 `sha256_manifest.txt` 和 `binary_sha256.txt` 核验。
