pipidandan-superman/FPGA_2026_competition/board/form1a_ble_bridge_j5/vivado_project/only_nanodet_ble.srcs/constrs_1/new/pin_zynq7020_cam.xdc

set_property PACKAGE_PIN M19 [get_ports clk_in1_0]
set_property IOSTANDARD LVCMOS33 [get_ports clk_in1_0]
# EES-331 routes the fixed 100 MHz PL reference to non-CCIO M19. Vivado
# therefore needs the real primary-clock constraint and an explicit waiver
# for the IBUF-to-PLL non-dedicated path.
create_clock -period 10.000 -name clk_in1_0 [get_ports clk_in1_0]
# Post-link clock net and PLL constraints are in action_v1_clock_impl.xdc.
set_property PACKAGE_PIN Y20 [get_ports sccb_clk_0]
set_property IOSTANDARD LVCMOS33 [get_ports sccb_clk_0]
set_property PACKAGE_PIN L18 [get_ports resetn_0]
set_property IOSTANDARD LVCMOS33 [get_ports resetn_0]
set_property PACKAGE_PIN W22 [get_ports {cam_data_0[0]}]
set_property PACKAGE_PIN V22 [get_ports {cam_data_0[1]}]
set_property PACKAGE_PIN W21 [get_ports {cam_data_0[2]}]
set_property PACKAGE_PIN W20 [get_ports {cam_data_0[3]}]
set_property PACKAGE_PIN V20 [get_ports {cam_data_0[4]}]
set_property PACKAGE_PIN U20 [get_ports {cam_data_0[5]}]
set_property PACKAGE_PIN V19 [get_ports {cam_data_0[6]}]
set_property PACKAGE_PIN V18 [get_ports {cam_data_0[7]}]
set_property IOSTANDARD LVCMOS33 [get_ports {cam_data_0[7]}]
set_property IOSTANDARD LVCMOS33 [get_ports {cam_data_0[6]}]
set_property IOSTANDARD LVCMOS33 [get_ports {cam_data_0[5]}]
set_property IOSTANDARD LVCMOS33 [get_ports {cam_data_0[4]}]
set_property IOSTANDARD LVCMOS33 [get_ports {cam_data_0[3]}]
set_property IOSTANDARD LVCMOS33 [get_ports {cam_data_0[2]}]
set_property IOSTANDARD LVCMOS33 [get_ports {cam_data_0[1]}]
set_property IOSTANDARD LVCMOS33 [get_ports {cam_data_0[0]}]
set_property PACKAGE_PIN AB21 [get_ports cam_href_0]
set_property PACKAGE_PIN AA22 [get_ports cam_pclk_0]
set_property PACKAGE_PIN AA21 [get_ports cam_vsync_0]
set_property PACKAGE_PIN AB22 [get_ports cam_xclk_0]

# The camera returns PCLK at the configured xclk frequency: 24.03846 MHz.
create_clock -period 41.600 -name cam_pclk [get_ports cam_pclk_0]
# The camera PCLK physical routing exception is implementation-only.

set_property PACKAGE_PIN V4 [get_ports sccb_cfg_done_0]
set_property PACKAGE_PIN Y21 [get_ports sccb_data_0]
set_property IOSTANDARD LVCMOS33 [get_ports cam_href_0]
set_property IOSTANDARD LVCMOS33 [get_ports cam_pclk_0]
set_property IOSTANDARD LVCMOS33 [get_ports cam_vsync_0]
set_property IOSTANDARD LVCMOS33 [get_ports cam_xclk_0]
set_property IOSTANDARD LVCMOS33 [get_ports sccb_cfg_done_0]
set_property IOSTANDARD LVCMOS33 [get_ports sccb_data_0]

# EES-331 PL HDMI / ADV7511 constraints (User Manual pages 32-33)
set_property PACKAGE_PIN R7   [get_ports {HDMI_DATA_0[0]}]
set_property PACKAGE_PIN V10  [get_ports {HDMI_DATA_0[1]}]
set_property PACKAGE_PIN V9   [get_ports {HDMI_DATA_0[2]}]
set_property PACKAGE_PIN V8   [get_ports {HDMI_DATA_0[3]}]
set_property PACKAGE_PIN W8   [get_ports {HDMI_DATA_0[4]}]
set_property PACKAGE_PIN W11  [get_ports {HDMI_DATA_0[5]}]
set_property PACKAGE_PIN W10  [get_ports {HDMI_DATA_0[6]}]
set_property PACKAGE_PIN V12  [get_ports {HDMI_DATA_0[7]}]
set_property PACKAGE_PIN W12  [get_ports {HDMI_DATA_0[8]}]
set_property PACKAGE_PIN U12  [get_ports {HDMI_DATA_0[9]}]
set_property PACKAGE_PIN U11  [get_ports {HDMI_DATA_0[10]}]
set_property PACKAGE_PIN U10  [get_ports {HDMI_DATA_0[11]}]
set_property PACKAGE_PIN U9   [get_ports {HDMI_DATA_0[12]}]
set_property PACKAGE_PIN AA12 [get_ports {HDMI_DATA_0[13]}]
set_property PACKAGE_PIN AB12 [get_ports {HDMI_DATA_0[14]}]
set_property PACKAGE_PIN AA11 [get_ports {HDMI_DATA_0[15]}]
set_property PACKAGE_PIN AB11 [get_ports HDMI_INT_0]
set_property PACKAGE_PIN AB10 [get_ports HDMI_SCL_0]
set_property PACKAGE_PIN AB9  [get_ports HDMI_SDA_0]
set_property PACKAGE_PIN Y11  [get_ports HDMI_VSYNC_0]
set_property PACKAGE_PIN Y10  [get_ports HDMI_HSYNC_0]
set_property PACKAGE_PIN AA9  [get_ports HDMI_DE_0]
set_property PACKAGE_PIN Y8   [get_ports HDMI_CLK_0]

set_property IOSTANDARD LVCMOS33 [get_ports {HDMI_DATA_0[0]}]
set_property IOSTANDARD LVCMOS33 [get_ports {HDMI_DATA_0[1]}]
set_property IOSTANDARD LVCMOS33 [get_ports {HDMI_DATA_0[2]}]
set_property IOSTANDARD LVCMOS33 [get_ports {HDMI_DATA_0[3]}]
set_property IOSTANDARD LVCMOS33 [get_ports {HDMI_DATA_0[4]}]
set_property IOSTANDARD LVCMOS33 [get_ports {HDMI_DATA_0[5]}]
set_property IOSTANDARD LVCMOS33 [get_ports {HDMI_DATA_0[6]}]
set_property IOSTANDARD LVCMOS33 [get_ports {HDMI_DATA_0[7]}]
set_property IOSTANDARD LVCMOS33 [get_ports {HDMI_DATA_0[8]}]
set_property IOSTANDARD LVCMOS33 [get_ports {HDMI_DATA_0[9]}]
set_property IOSTANDARD LVCMOS33 [get_ports {HDMI_DATA_0[10]}]
set_property IOSTANDARD LVCMOS33 [get_ports {HDMI_DATA_0[11]}]
set_property IOSTANDARD LVCMOS33 [get_ports {HDMI_DATA_0[12]}]
set_property IOSTANDARD LVCMOS33 [get_ports {HDMI_DATA_0[13]}]
set_property IOSTANDARD LVCMOS33 [get_ports {HDMI_DATA_0[14]}]
set_property IOSTANDARD LVCMOS33 [get_ports {HDMI_DATA_0[15]}]
set_property IOSTANDARD LVCMOS33 [get_ports HDMI_INT_0]
set_property IOSTANDARD LVCMOS33 [get_ports HDMI_SCL_0]
set_property IOSTANDARD LVCMOS33 [get_ports HDMI_SDA_0]
set_property IOSTANDARD LVCMOS33 [get_ports HDMI_VSYNC_0]
set_property IOSTANDARD LVCMOS33 [get_ports HDMI_HSYNC_0]
set_property IOSTANDARD LVCMOS33 [get_ports HDMI_DE_0]
set_property IOSTANDARD LVCMOS33 [get_ports HDMI_CLK_0]

set_property CFGBVS VCCO [current_design]
set_property CONFIG_VOLTAGE 3.3 [current_design]

# Action UART/LED pins are in the shared action_v1_pins.xdc.
