pipidandan-superman/FPGA_2026_competition/board/accelerator_ac1/vivado_project/deps/7493819f016e/yolo_pe_pack.v

/************************************************************************
 * File Name       : yolo_pe_pack.v
 * Developer       : LSL
 * Date            : 2026-09-15
 * Project Name    : AMD embodied sorting / EES-331 XC7Z020
 * Module Name     : yolo_pe_pack
 * Description     : M1 DSP48E1 dual-int8 packing PE (one DSP, two
 *                   independent w*x products per multiply). Serves one
 *                   OC row and two adjacent N columns of the GEMM array
 *                   (architecture baseline section 3.2, PROD tier).
 *
 *                   Corrected layout (M1 gate finding; the baseline
 *                   section 3.2 literal text fails for negative x --
 *                   exhaustive 2^24 evidence in pe_pack_vecgen.py and
 *                   run01 README):
 *                     A[24:0] = { x1[7:0], 9'b0, x0b[7:0] }
 *                               x0b = x0 + 128 (MSB flip, unsigned byte)
 *                               A = x1*2^17 + x0b exactly, x0b in [0,255]
 *                               needs no sign embedding (a signed low
 *                               operand cannot ride in the low field:
 *                               sign-extended gap injects +2^17*w into
 *                               the upper lane, zero gap injects 256*w
 *                               into the lower lane).
 *                     B[17:0] = sign-extended w
 *                     P       = A*B  (43-bit)
 *                     lane0   = $signed(P[16:0]) - (w <<< 7)
 *                               (P[16:0] = w*(x0+128); subtracting the
 *                               shifted broadcast w removes the bias --
 *                               wiring only, no multiplier)
 *                     lane1   = $signed(P[33:17]) + P[16]
 *                               (a negative low product borrows 1 from
 *                               the upper field; P[16] is exactly that
 *                               borrow as the low lane's sign bit)
 *                   Bounds: |w*(x0+128)| <= 127*255 = 32385 < 2^16 so
 *                   lane0_raw fits signed 17; |w*x| <= 127*128 = 16256
 *                   so both outputs fit signed 16 payload.
 *
 *                   V1.2 (2026-09-16, UG479 v1.10 full-compliance pass,
 *                   user directive "strictly per the manual"): the
 *                   primitive configuration now follows UG479 to the
 *                   letter:
 *                   (1) 3-stage multiply pipeline AREG=BREG=MREG=PREG=1
 *                       (UG479 p.14 "At least three pipeline registers
 *                       are required for both multiply ... to run at
 *                       full speed", p.47 "For multiplier-based designs,
 *                       the DSP48E1 slice requires a three-stage
 *                       pipeline"). ACASCREG=BCASCREG=1 forced by Table
 *                       2-3 (AREG=1 -> ACASCREG must be 1). MODULE
 *                       CONTRACT CHANGE: p0_o/p1_o are valid 3 cycles
 *                       after x and w presentation (inputs in cycle D ->
 *                       outputs in cycle D+3).
 *                   (2) Unused data ports tied per Table 2-2 note 1:
 *                       C/D tied High with the port register selected
 *                       and CE/RST Low (leakage power rule).
 *                   (3) Control attributes explicit: OPMODEREG=
 *                       CARRYINSELREG=0 (equal, UG479 p.41) and
 *                       ALUMODEREG=INMODEREG=CARRYINREG=0 -- controls
 *                       flow through, no hidden default-1 registers
 *                       (V1.1 left them at the Table 2-3 defaults of 1,
 *                       silently registering the static OPMODE/ALUMODE).
 *                   (4) Live pipeline registers get synchronous
 *                       active-high resets RSTA/RSTB/RSTM/RSTP (Table
 *                       2-4: reset has priority) from ~rst_n_i.
 *                   The lane0 bias correction consumes w DELAYED 3
 *                   cycles (w_d3_r) so it aligns with the registered P
 *                   (P in cycle D+3 reflects w from cycle D). Values
 *                   are unchanged -- M1 golden set stays valid; only
 *                   the latency contract moved.
 *
 *                   V1.1 context: the multiply became a direct DSP48E1
 *                   primitive instance (one DSP per PE) after Vivado
 *                   2025.2 decomposed the inferred packed product into
 *                   two 8-bit multipliers (228 DSP > 220-site budget).
 *                   OPMODE=7'b0000101 / ALUMODE=4'b0000 / INMODE=
 *                   5'b00000 keep P = A*B. Note: the unisim model gates
 *                   its OPMODE muxes for the first 100ns of simulation
 *                   ($time > 100000 in DSP48E1.v) -- TBs must not
 *                   compare inside that warm-up window.
 * Dependencies    : unisim DSP48E1 (xsim: xelab <tb> glbl -L unisim)
 * Revision History:
 *   - V1.0 (2026-09-15) by LSL : Initial release (M1). Bias-embedded
 *     packing proven exact by exhaustive 2^24 Python bit model +
 *     TB_PE_PACK_PASS; two rejected layouts (baseline literal and
 *     sign-extended gap) documented with their exhaustive fail counts.
 *   - V1.1 (2026-09-16) by LSL : DSP48E1 direct primitive instance
 *     (M12 B0 DSP over-mapping fix; exactly one DSP per PE). clk_i
 *     port added for the mandatory primitive CLK pin.
 *   - V1.2 (2026-09-16) by LSL : UG479 (v1.10) strict compliance --
 *     3-stage pipeline (AREG/BREG/MREG/PREG=1), C/D tie-off per
 *     Table 2-2 note 1, explicit flow-through control attributes,
 *     synchronous DSP resets via new rst_n_i port, w_d3 alignment
 *     delay. LATENCY 0 -> 3 cycles. Gate rerun: M1/M4/M8/M10/M11
 *     chain (frozen numeric contract).
 ************************************************************************/
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
