pipidandan-superman/FPGA_2026_competition/board/accelerator_ac1/vivado_project/deps/94252cd2b7c6/yolo_result_ring.sv

/************************************************************************
 * File Name       : yolo_result_ring.sv
 * Developer       : LSL
 * Date            : 2026-09-18
 * Project Name    : AMD embodied sorting / EES-331 XC7Z020
 * Module Name     : yolo_result_ring
 * Description     : Result metadata ring: 32 entries x 16 words stored
 *                   in a Block Memory Generator IP (yolo_ring_table).
 *                   The walker publishes one entry per frame (frame
 *                   id, seq, head base/bytes, quant profile); PS reads
 *                   entries through the 0x6000 window and acknowledges
 *                   via RESULT_ACK (consume/drop) which advances the
 *                   tail pointer owned by the register file.  Publish
 *                   on a full ring raises the overflow event and drops
 *                   the entry (seq still advances so PS can detect the
 *                   gap).  Acknowledge on an empty ring raises a
 *                   protocol error event.
 * Dependencies    : yolo_csr_pkg.sv, yolo_ring_table.sv (BMG IP)
 * Revision History:
 *   - V2.0 (2026-09-18) by LSL : Three-block FSM refactor; table write
 *                                port internalised; write-enable driven
 *                                one cycle early via next_state.
 *   - V1.0 (2026-09-18) by LSL : Initial release
 ************************************************************************/
`timescale 1ns / 1ps
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
