pipidandan-superman/FPGA_2026_competition/report/photos/photo_3_1_rig_and_arm_candidate.jpg

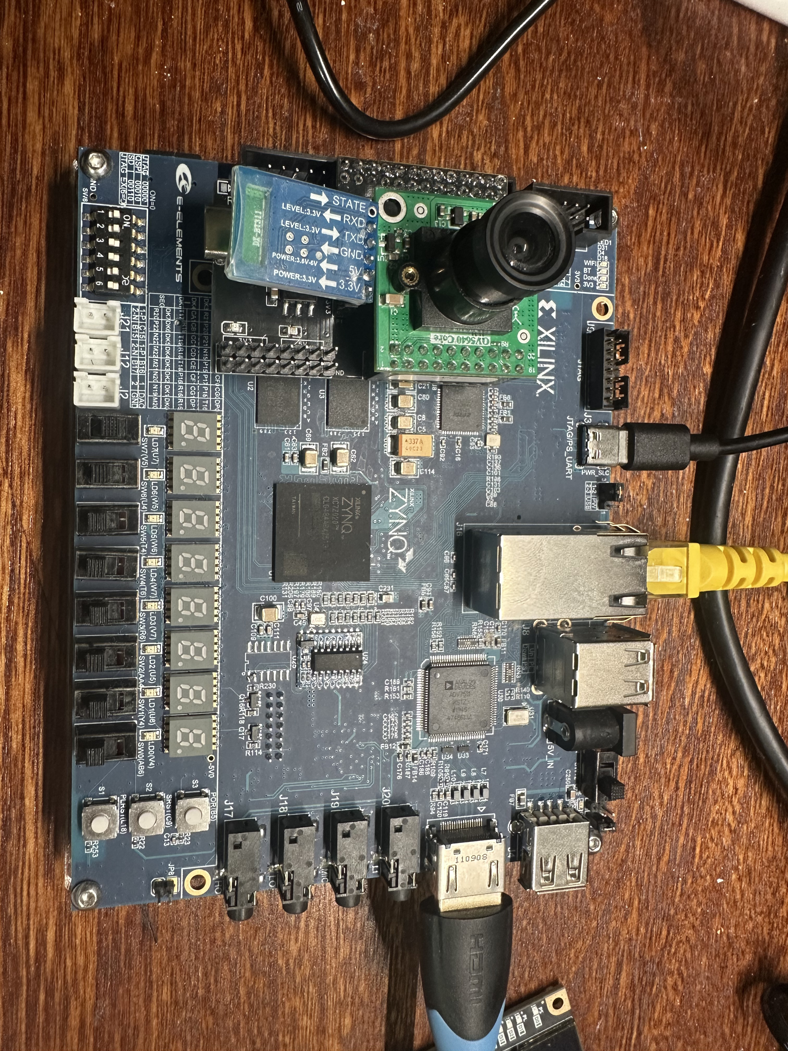
report/photos/photo_3_1_rig_and_arm_candidate.jpg
